keyboardpartner/HX3/HX_source/Reverb/readme.md

HX3 Reverb Sources
==================

HX3 Reverb DSP sources and project to be assembled with free SPIN IDE from Spin Semiconductor:

http://www.spinsemi.com/products.html

You might try your own reverb algorithm or one of the many examples found on the Spin Semi web page. Please note the controller pot usage in xxx_remap.spn assembler sources. HOAX3.spj is a complete project for the HX3 Reverb DSP, consisting of several reverb programs. Use tool hex2bin.exe to create a uploadable .BIN file. May be uploaded to HX3 with HX3 Remote software.

(c) by Carsten Meyer, cm@ct.de and KeyboardPartner UG, 1/2012.
