keyboardpartner/HX3/PLATINEN/MenuPanel/README.md

HX3 MenuPanel
=============

Schematics (schem), board placement (silk) and mechanical drawings (dim) for HX3 MenuPanel board as PDF (click on "view raw" to download), both for DAUB (daub) and GIE-TEC/Schaeffer (42mm) aluminum boxes.

".FPD" files are front bezel and back panel suggestions for Schaeffer AG Frontplattendesigner software (http://www.schaeffer-ag.de/de/download/frontplatten-designer.html) where you may order custom made front panels.
