keyboardpartner/HX3/PLATINEN/Preamp/PreAmp-Schematic.pdf

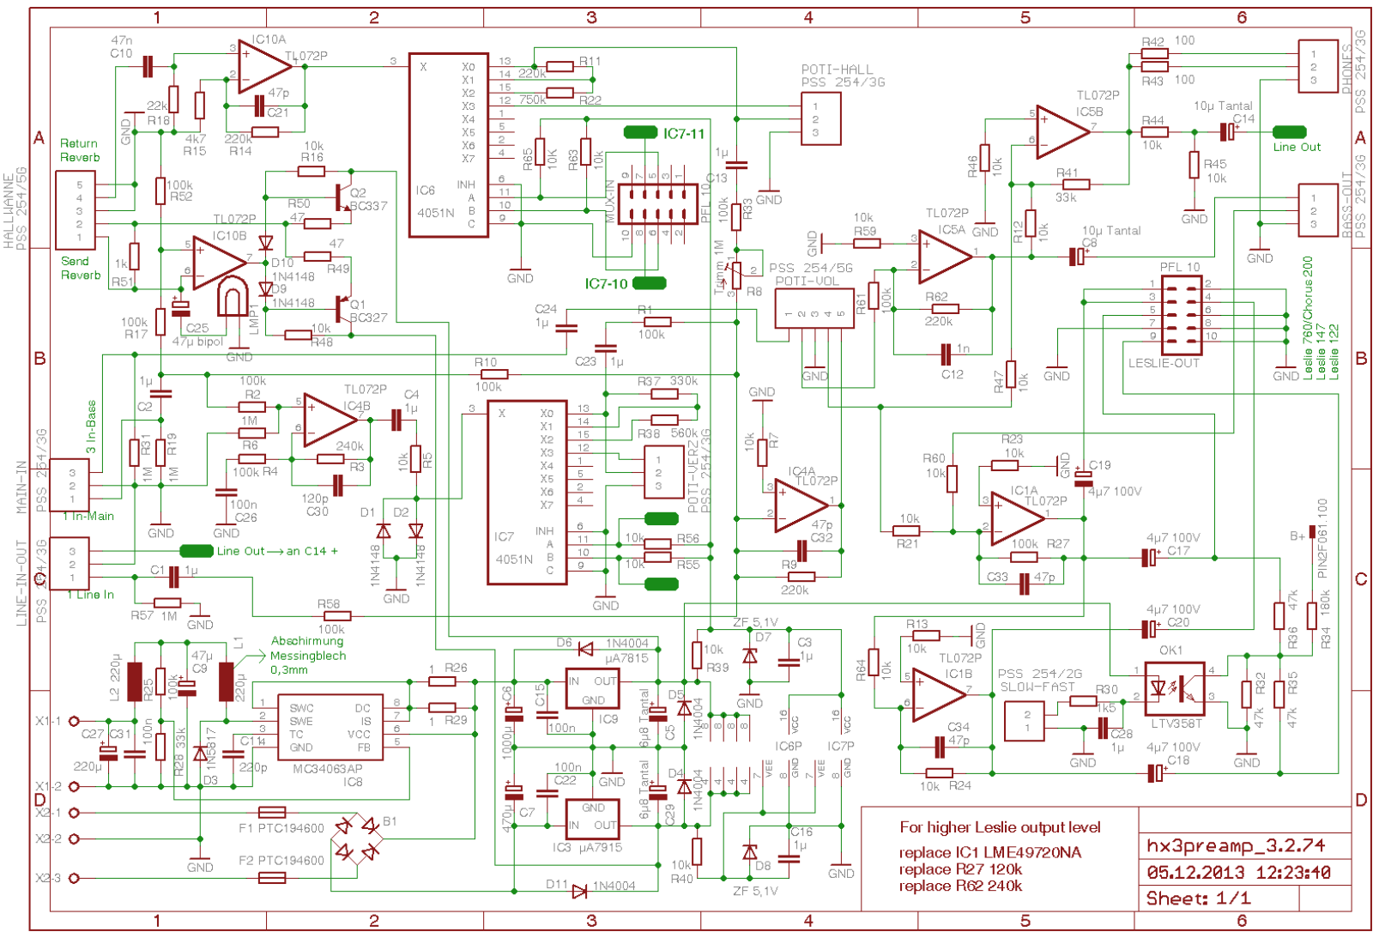
[picture p1: page 1]
