keyboardpartner/HX3/ARCHIVED_FIRMW/readme.md

HX3 Archived Firmware
=====================

<b>Archived older firmware</b>

Please note: These files are intended for reference use only and may contain known bugs.
Current firmwares may be found on **[LATEST] (https://github.com/keyboardpartner/HX3/tree/master/LATEST)** page.
