keyboardpartner/HX3/FOR_OEM/hoax_fuses.png

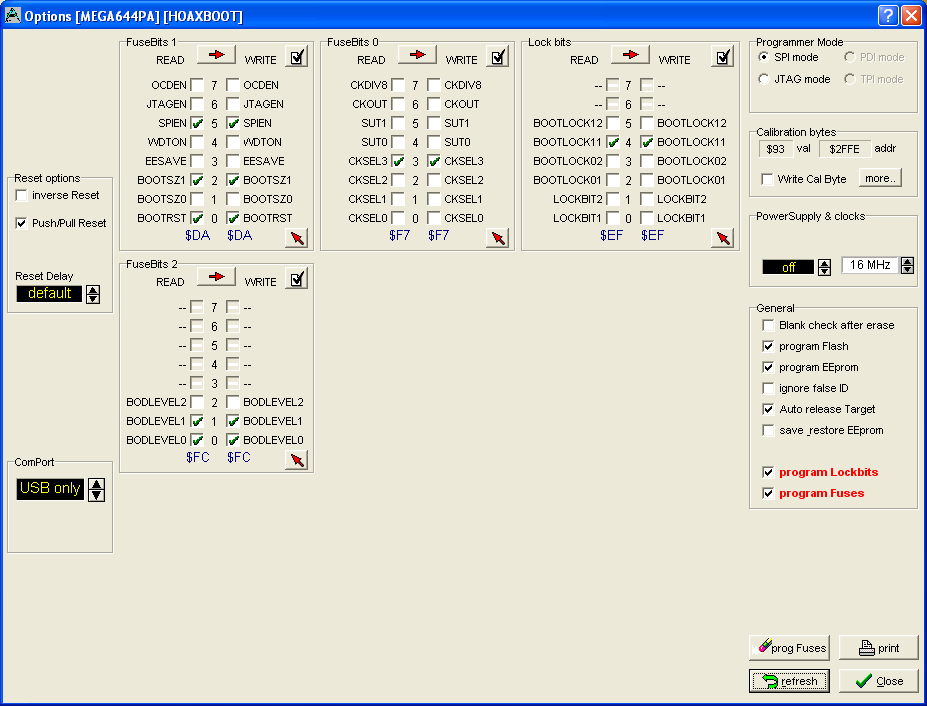
FOR_OEM/hoax_fuses.png
