keyboardpartner/HX3/(list of files, cad)

Other CAD files:
HX_source/Scan/HX_fatar.psm
HX_source/Scan/HX_fatar_33.psm
HX_source/Scan/HX_midi.psm
HX_source/Scan/HX_midi_33.psm
