keyboardpartner/HX3/(threads)

Thread 1 (2016-11-03):

Rotary not working with v4.20 BETA

BobMander, 2016-11-03:
I have a Plexi HX3. I downloaded the v4.20 BETA to test the new "TG Gears Tune" which does absolutely exactly what I was hoping it would do. I like to tune myself down to 432Hz rather than be at the ISO 440Hz. THANK YOU, THANK YOU, THANK YOU!!!

I did notice that the Rotary does not work with this BETA. The Rotary License does show as 'OK' but nothing I did in AudioJack settings [with the v4.11 HX3 Remote] allowed me to hear audio through the L/R Rotary. ORGAN and AMP both produce audio sound in the AudioJack settings.

I reverted back to v4.11 and all is well for now. Will wait for the final v4.20.
