keyboardpartner/HX3/PLATINEN/Bass25/schem_MIDIbass25_scan.pdf

PL9

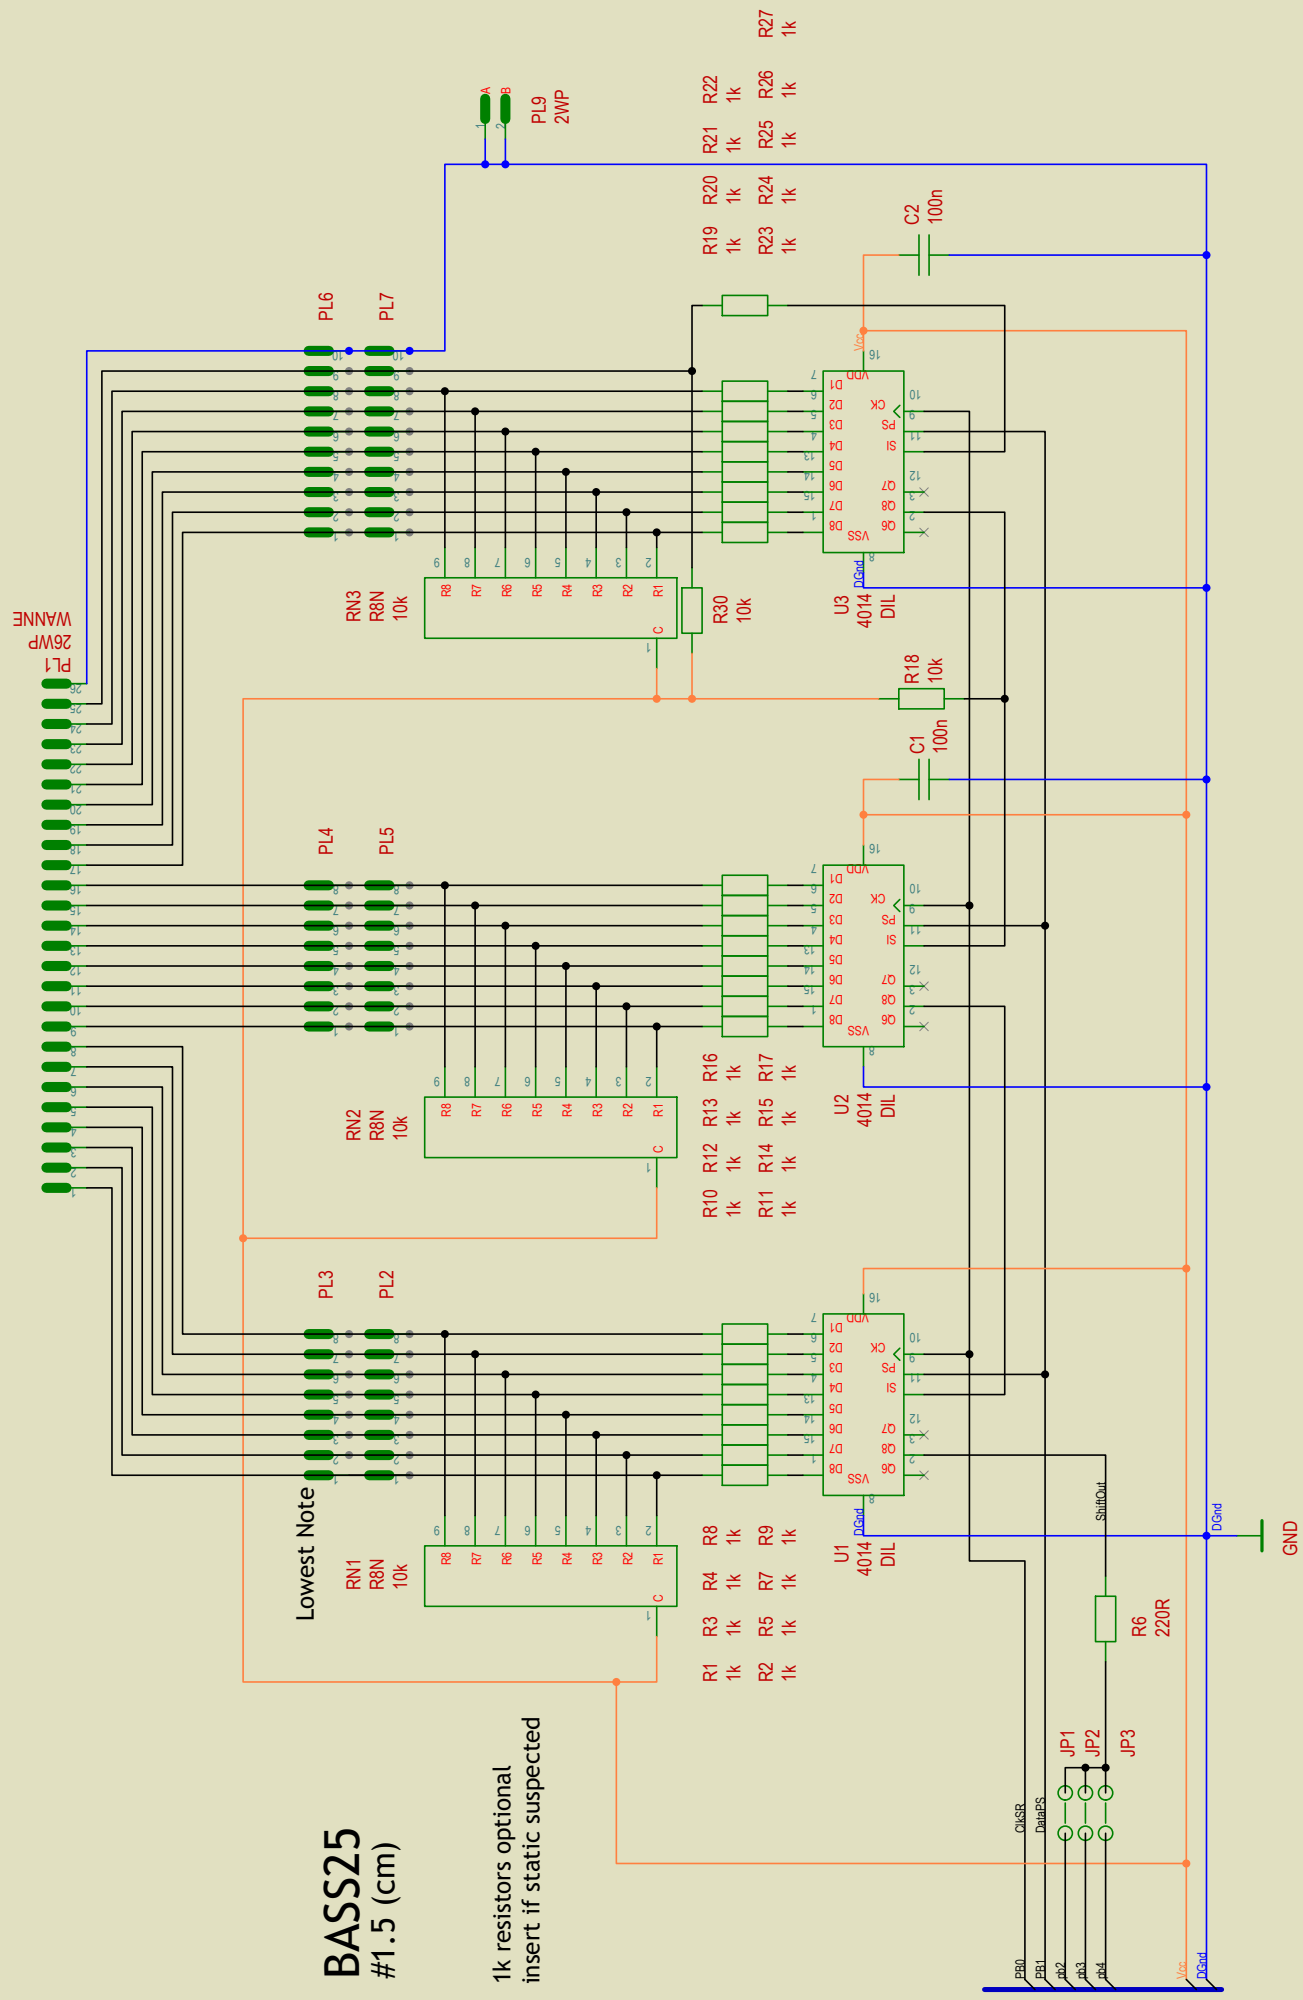
[picture p28: page 1]

insert if static suspected
