keyboardpartner/HX3/PLATINEN/XB2_mk3/best_10k_XB2_IF_30.pdf

# XB2 Output Board 3.0b

# Bestückung mit 10k-Potis

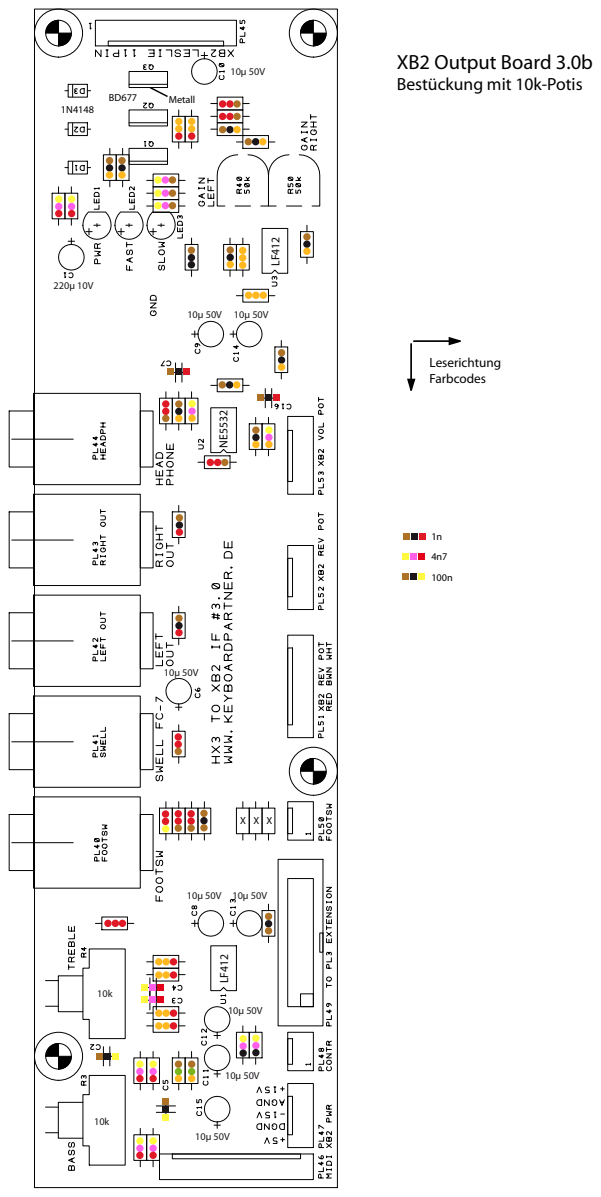
[picture p29: page 1]
Metall; Leserichtung Farbcodes
