keyboardpartner/HX3/PLATINEN/XB2_mk3/best_50k_XB2_IF_30.pdf

# XB2 Output Board 3.0b

# Bestückung mit 50k-Potis

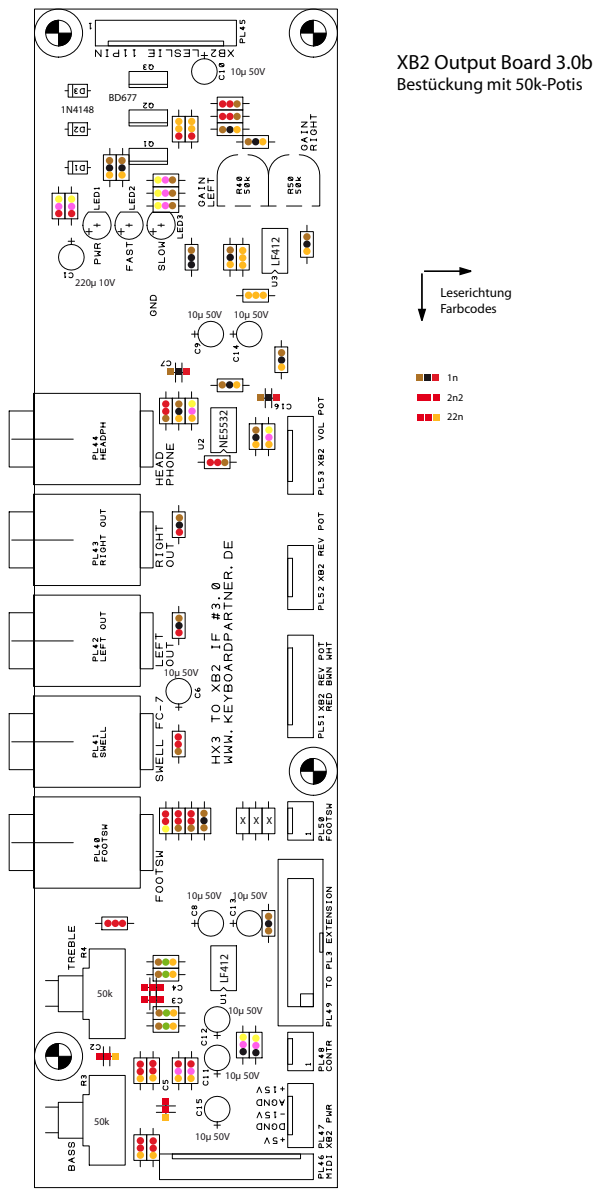
[picture p30: page 1]
Leserichtung Farbcodes
