keyboardpartner/HX3/PLATINEN/Extension_mk3/HX3_extension_best.pdf

# HX3 mk3/4 Extension Board Part Values

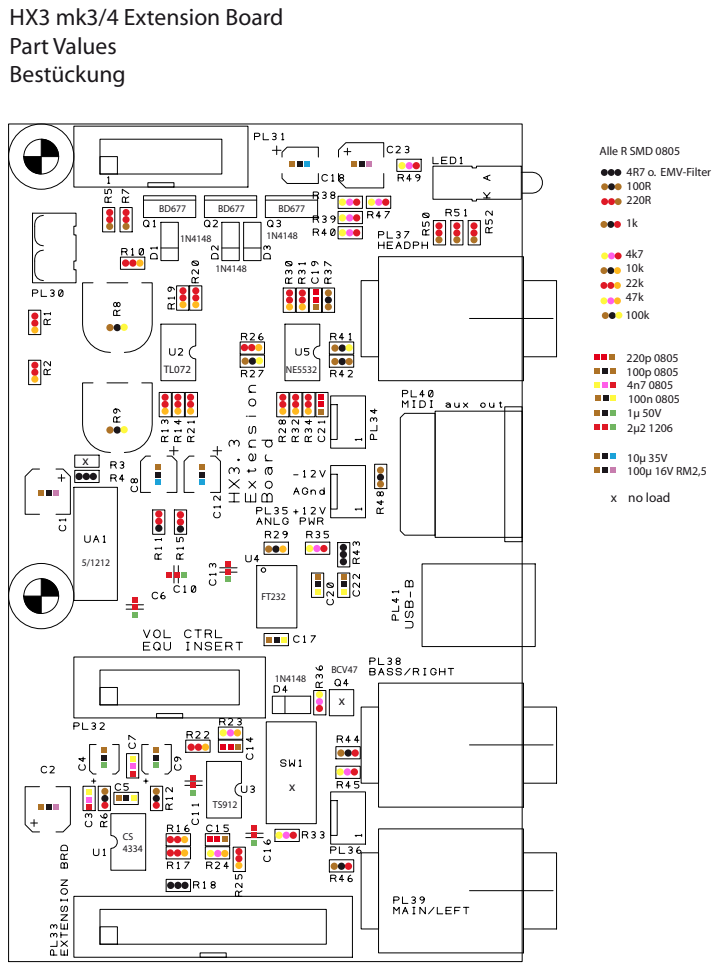
[picture p31: page 1]
BCV47; Alle R SMD 0805; 4R7 o. EMV-Filter 100R 220R; x no load; Bestückung
