keyboardpartner/HX3/PLATINEN/Adapter/schem_LDR_Leslie_IF.pdf

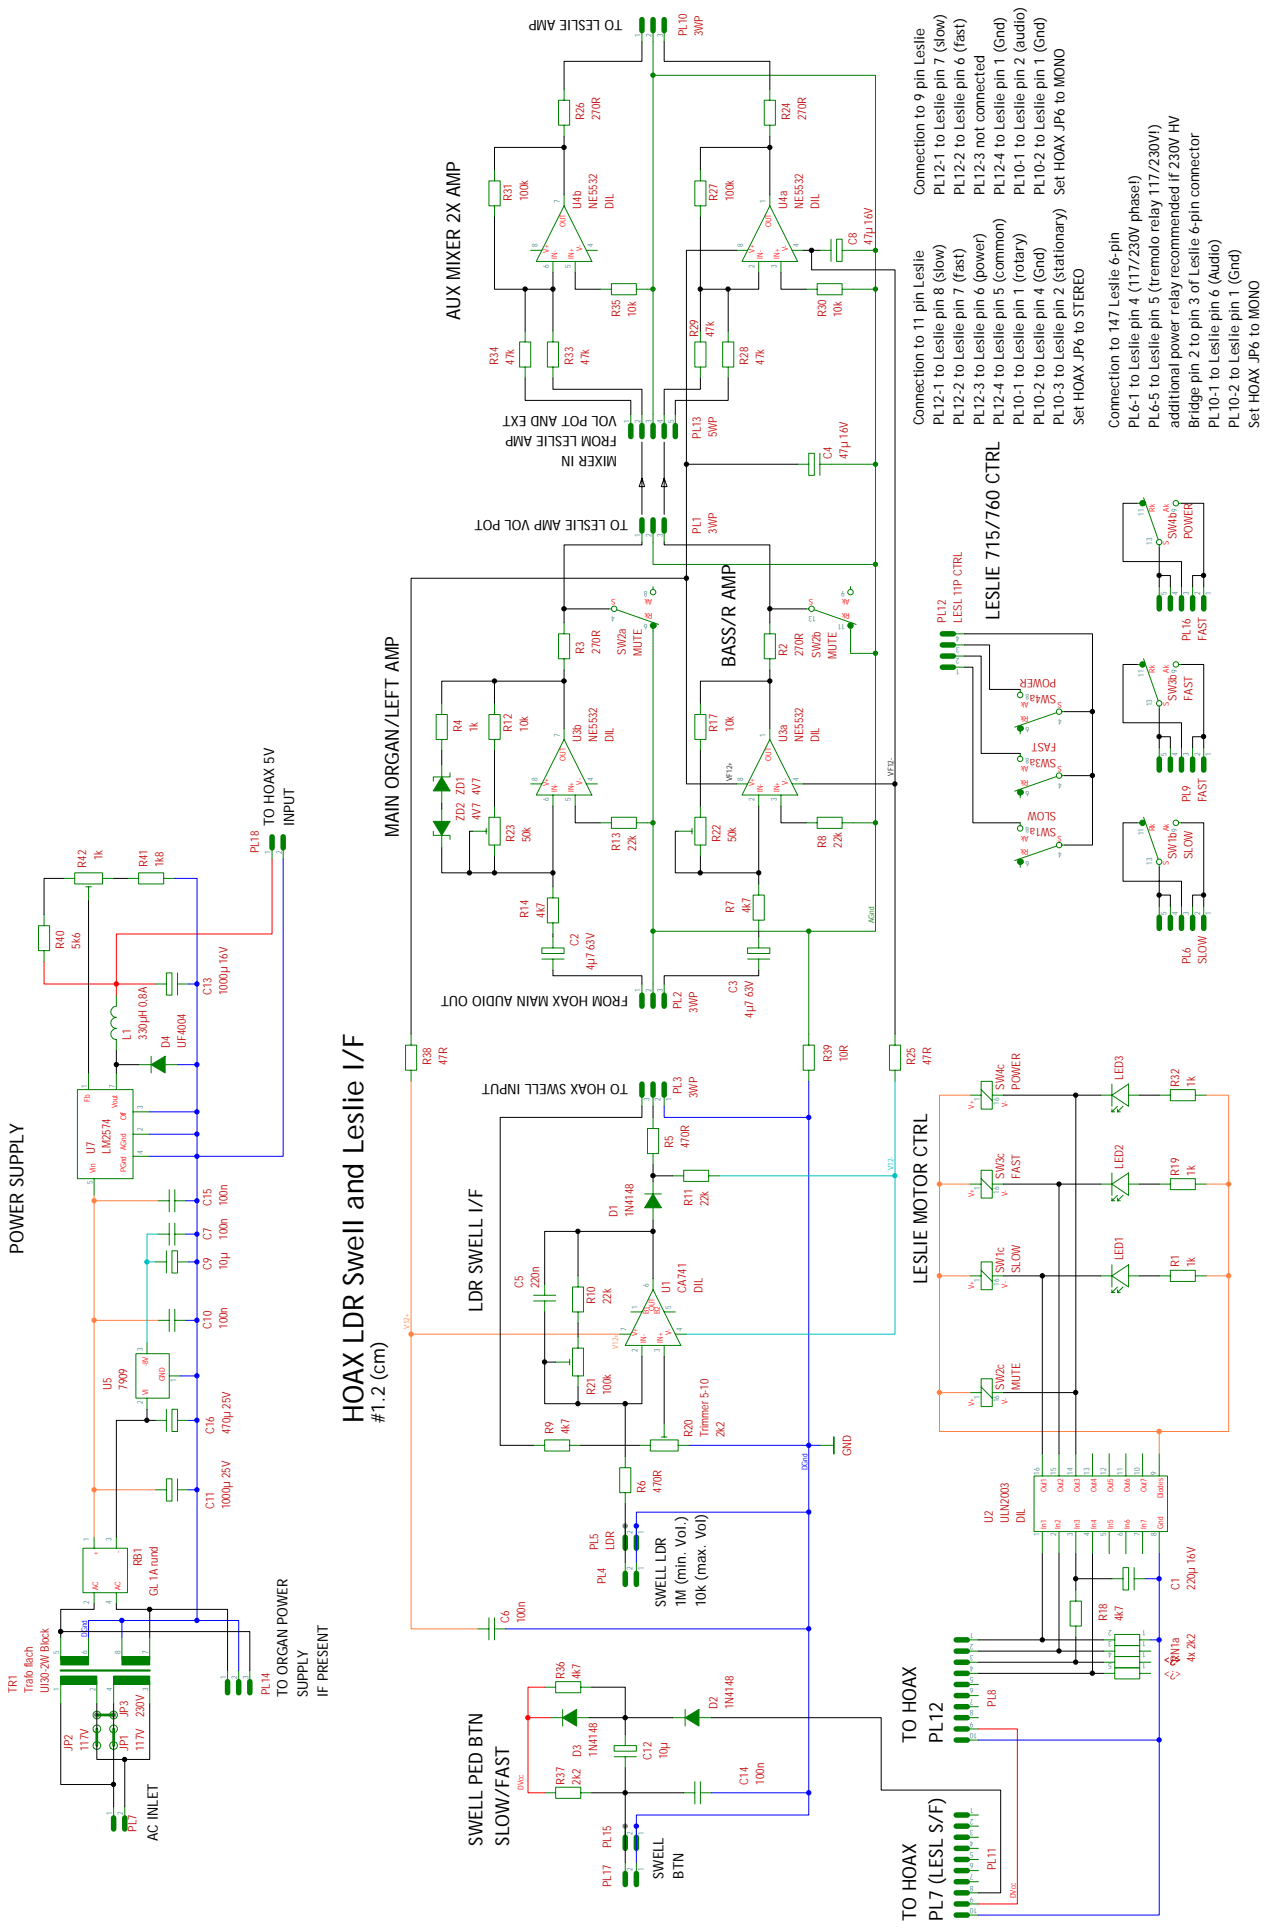
[picture p32: page 1]

PL10-1 to Leslie pin 2 (audio)

Connection to 9 pin Leslie

PL12-1 to Leslie pin 7 (slow)

PL12-2 to Leslie pin 6 (fast)

PL12-4 to Leslie pin 1 (Gnd)

PL10-2 to Leslie pin 1 (Gnd)

Set HOAX JP6 to MONO

PL6-5 to Leslie pin 5 (tremolo relay 117/230V!)

additional power relay recommended if 230V HV

Bridge pin 2 to pin 3 of Leslie 6-pin connector

PL6-1 to Leslie pin 4 (117/230V phase!)

PL12-4 to Leslie pin 5 (common)

PL10-3 to Leslie pin 2 (stationary)

PL12-3 to Leslie pin 6 (power)

PL10-1 to Leslie pin 1 (rotary)

Connection to 147 Leslie 6-pin

PL10-1 to Leslie pin 6 (Audio)

Connection to 11 pin Leslie

PL12-1 to Leslie pin 8 (slow)

PL12-2 to Leslie pin 7 (fast)

PL10-2 to Leslie pin 4 (Gnd)

Set HOAX JP6 to STEREO

MAIN ORGAN/LEFT AMP

HOAX LDR Swell and Leslie I/F
