keyboardpartner/HX3/PLATINEN/Adapter/schem_XB2_IF_AMP.pdf

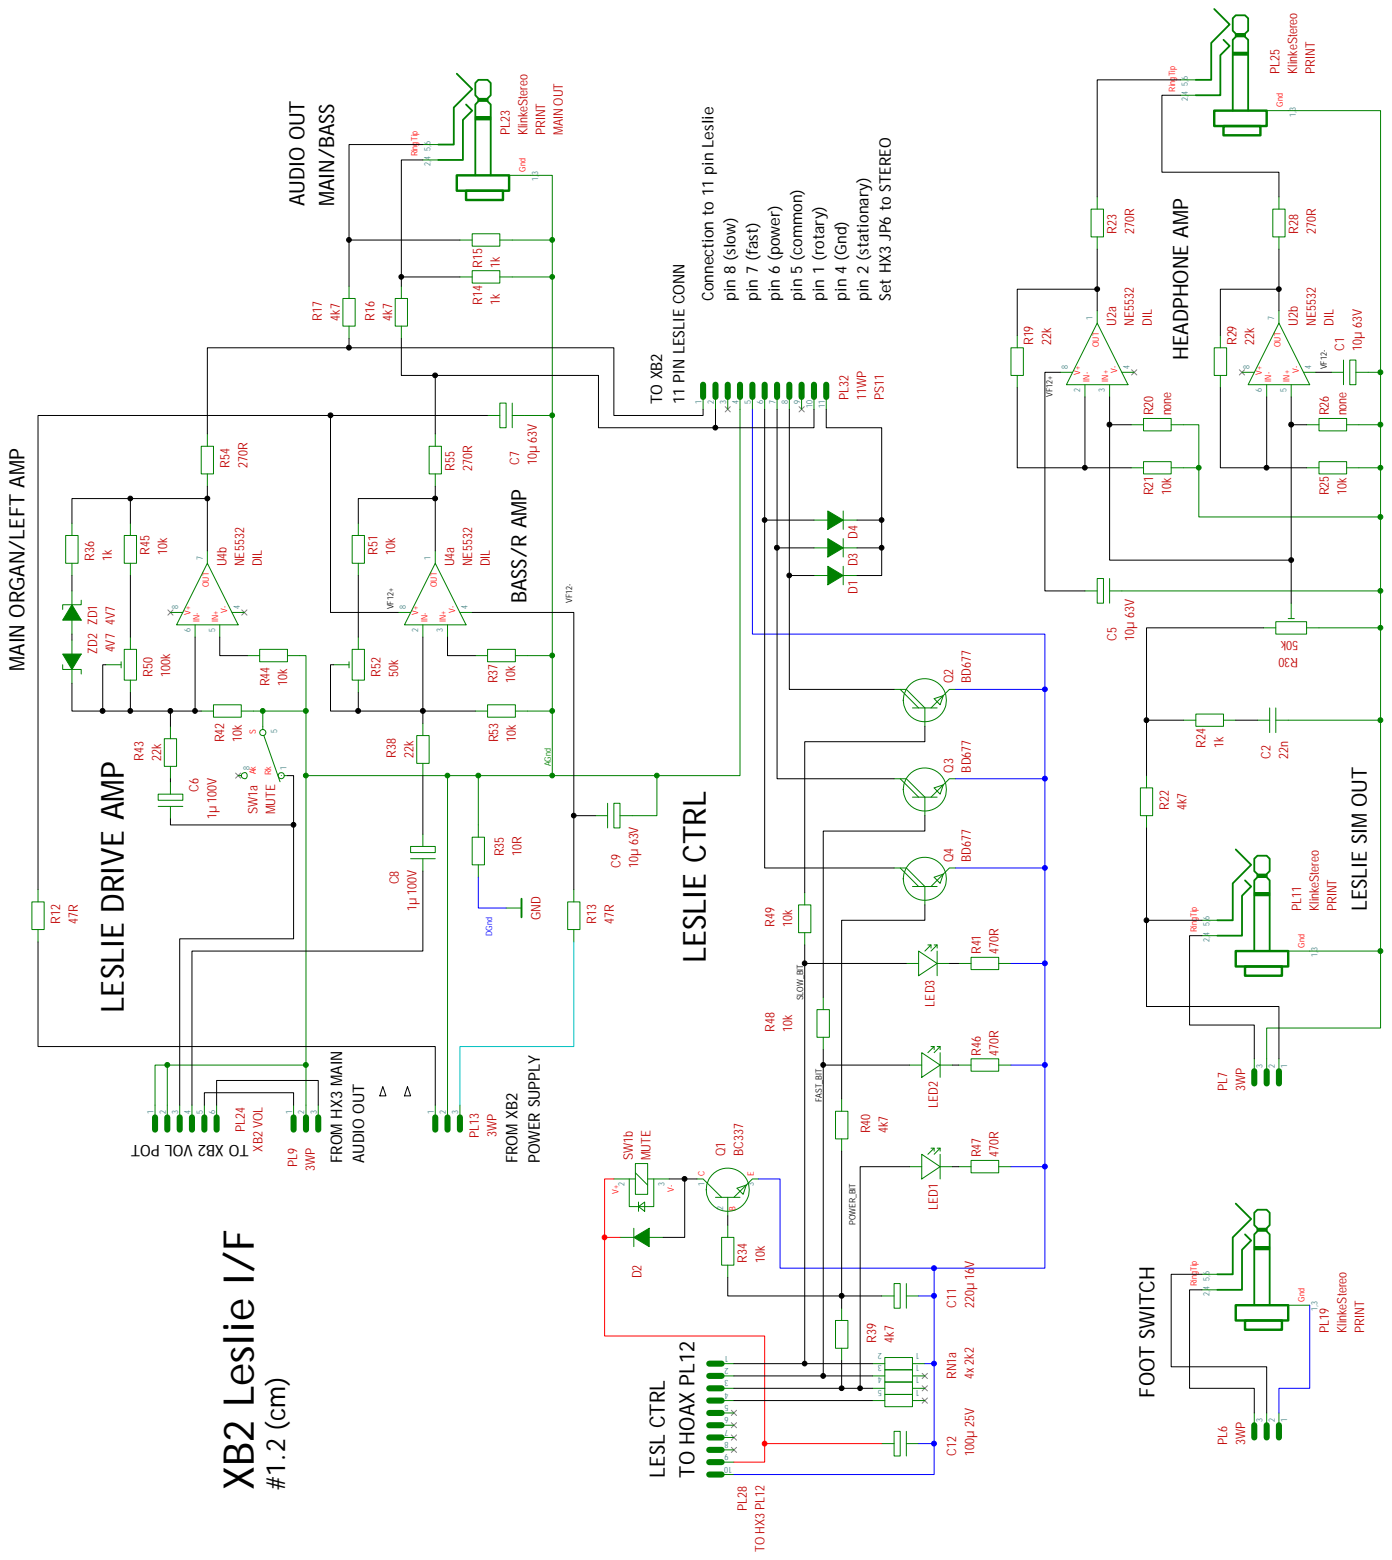
[picture p33: page 1]

Connection to 11 pin Leslie

11 PIN LESLIE CONN LESLIE CTRL

MAIN ORGAN/LEFT AMP
