keyboardpartner/HX3/PLATINEN/Leslie_IF/best_LDR_Leslie_IF.pdf

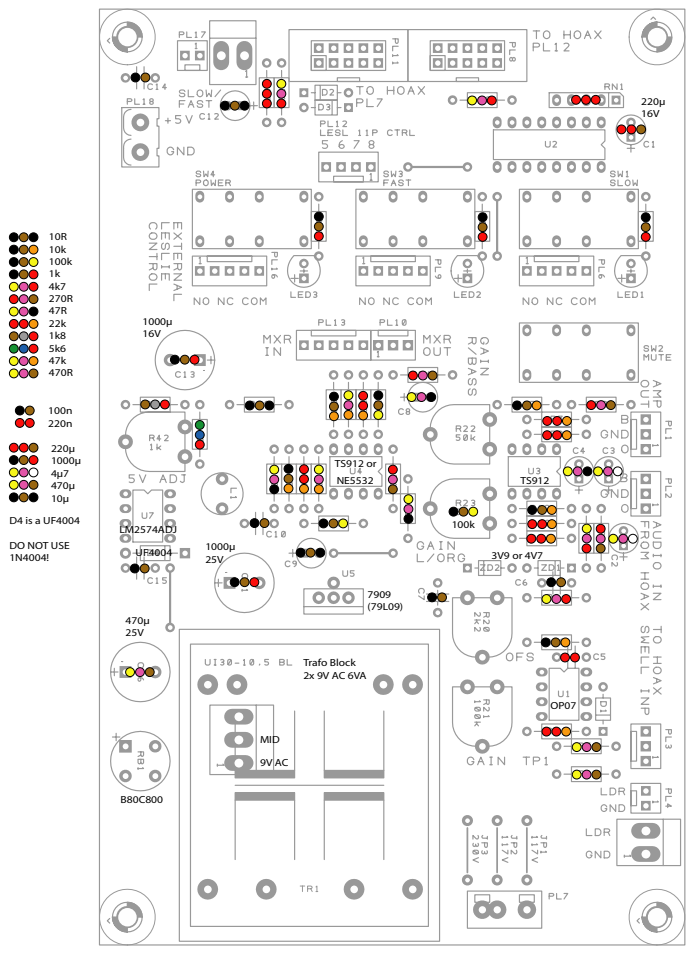
[picture p34: page 1]
LM2574ADJ; Trafo Block 2x 9V AC 6VA; MID

DO NOT USE
