keyboardpartner/HX3/PLATINEN/Leslie_IF/schem_LDR_Leslie_IF_new.pdf

# HOAX LDR Swell and Leslie I/F Board

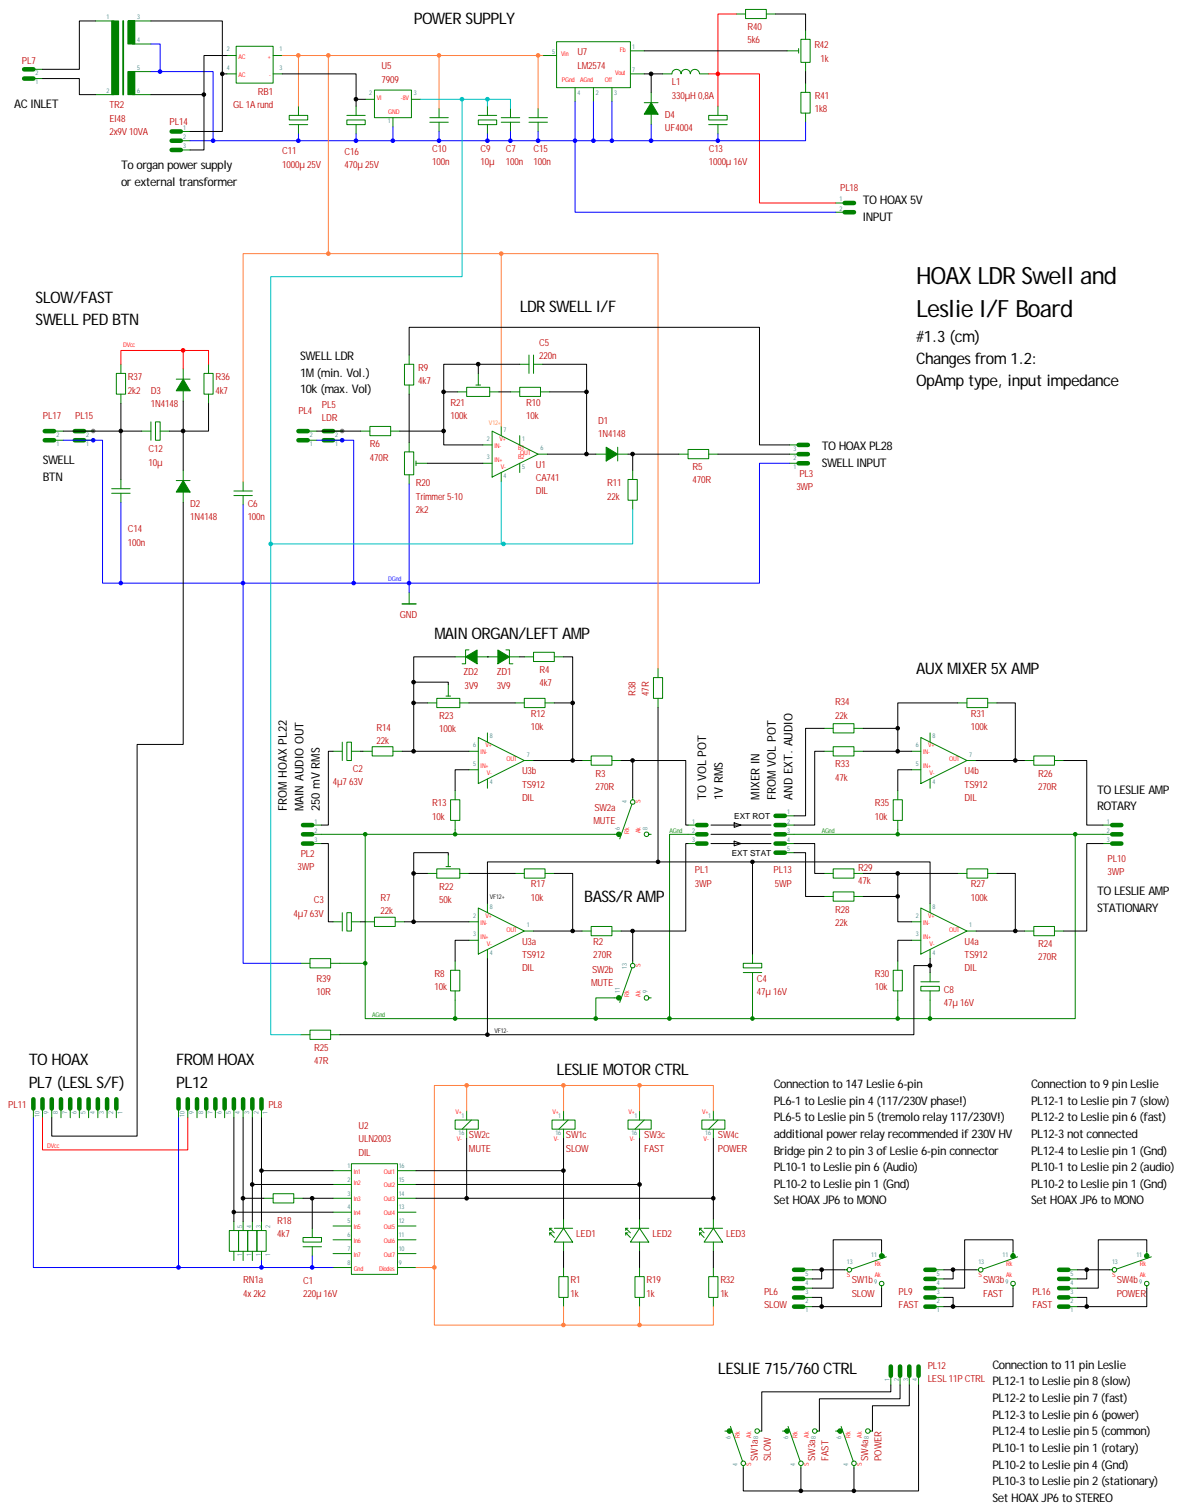
[picture p35: page 1]

To organ power supply
or external transformer

Changes from 1.2:
OpAmp type, input impedance

GND
MAIN ORGAN/LEFT AMP

Connection to 147 Leslie 6-pin
PL6-1 to Leslie pin 4 (117/230V phase!)
PL6-5 to Leslie pin 5 (tremolo relay 117/230V!)
additional power relay recommended if 230V HV
Bridge pin 2 to pin 3 of Leslie 6-pin connector
PL10-1 to Leslie pin 6 (Audio)

Connection to 9 pin Leslie
PL12-1 to Leslie pin 7 (slow)
PL12-2 to Leslie pin 6 (fast)
PL12-3 not connected
PL12-4 to Leslie pin 1 (Gnd)
PL10-1 to Leslie pin 2 (audio)

PL10-2 to Leslie pin 1 (Gnd)
Set HOAX JP6 to MONO

Connection to 11 pin Leslie
PL12-1 to Leslie pin 8 (slow)
PL12-2 to Leslie pin 7 (fast)
PL12-3 to Leslie pin 6 (power)
PL12-4 to Leslie pin 5 (common)
PL10-1 to Leslie pin 1 (rotary)
PL10-2 to Leslie pin 4 (Gnd)
PL10-3 to Leslie pin 2 (stationary)
Set HOAX JP6 to STEREO
