keyboardpartner/HX3/PLATINEN/MenuPanel/DisplayPanel bestueckung.pdf

# MenuPanel 1.2 Bestückung

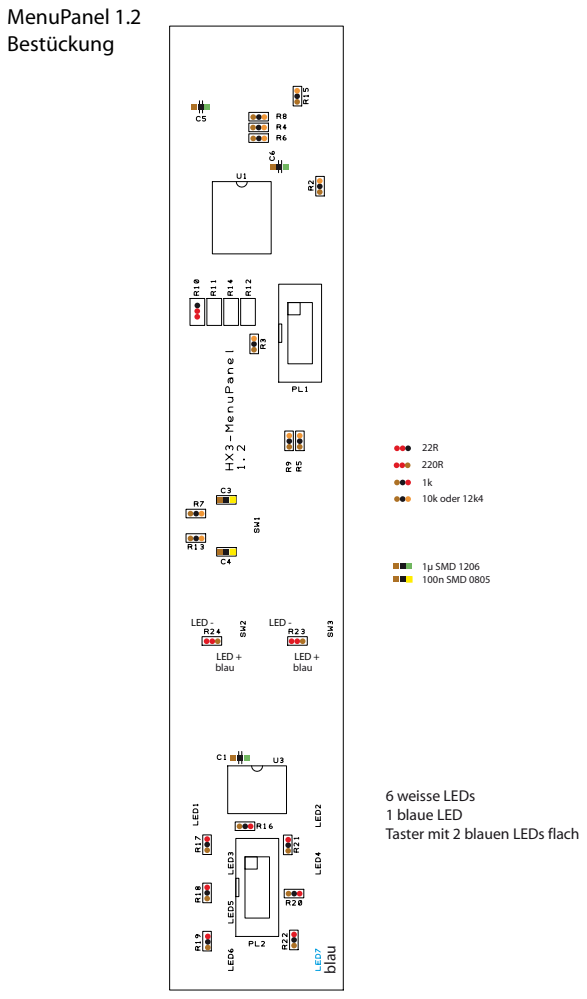
[picture p36: page 1]
1k 10k oder 12k4; 1µ SMD 1206 100n SMD 0805; blau; LED +; LED -

6 weisse LEDs
1 blaue LED
Taster mit 2 blauen LEDs flach
