keyboardpartner/HX3/PLATINEN/MenuPanel/DisplayPanel_std - PCB_bottom.pdf

# LED3

# LED4

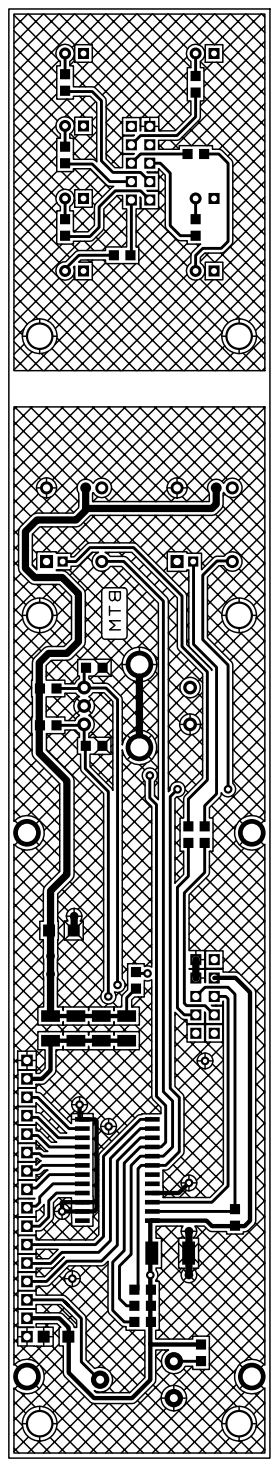
[picture p37: page 1]
