keyboardpartner/HX3/PLATINEN/MenuPanel/DisplayPanel_std - PCB_top.pdf

# LED3

# LED4

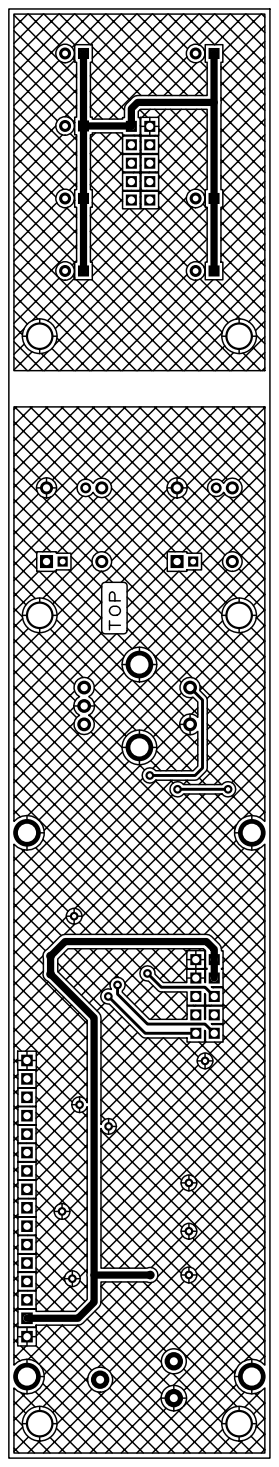
[picture p38: page 1]
