keyboardpartner/HX3/PLATINEN/MenuPanel/DisplayPanel_std_schem.pdf

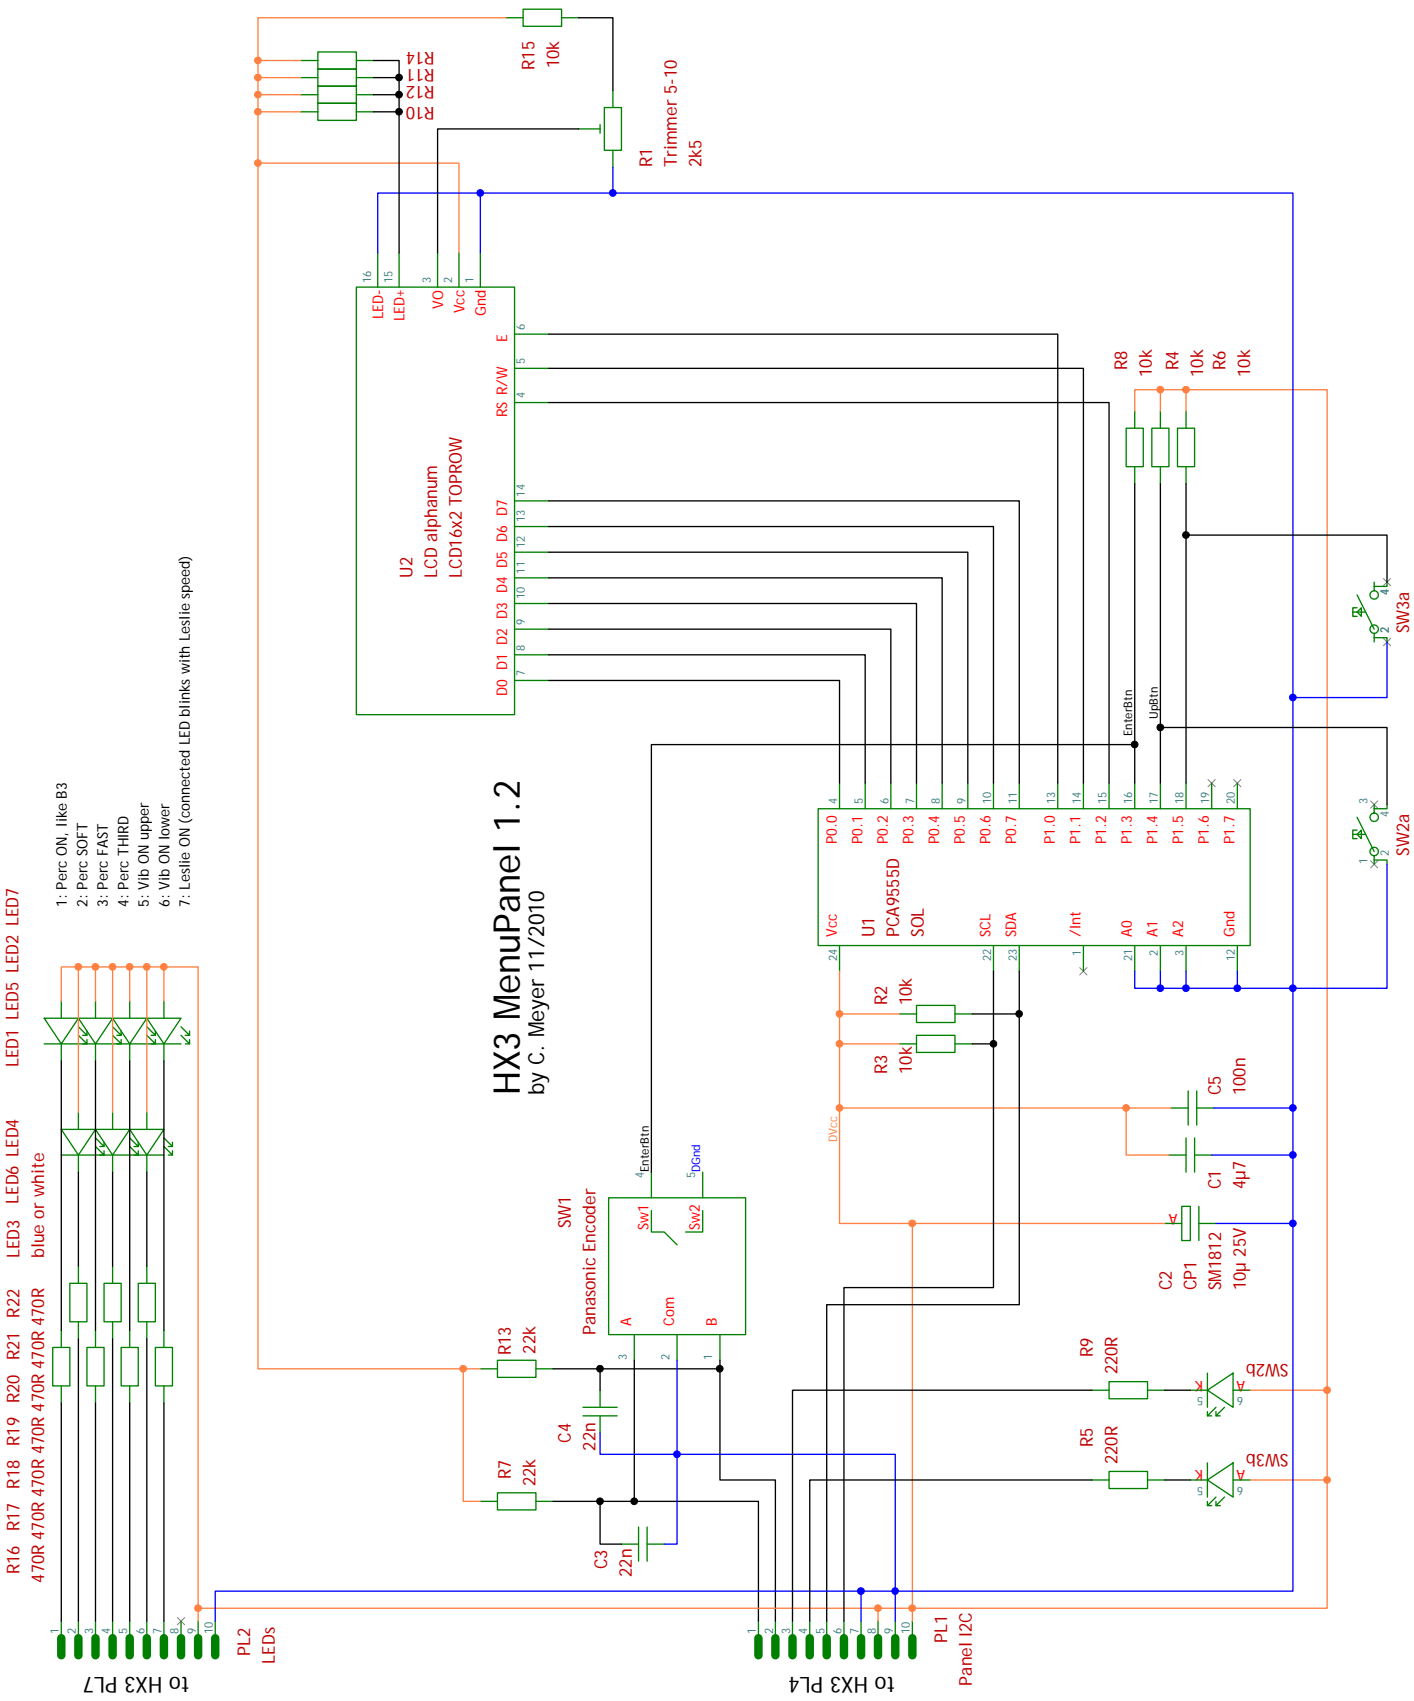
[picture p39: page 1]

7: Leslie ON (connected LED blinks with Leslie speed)
