keyboardpartner/HX3/PLATINEN/OrganScan61/schem_OrganScan61.pdf

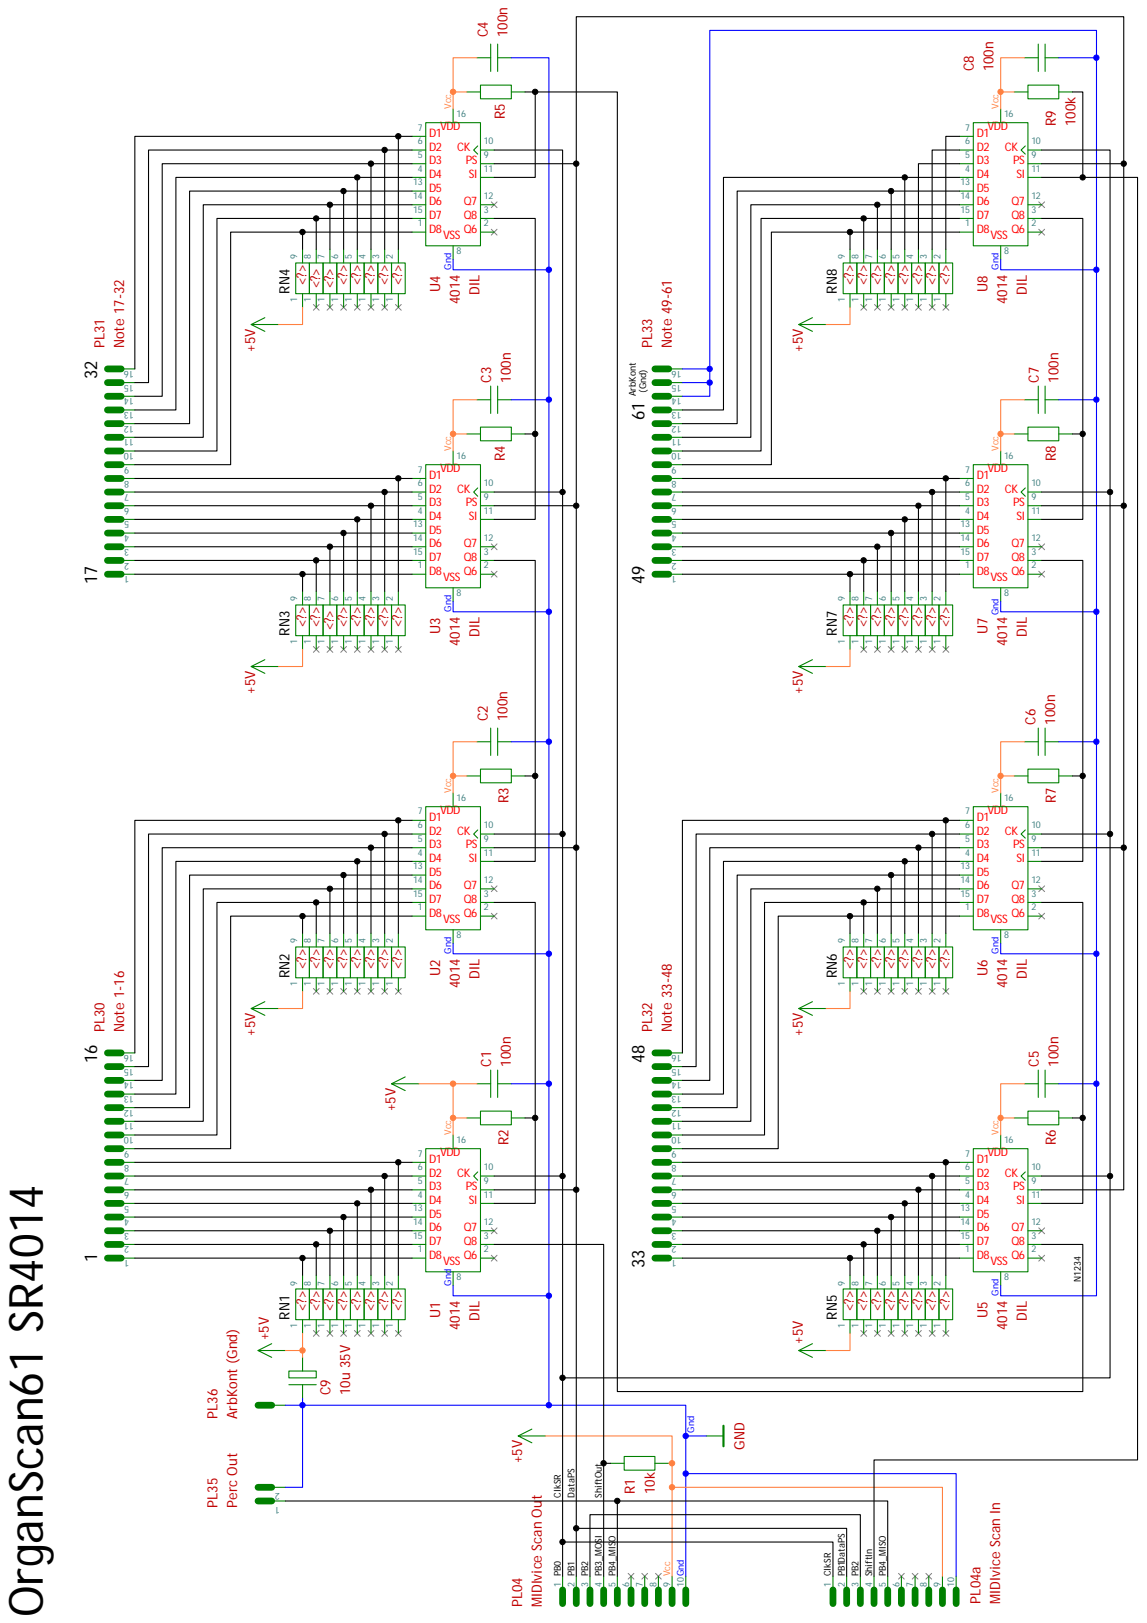
[picture p40: page 1]

Gnd Gnd
