keyboardpartner/HX3/PLATINEN/Panel16/schem_PANEL16.pdf

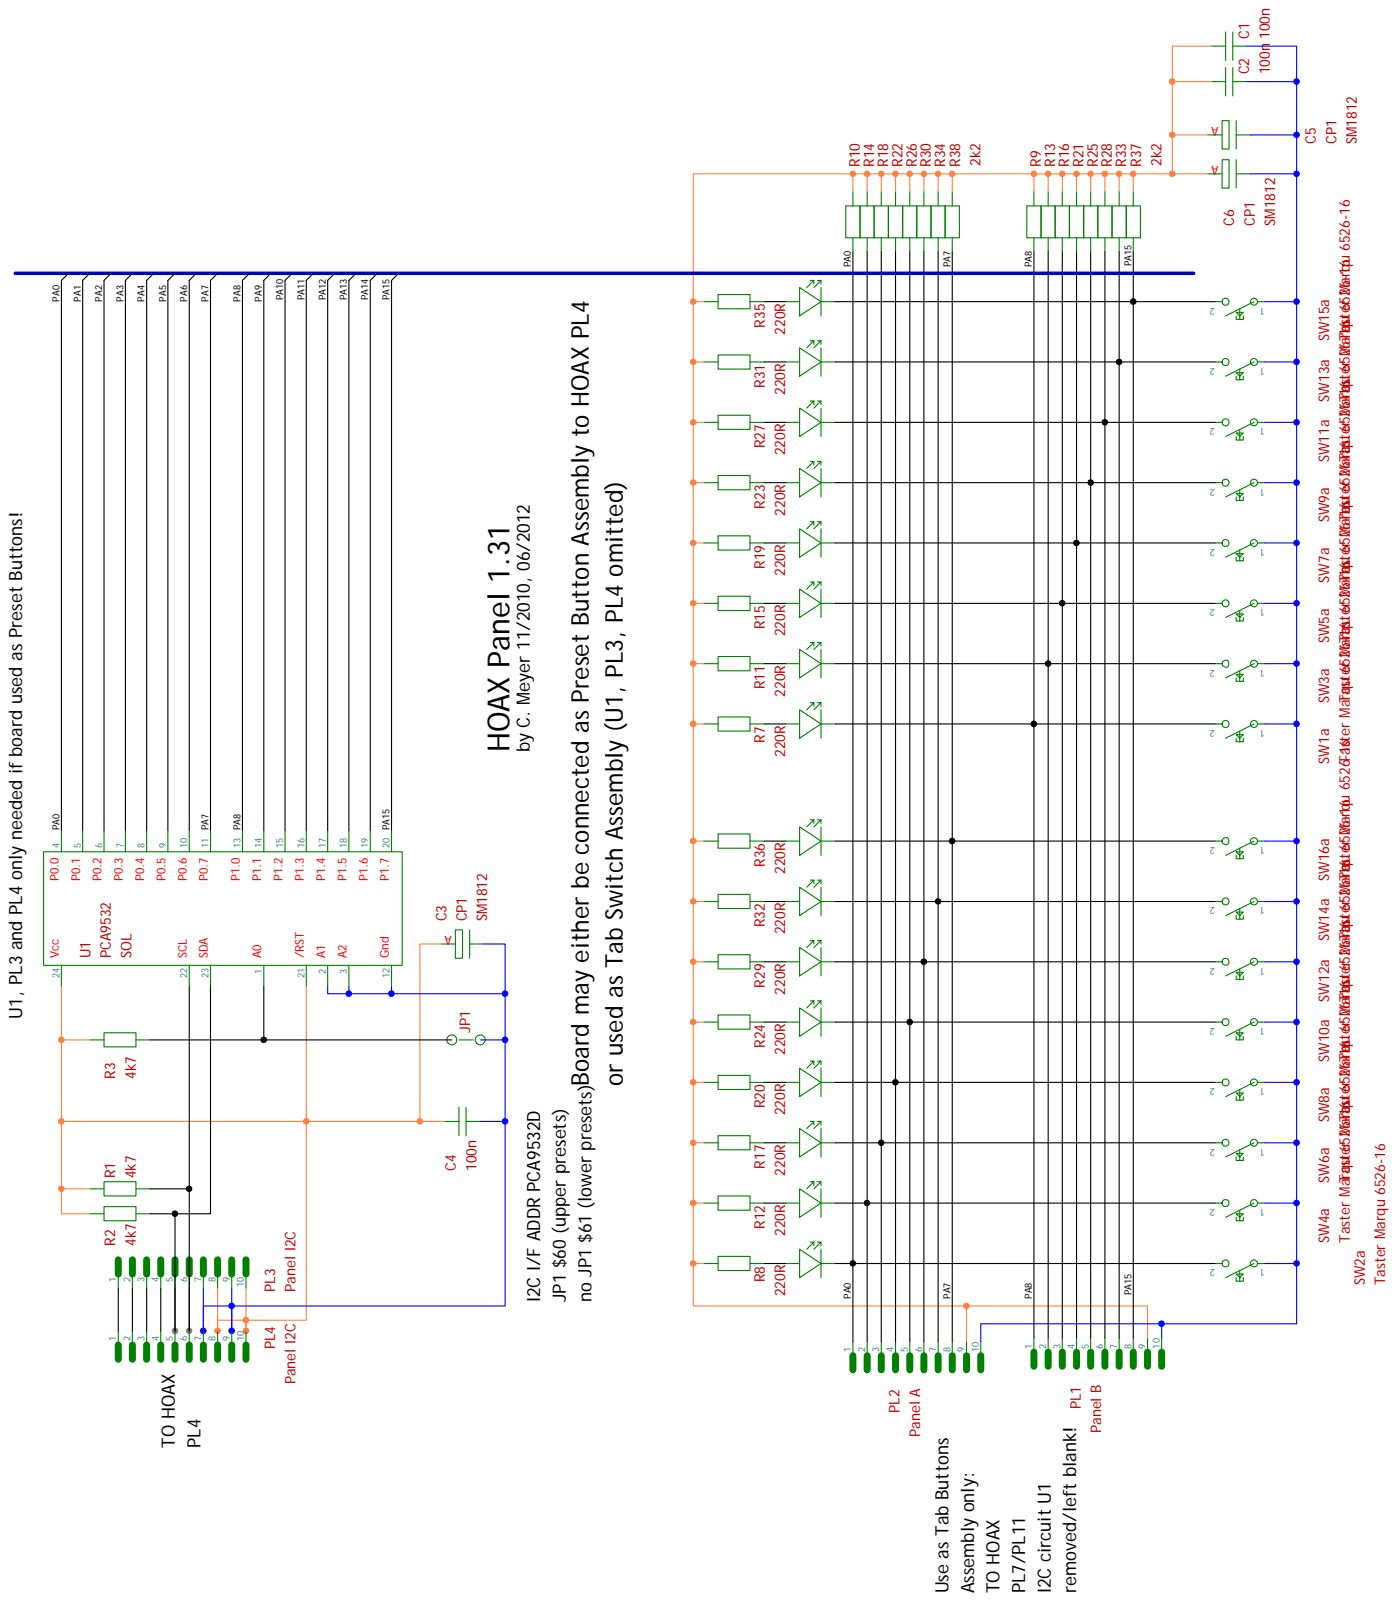
[picture p41: page 1]

Board may either be connected as Preset Button Assembly to HOAX PL4

or used as Tab Switch Assembly (U1, PL3, PL4 omitted)

U1, PL3 and PL4 only needed if board used as Preset Buttons!

Use as Tab Buttons
