keyboardpartner/HX3/PLATINEN/Preset12/schem_PRESET12_MPX.pdf

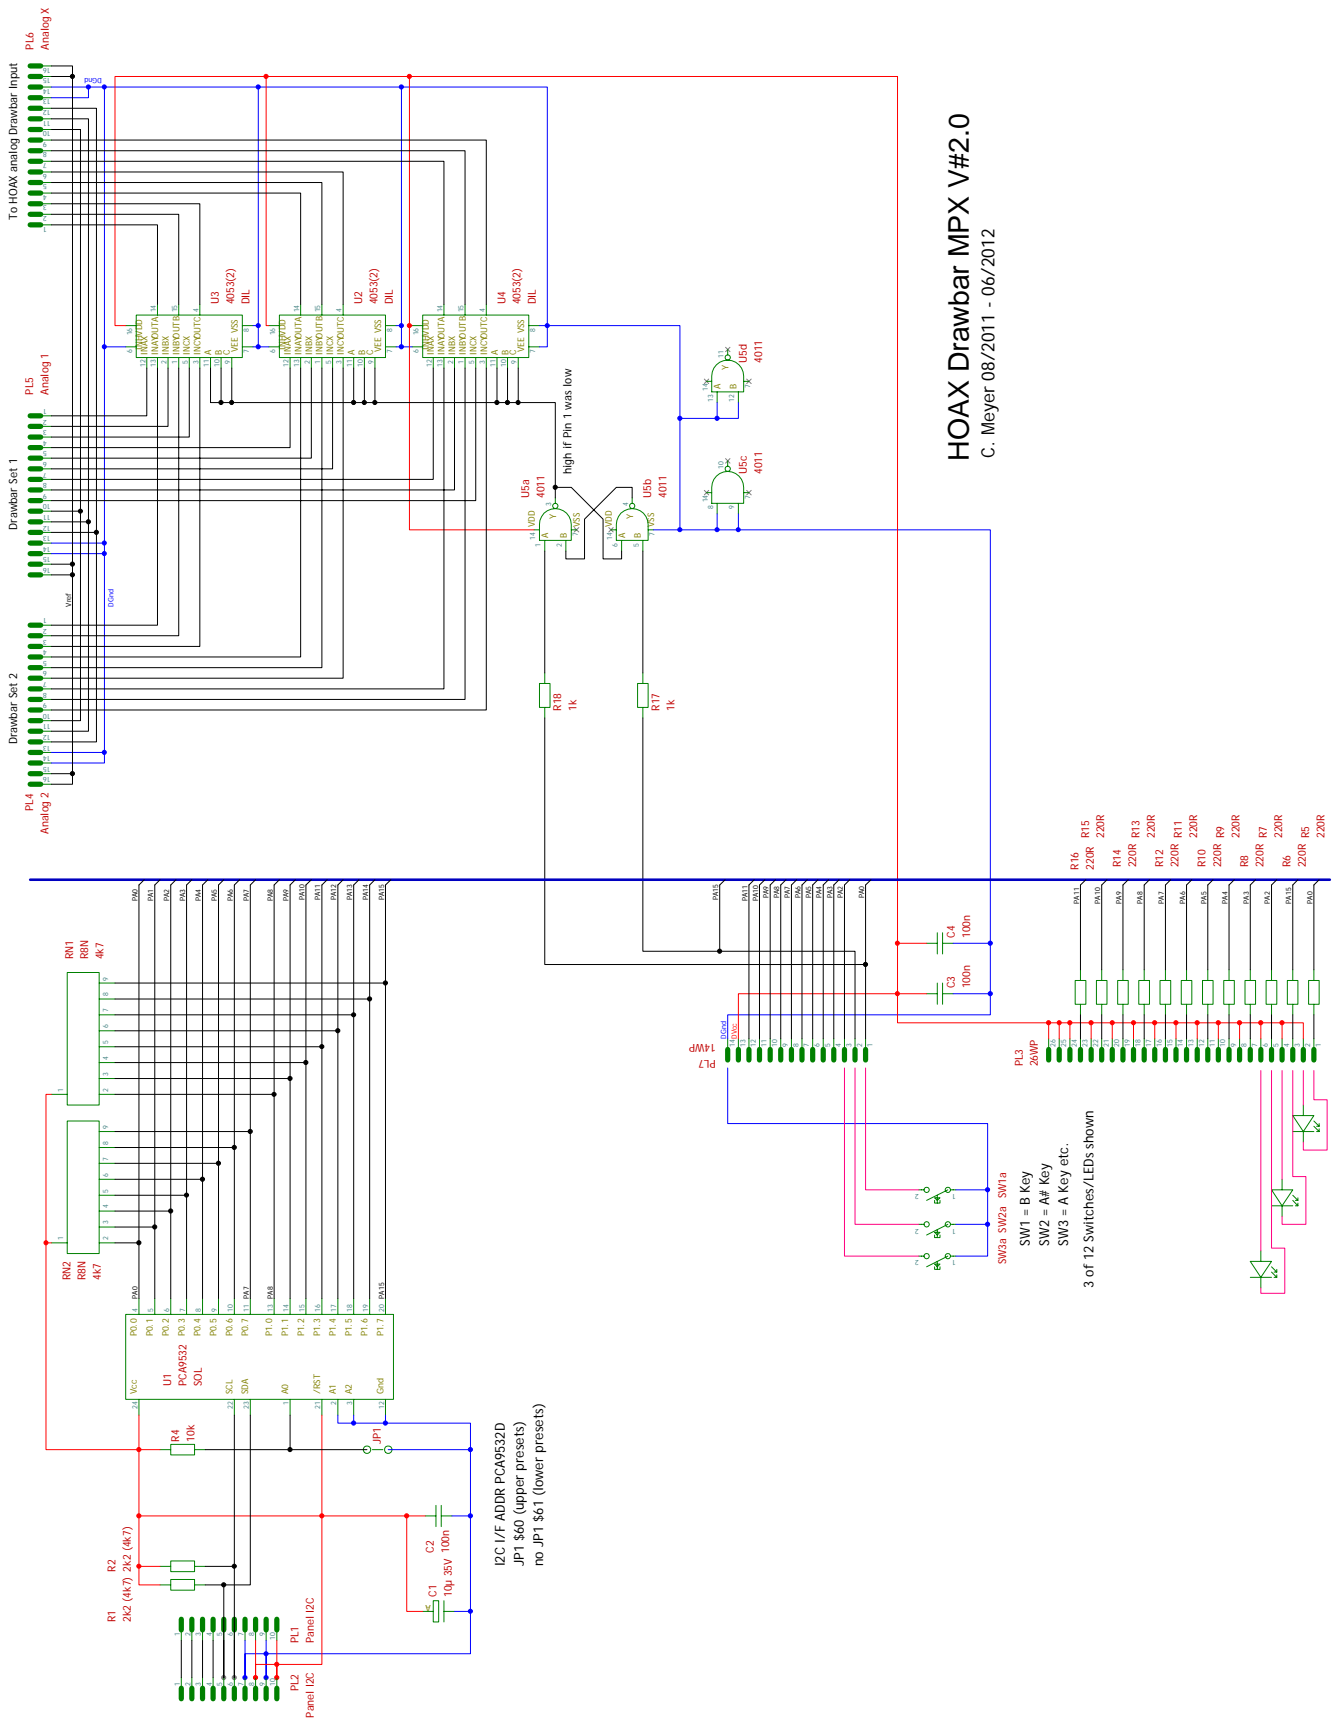
[picture p42: page 1]

Drawbar Set 2 Drawbar Set 1 To HOAX analog Drawbar Input

high if Pin 1 was low

3 of 12 Switches/LEDs shown
