keyboardpartner/HX3/PLATINEN/Preset24/schem_PRESET24_LED.pdf

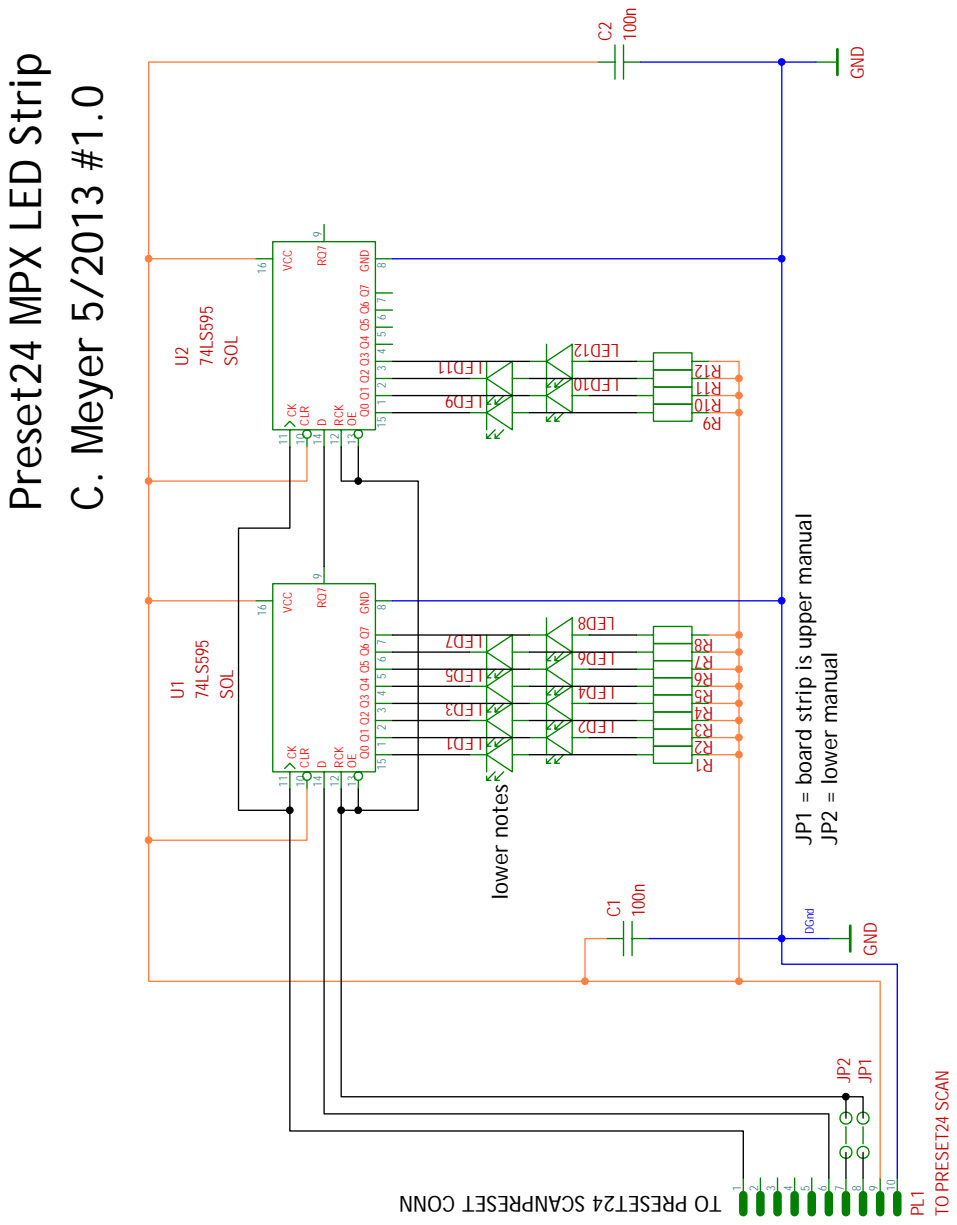
[picture p43: page 1]

JP1 = board strip is upper manual
