keyboardpartner/HX3/PLATINEN/Preset24/schem_PRESET24_MPX.pdf

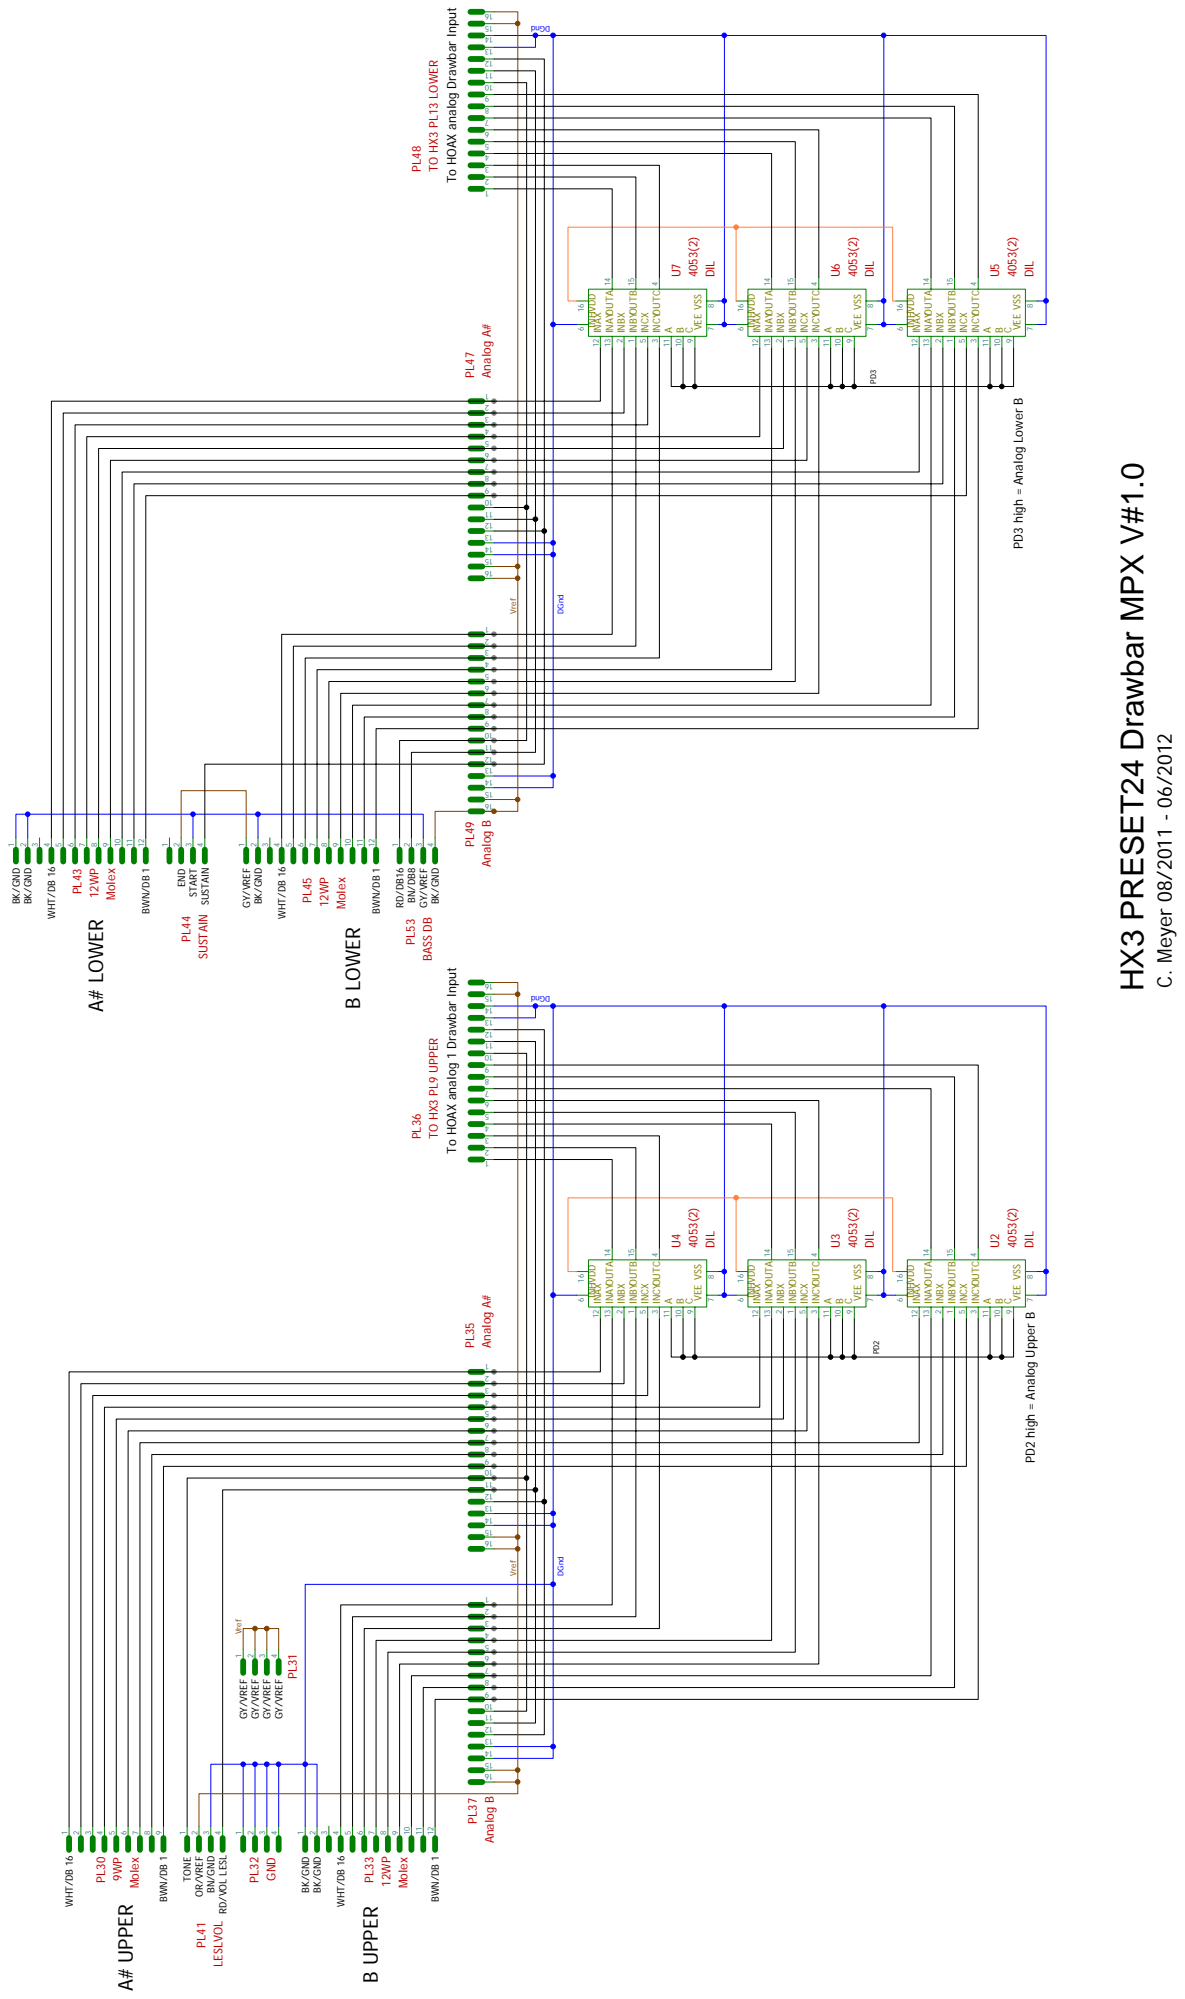
[picture p44: page 1]
HX3 PRESET24 Drawbar MPX V#1.0; C. Meyer 08/2011 - 06/2012; A# UPPER; A# LOWER; B LOWER; B UPPER; TONE; OR/VREF; BN/GND; WHT/DB 16; BWN/DB 1; END; START; BK/GND; SUSTAIN; GY/VREF; TO HX3 PL9 UPPER; INAX 12 INAY 13 INBX 2 INBY 1; INCX 5 INCY 3; VEE; VSS; INH; OUTC 4; OUTB 15; OUTA 14; VDD; DIL; Analog A# 123456789; Analog B; GND; Molex; LESLVOL; BASS DB; Analog B 123456789; TO HX3 PL13 LOWER; DGnd; Vref Vref; Vref

To HOAX analog Drawbar Input

PD3 high = Analog Lower B

To HOAX analog 1 Drawbar Input

PD2 high = Analog Upper B

RD/VOL LESL
