keyboardpartner/HX3/PLATINEN/Scan4014-16/schem_Scan4014-16.pdf

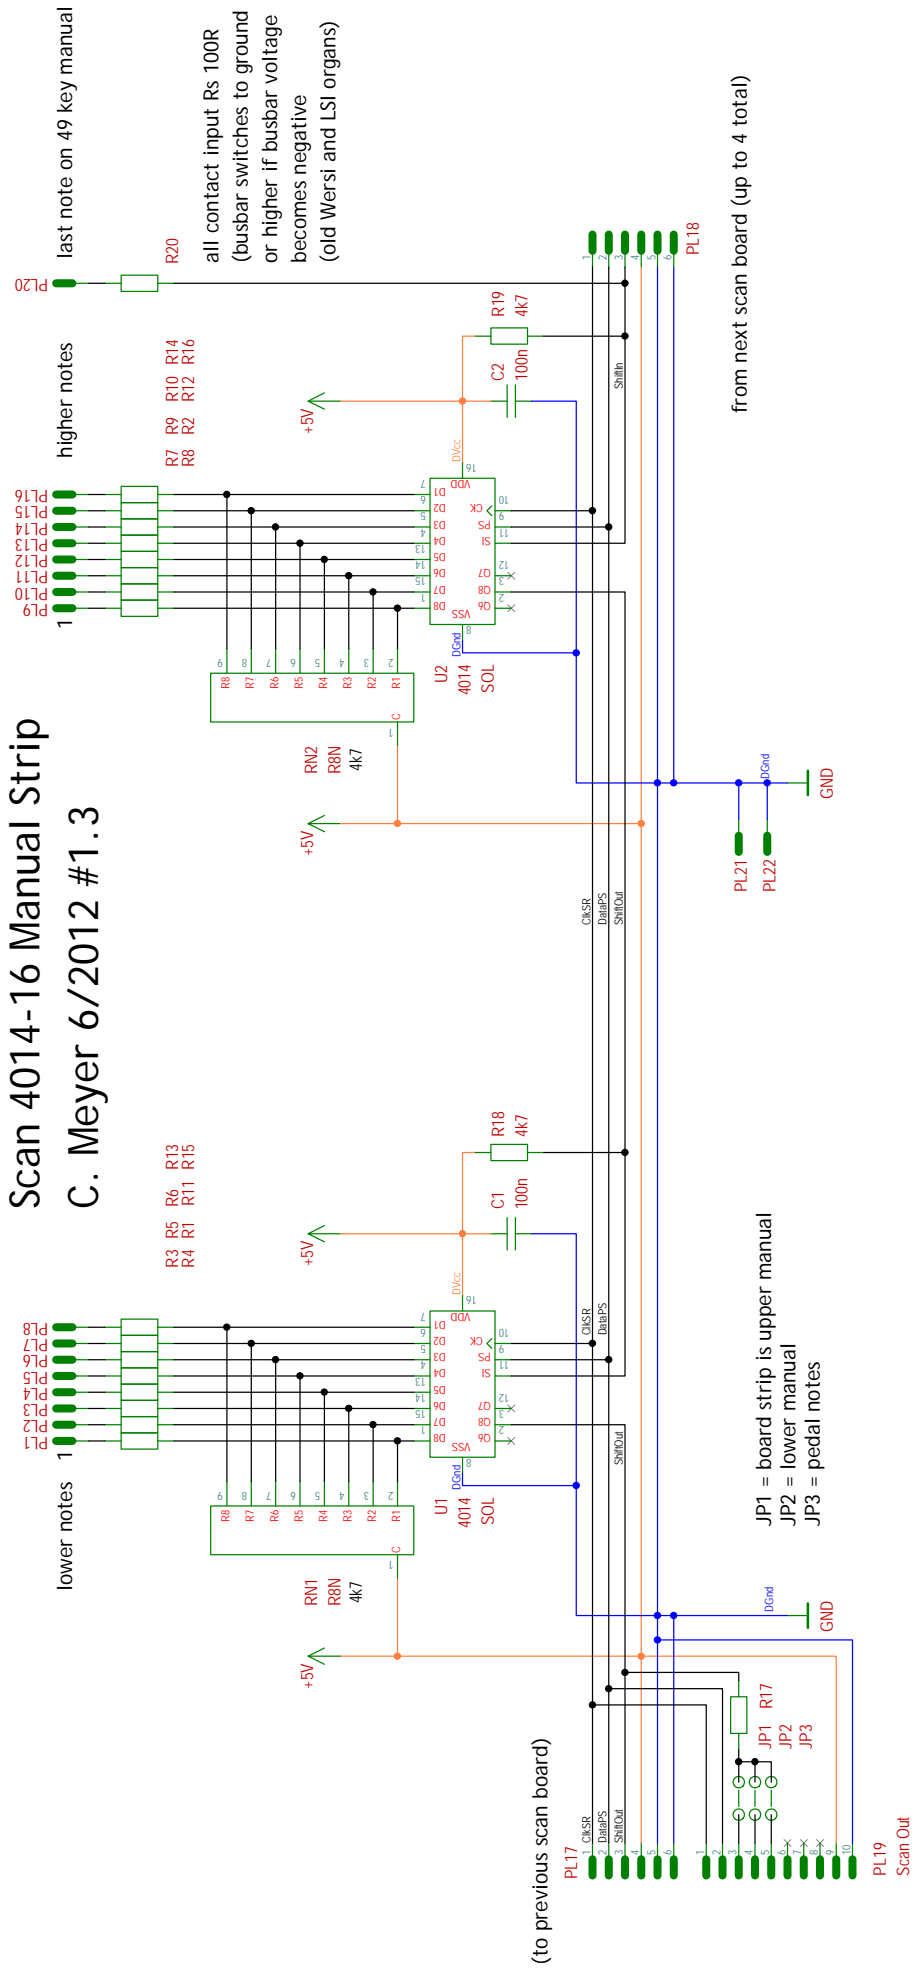
[picture p45: page 1]

last note on 49 key manual

(busbar switches to ground

or higher if busbar voltage

all contact input Rs 100R

(old Wersi and LSI organs)

from next scan board (up to 4 total)

lower notes higher notes

JP1 = board strip is upper manual

(to previous scan board)
