keyboardpartner/HX3/PLATINEN/Scan4014-61_Inline/schem_Scan4014_inline.pdf

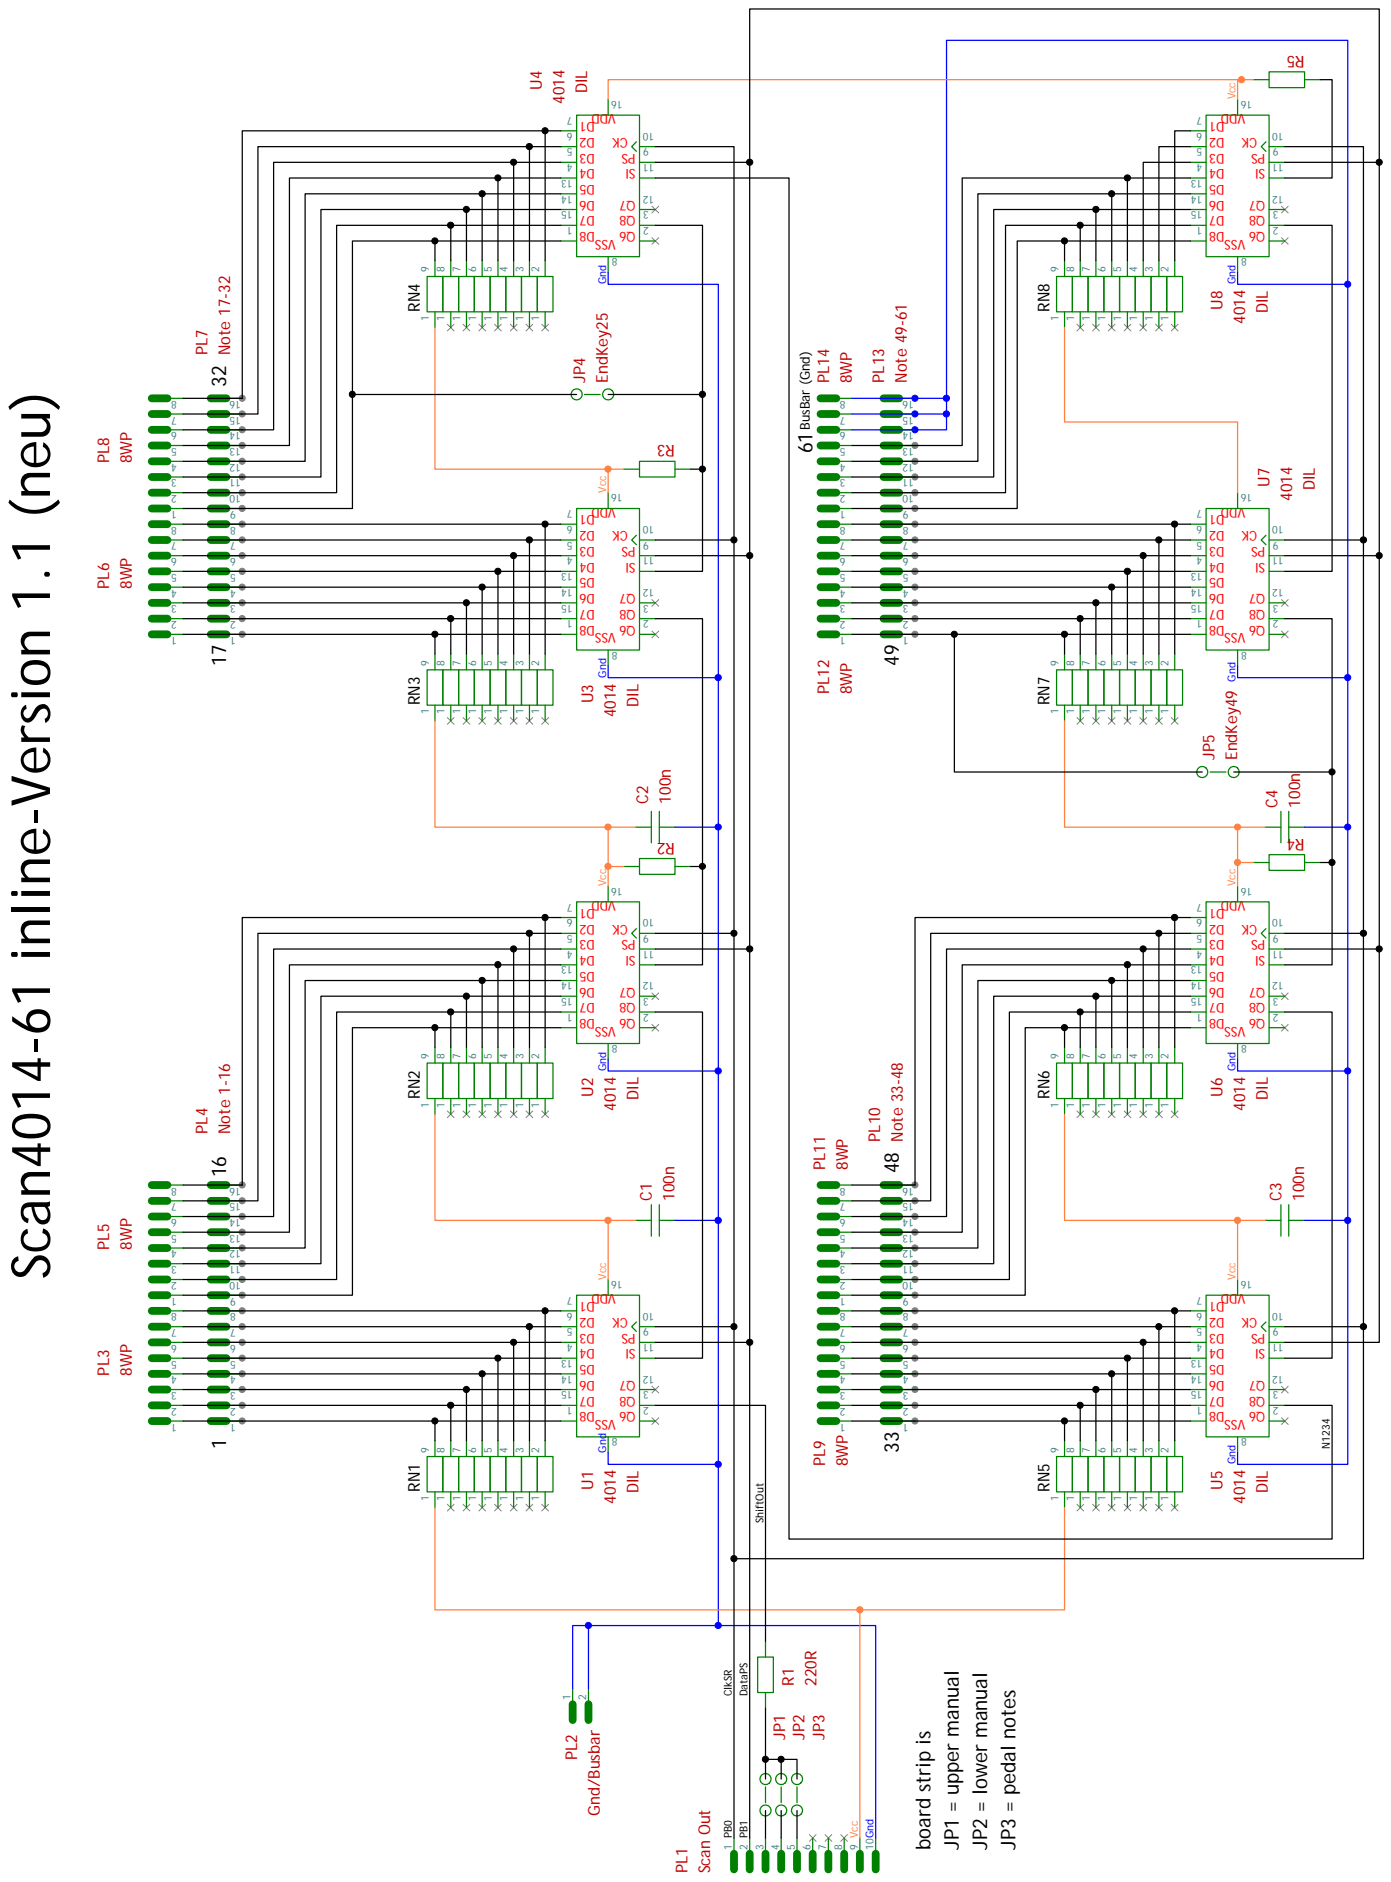
[picture p46: page 1]

Gnd Gnd
