keyboardpartner/HX3/PLATINEN/Drawbars/Drawbars_mk3_simple_schematic.pdf

# EXTERNAL POTS

# HX3 mk3 Drawbars

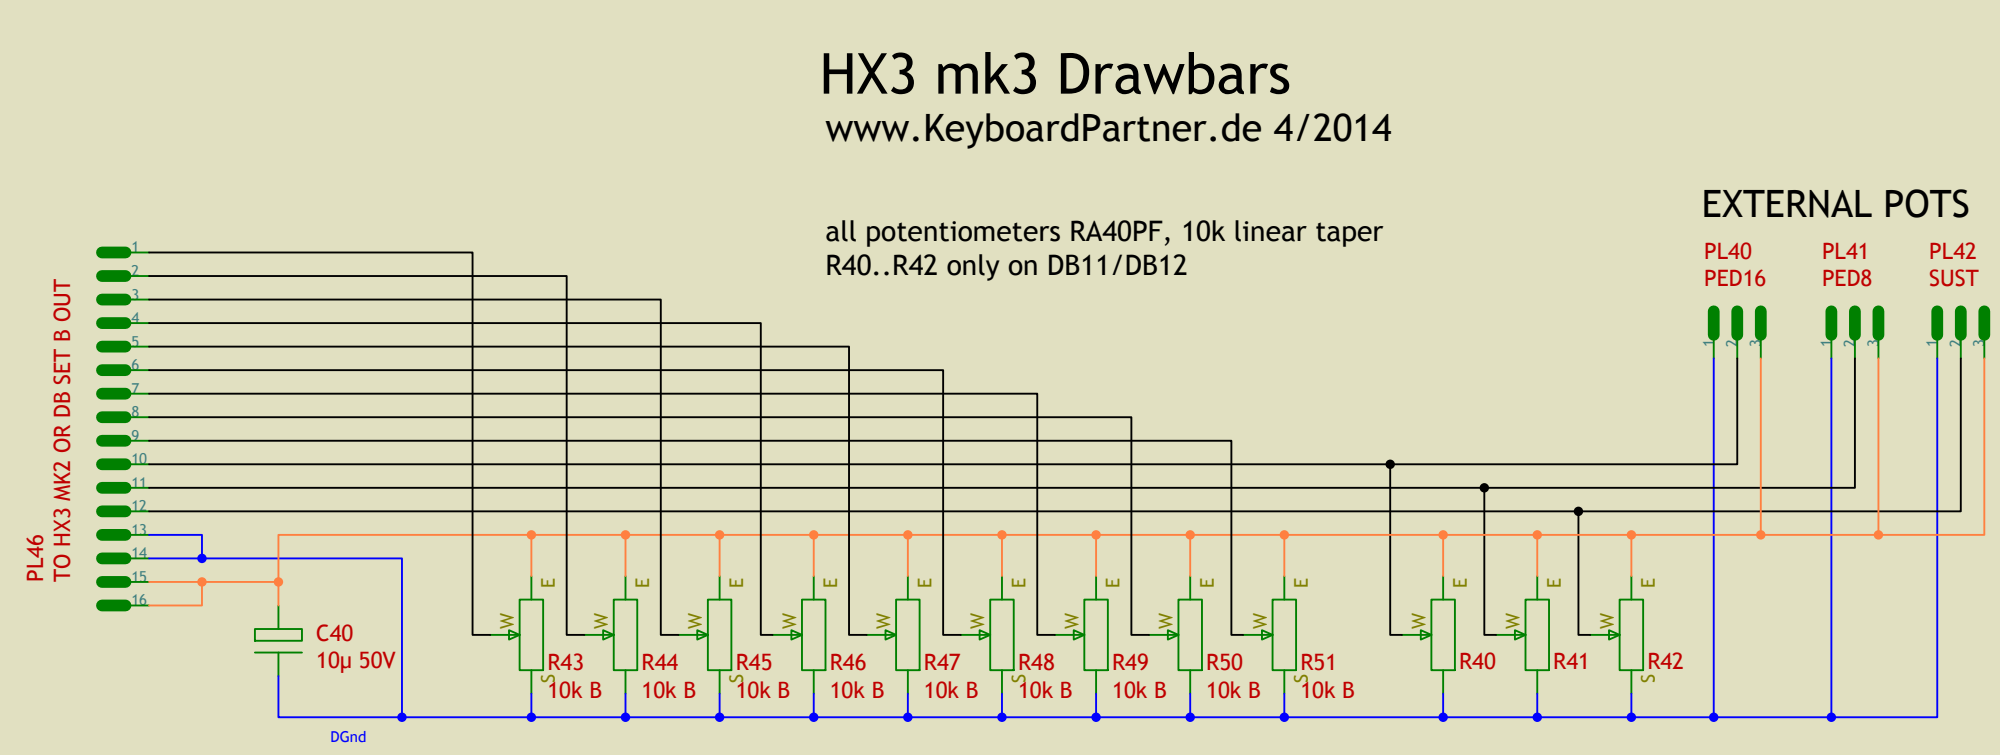
[picture p47: page 1]

all potentiometers RA40PF, 10k linear taper
R40..R42 only on DB11/DB12

TO HX3 MK2 OR DB SET B OUT
