keyboardpartner/HX3/PLATINEN/Drawbars/Drawbars_mk3_mpx_schematic.pdf

PL40

PL41

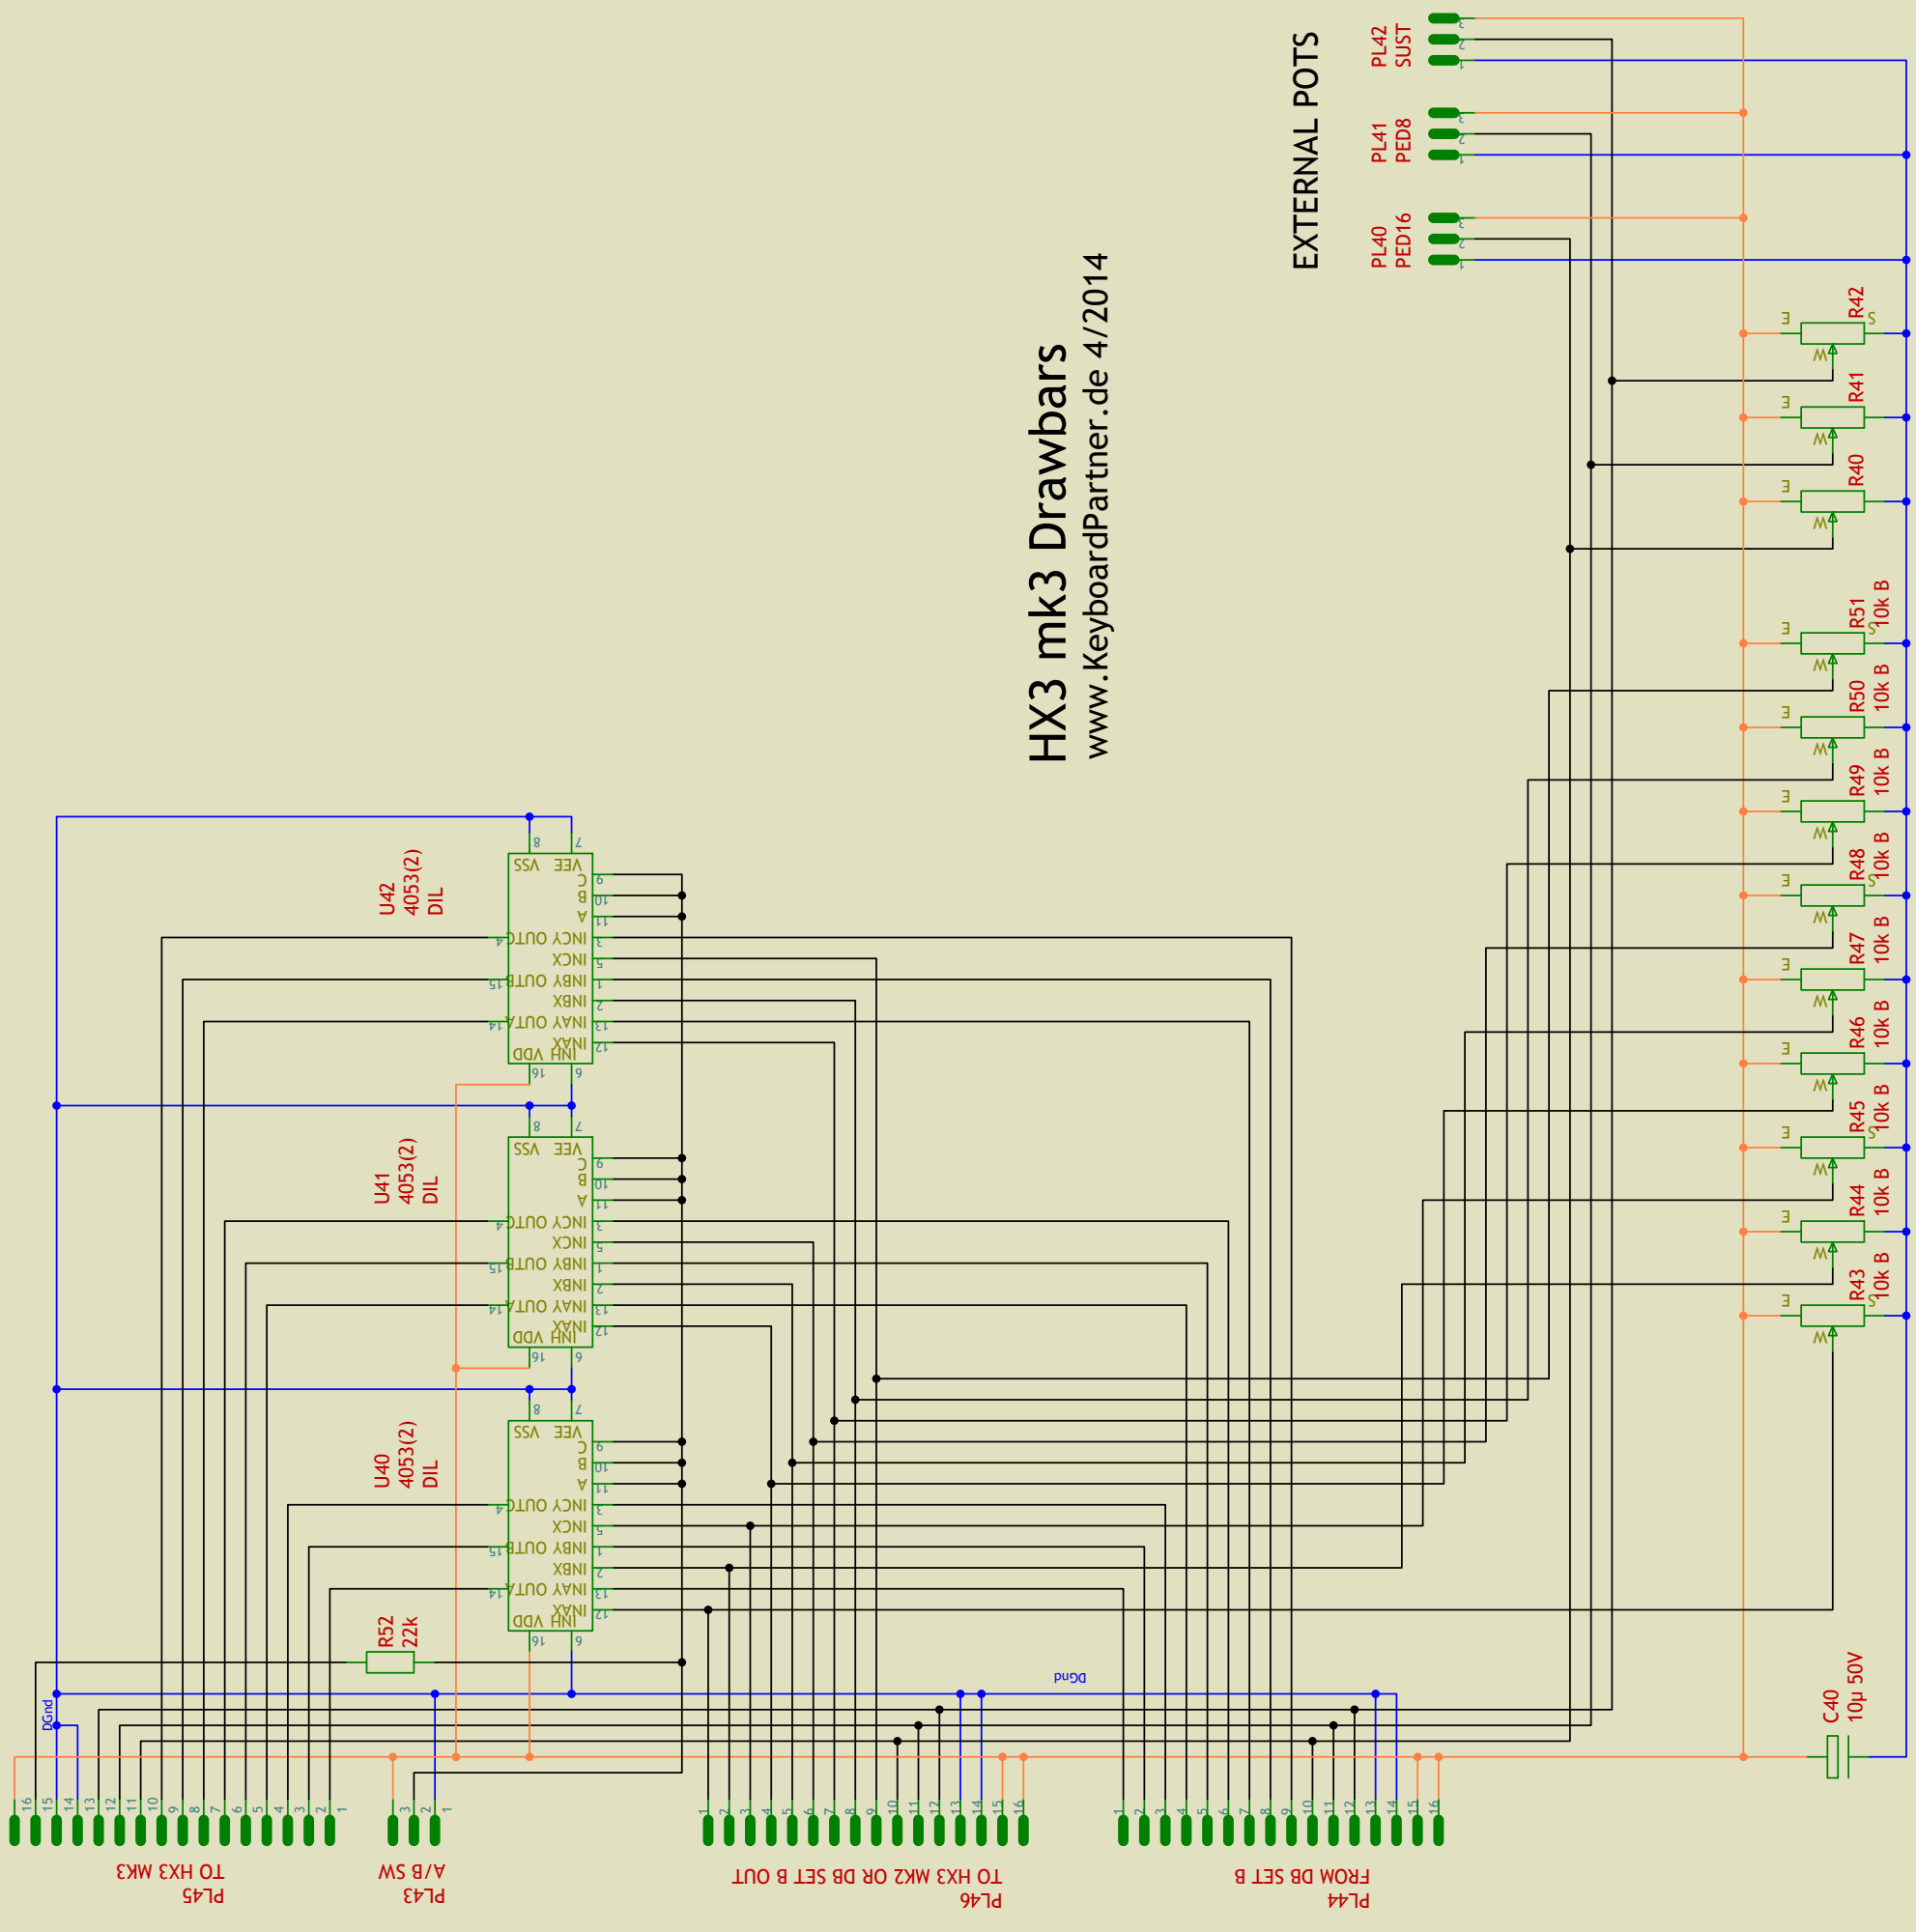
[picture p48: page 1]
