keyboardpartner/HX3/PLATINEN/Drawbars/Drawbars_schematic.pdf

## EXTERNAL POTS TO HX3 UPPER/LOWER

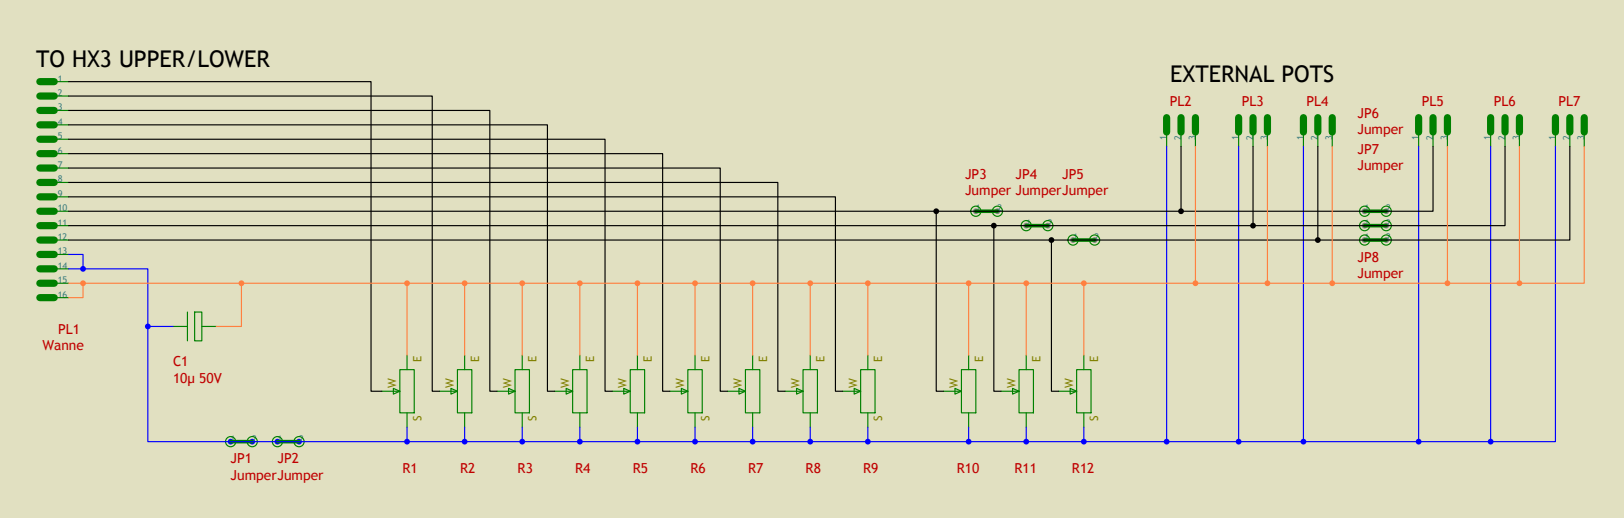
[picture p54: page 1]
