keyboardpartner/HX3/FOR_OEM/hx3_hammond_logos.pdf

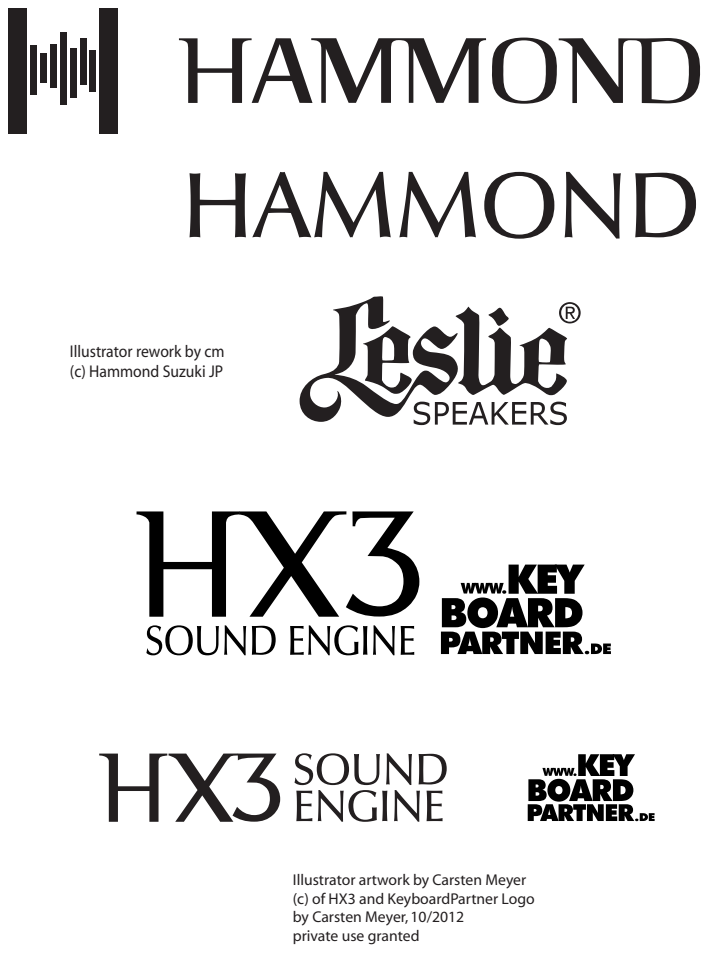
[picture p55: page 1]

Illustrator rework by cm
(c) Hammond Suzuki JP

Illustrator artwork by Carsten Meyer
(c) of HX3 and KeyboardPartner Logo
by Carsten Meyer, 10/2012
private use granted
