keyboardpartner/HX3/PLATINEN/Bass25/silk_MIDIbass25.pdf

C5

C7

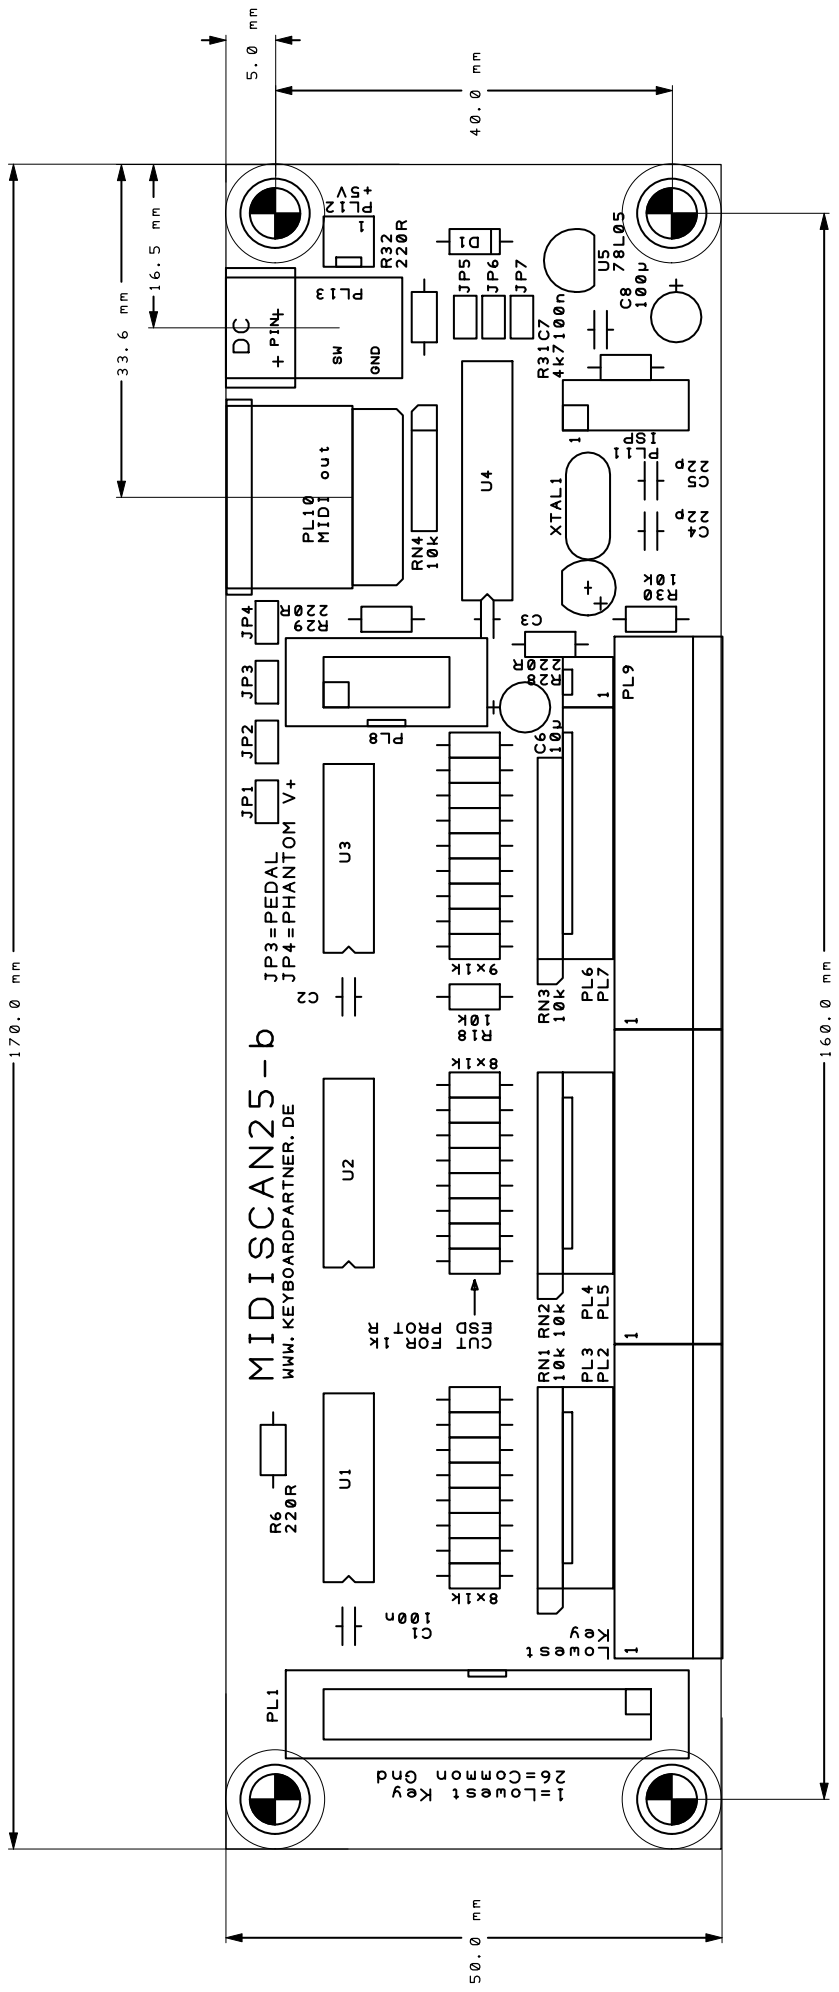
[picture p57: page 1]
