keyboardpartner/HX3/PLATINEN/Preset12/board_Preset12_2_new.pdf

C2

Mt1

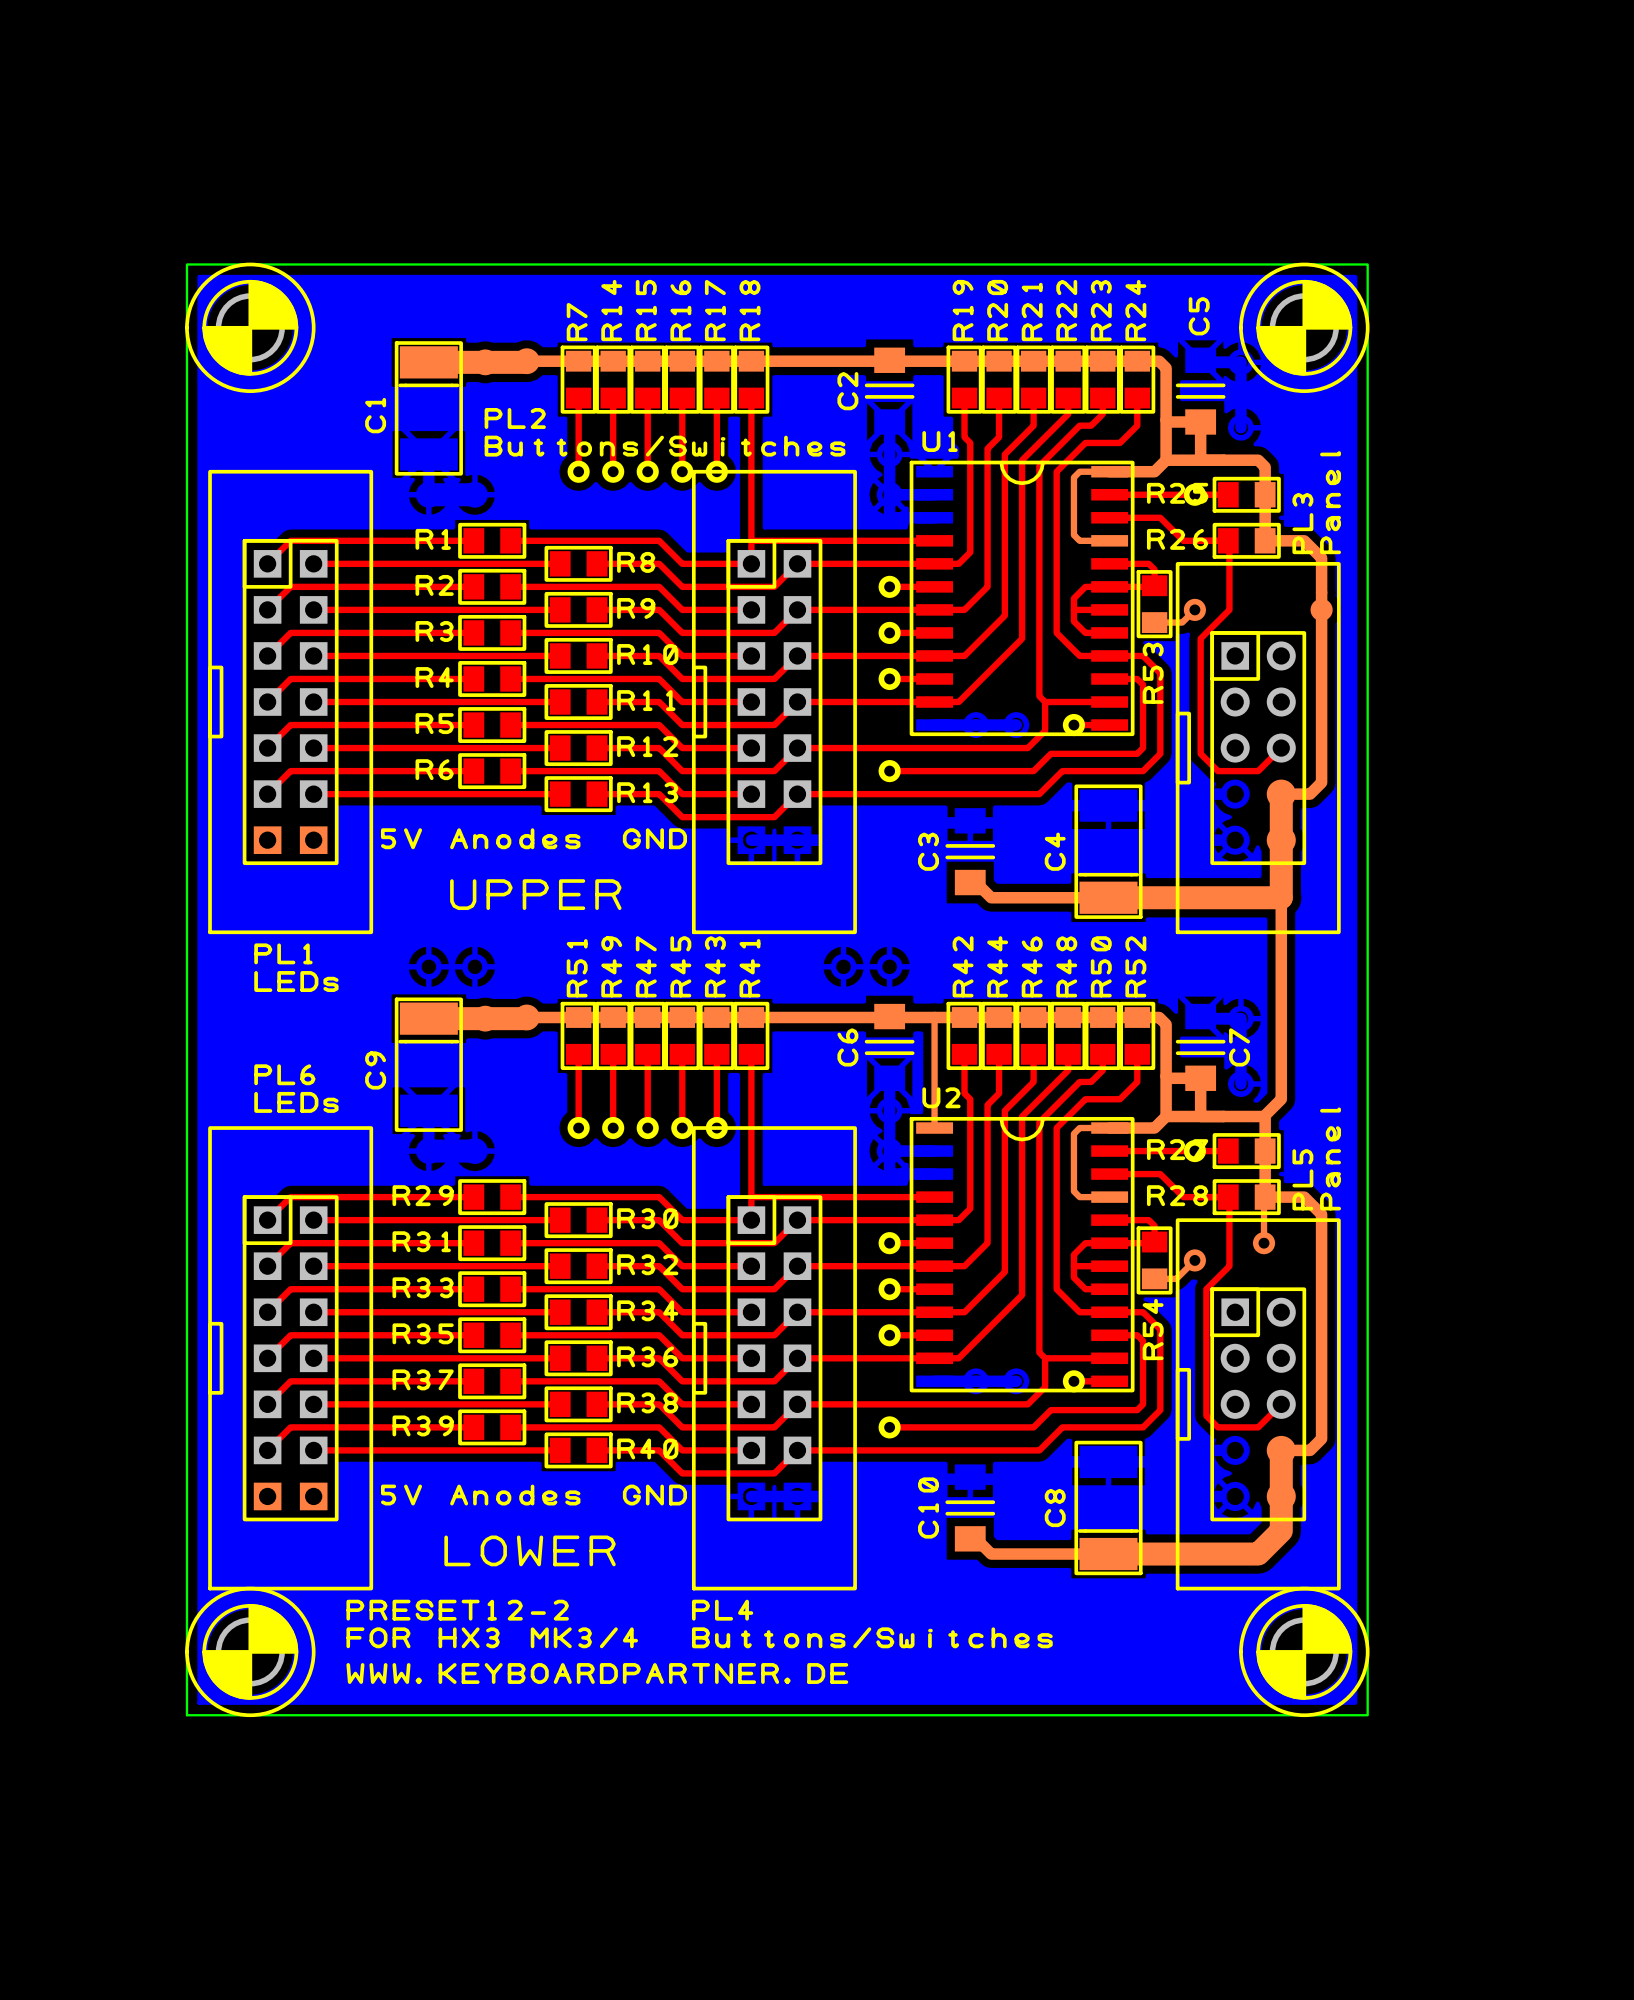
[picture p58: page 1]
