keyboardpartner/HX3/PLATINEN/Preset12/schem_Preset12_2_new.pdf

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

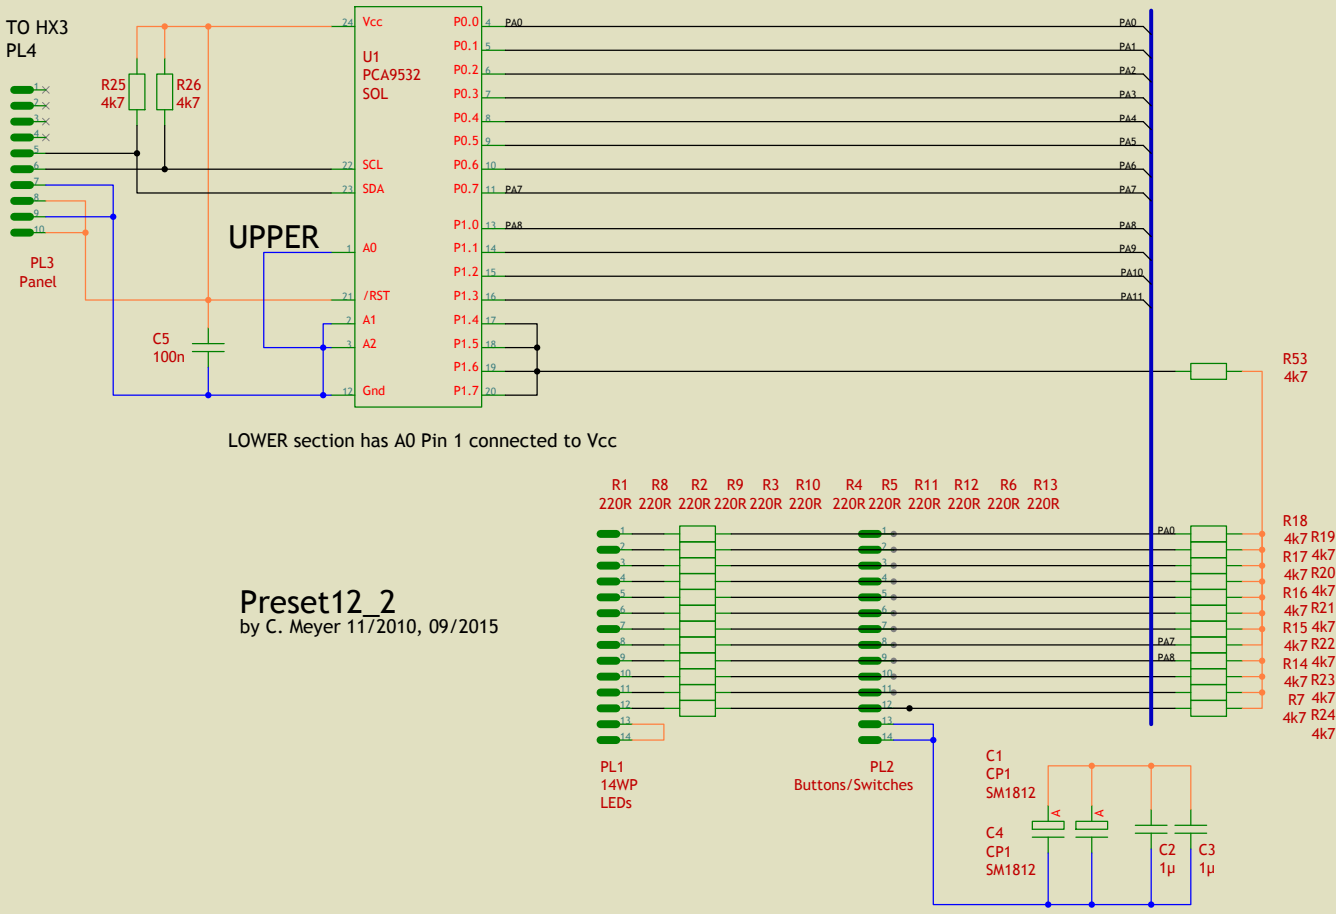
[picture p59: page 1]
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
