keyboardpartner/HX3/PLATINEN/Preset12/silk_Preset12_2_new.pdf

C5

Mt4

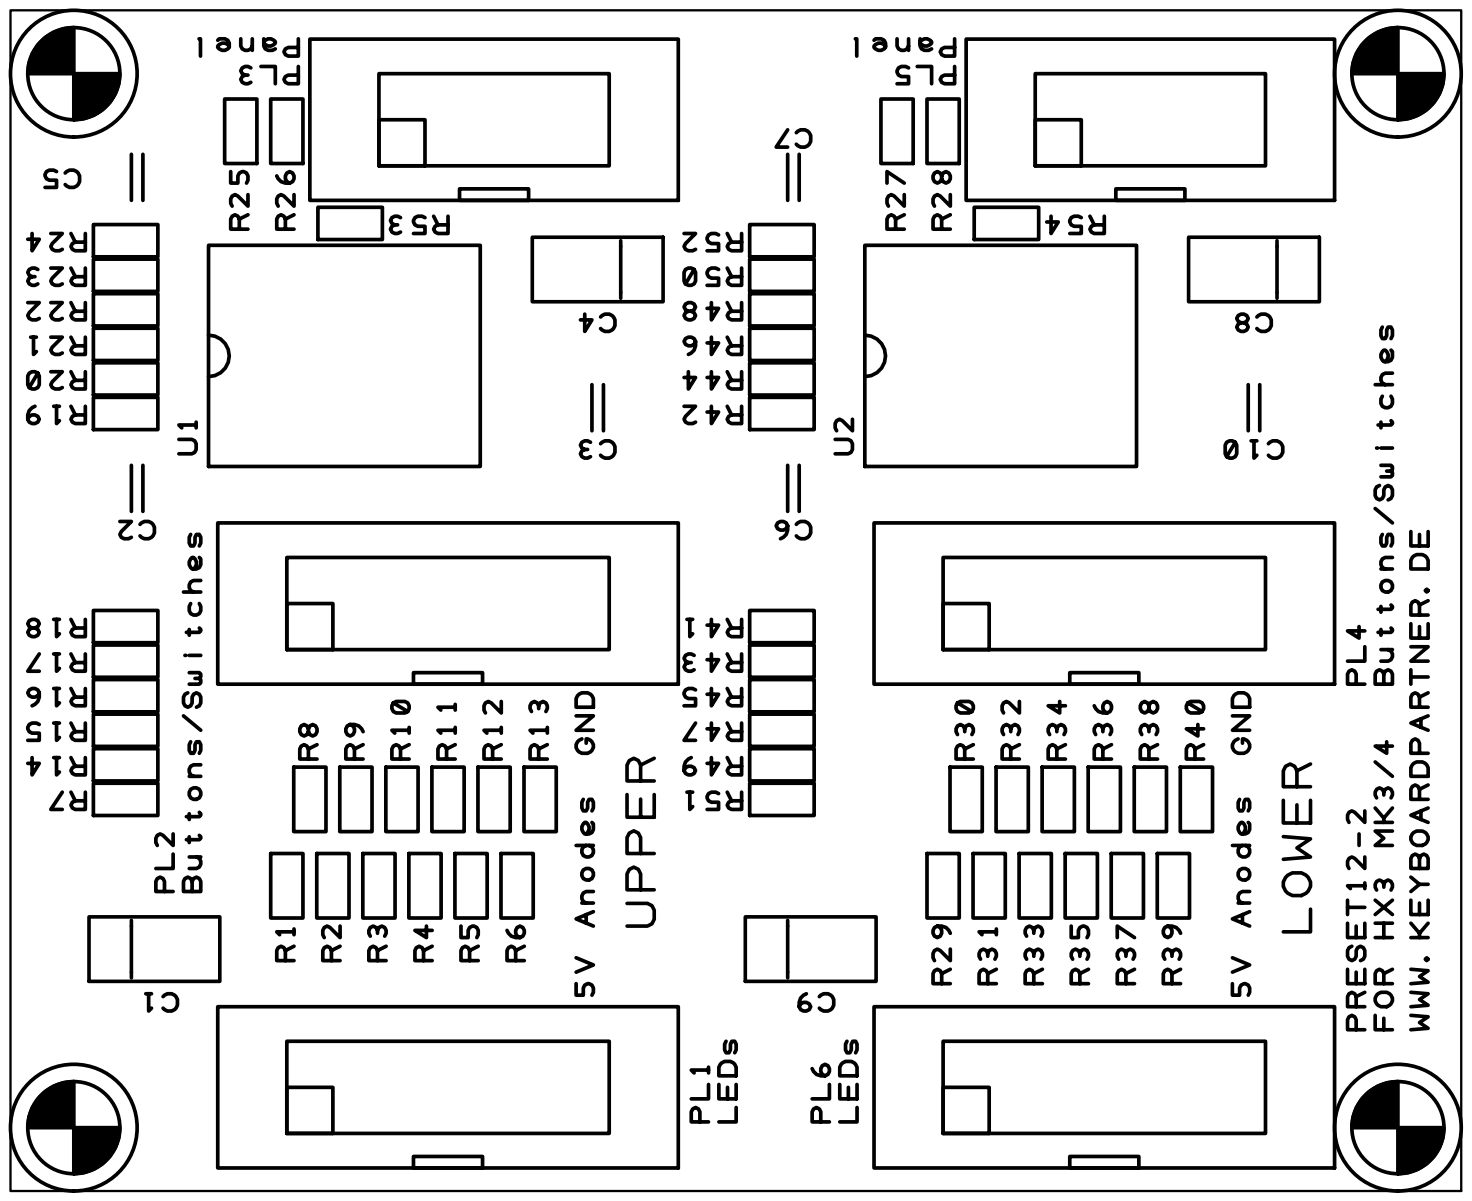
[picture p60: page 1]
