keyboardpartner/HX3/PLATINEN/Drawbars/Drawbars_mk3_mpx_dimensions.pdf

PL45
PL46

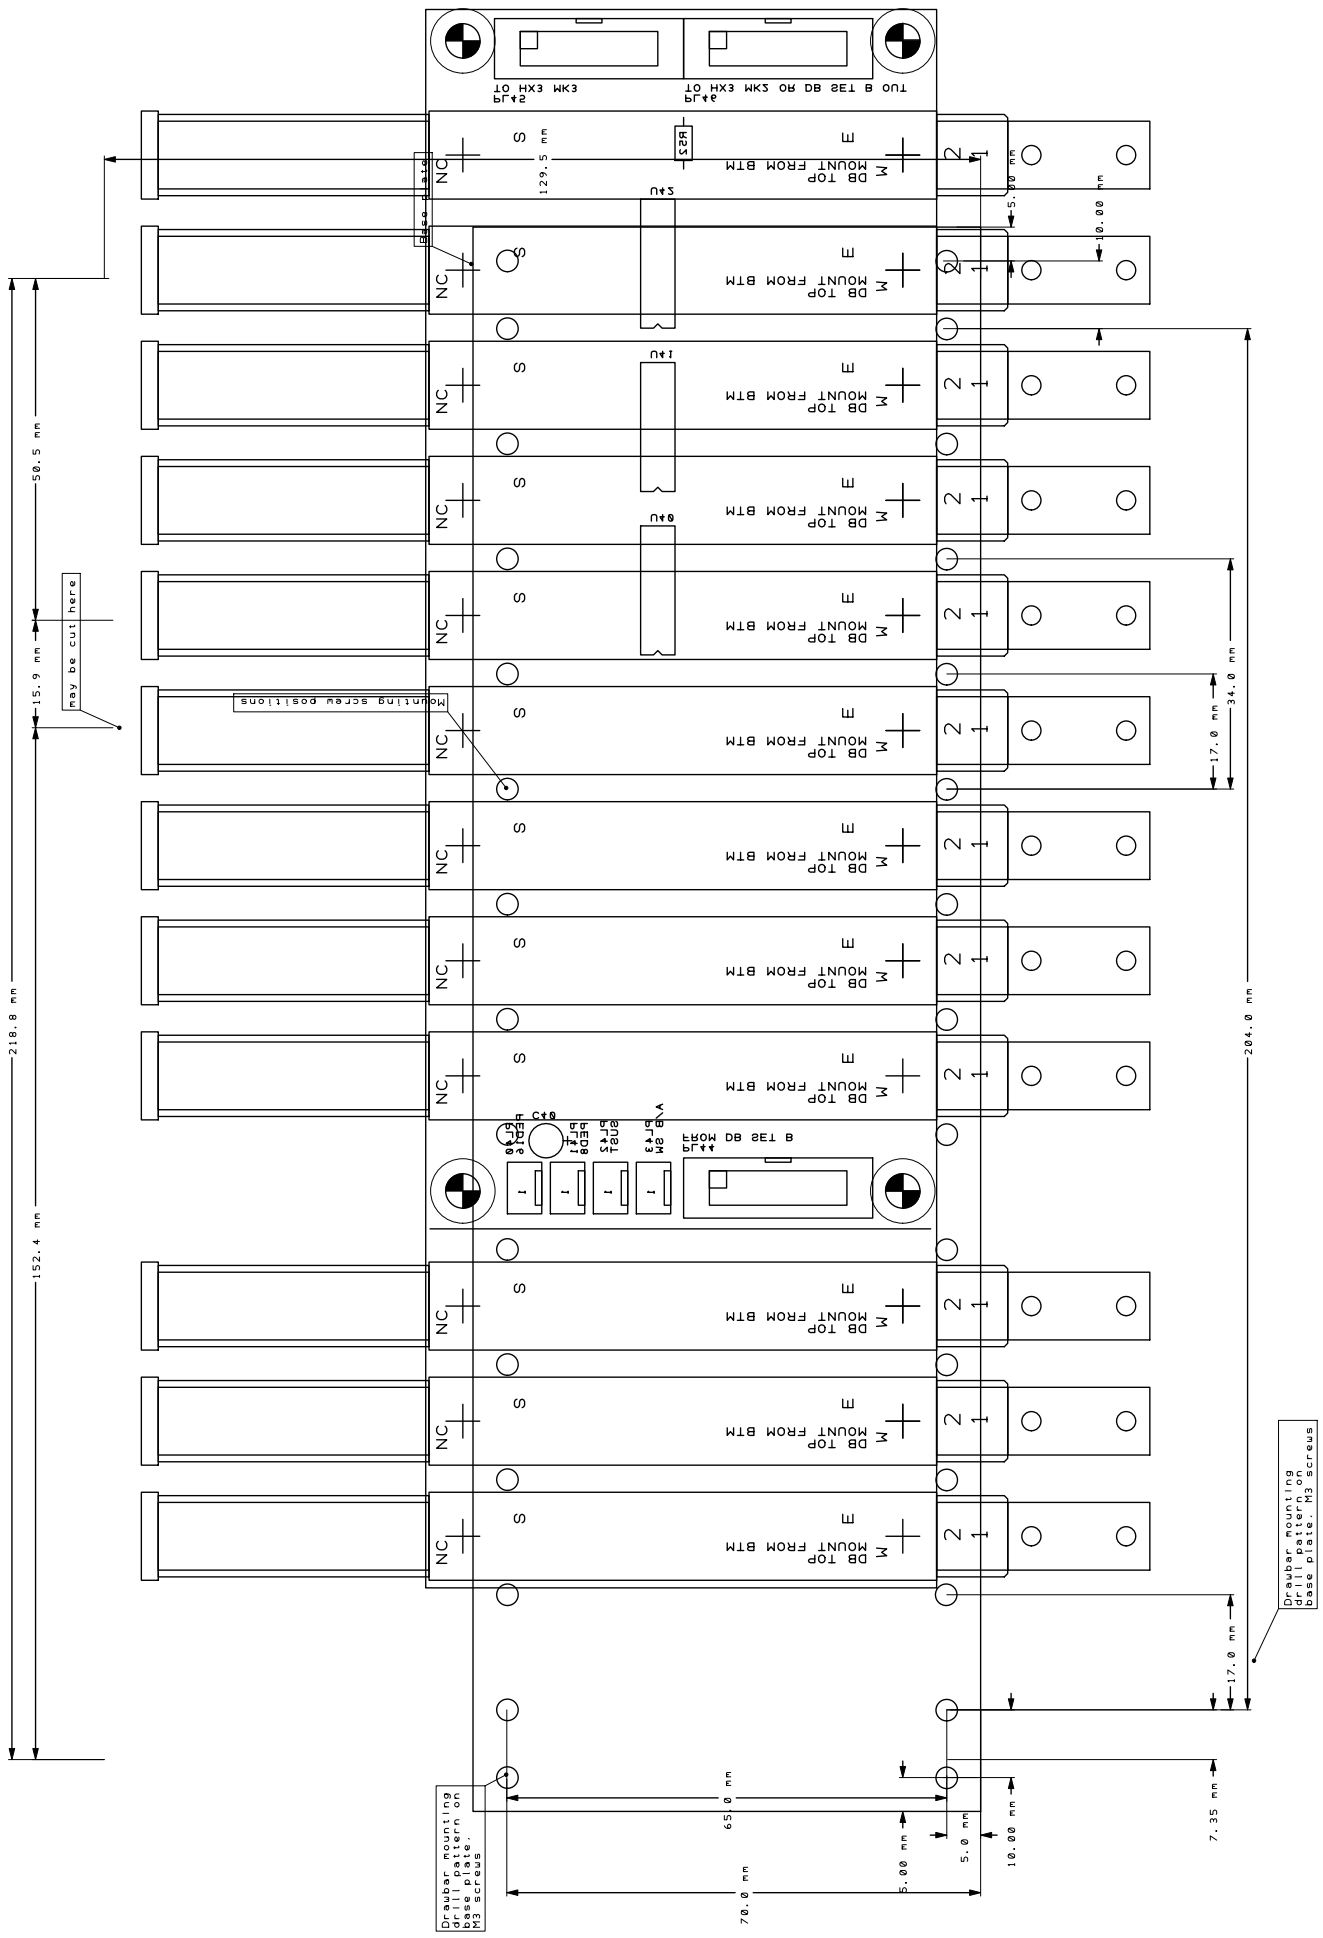
[picture p61: page 1]
