keyboardpartner/HX3/PLATINEN/HX3_mk4/HX3_4 _silk_dimensions.pdf

C5

C15

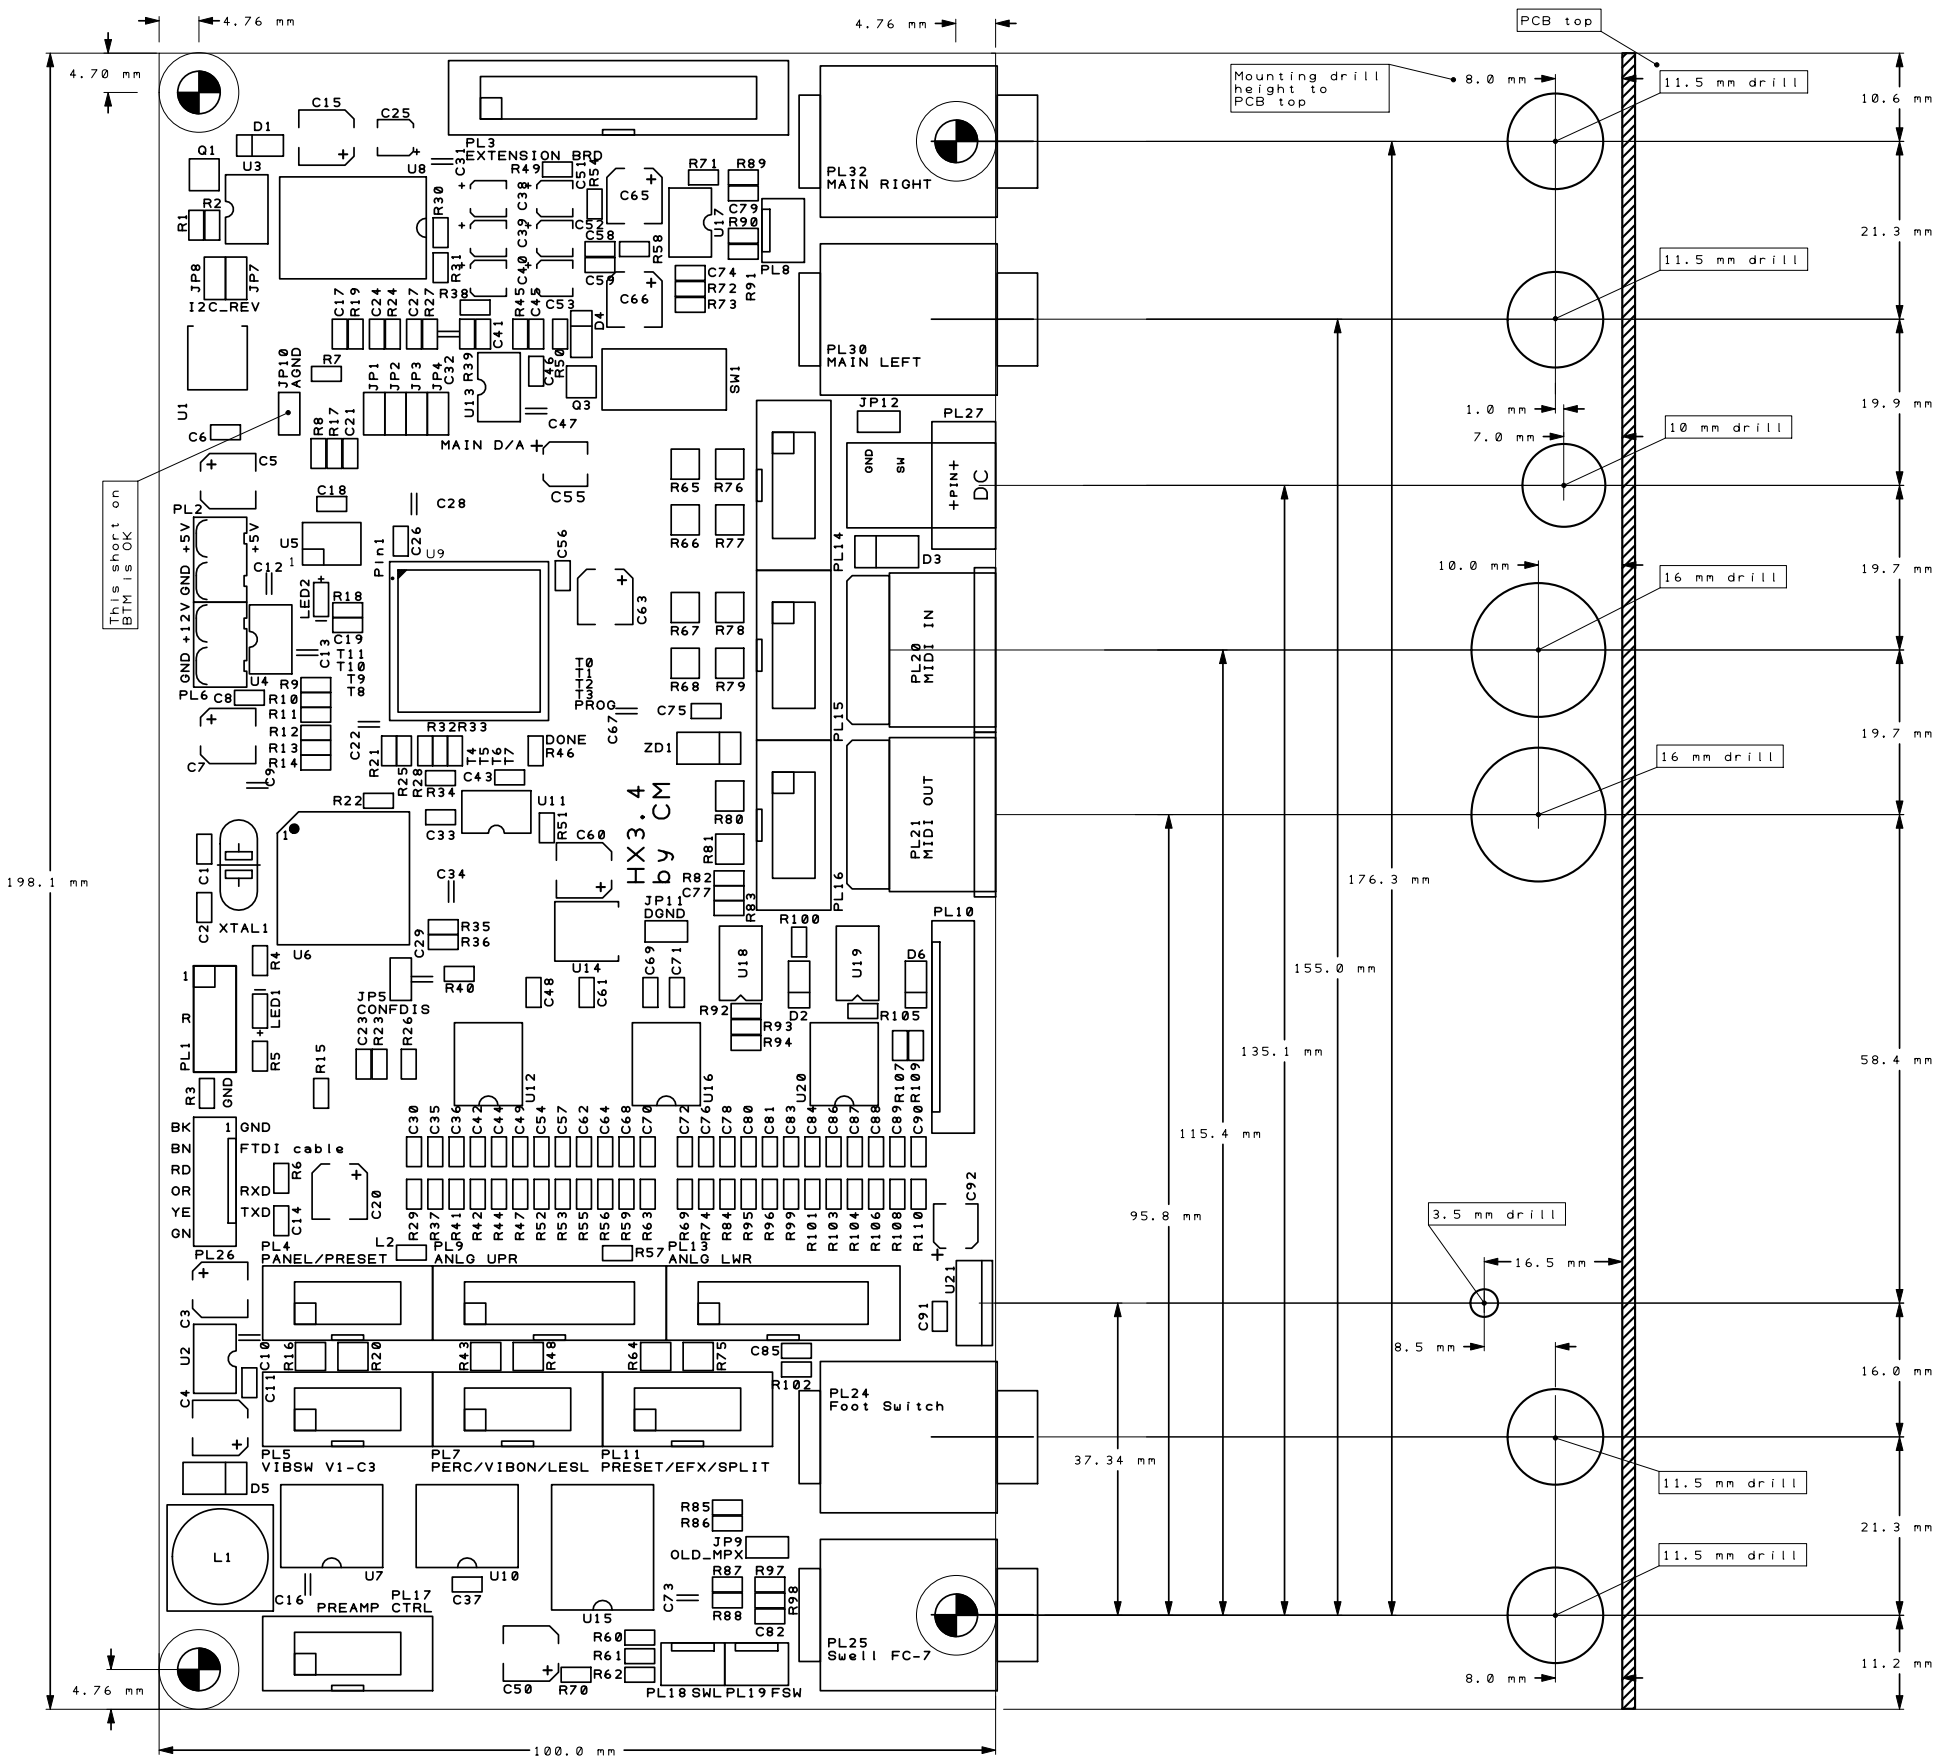
[picture p62: page 1]
