keyboardpartner/HX3/PLATINEN/XB2_mk3/best_XB2_LCD_30.pdf

X

X X

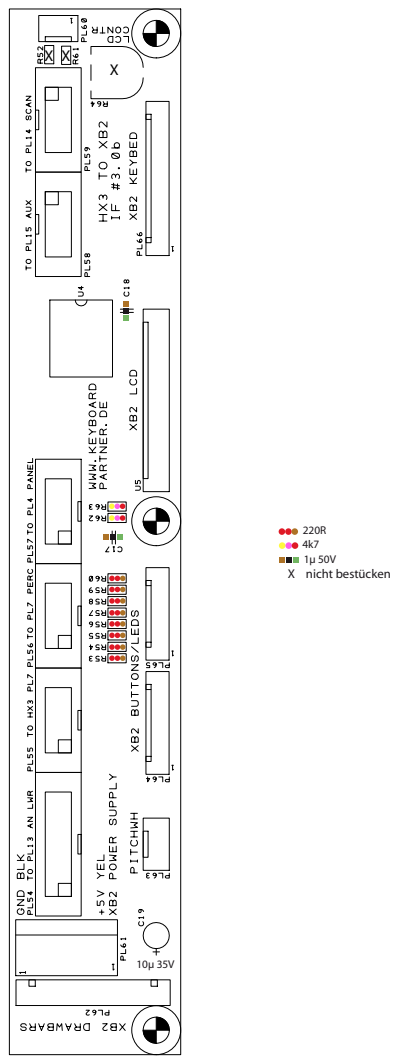
[picture p63: page 1]
X nicht bestücken
