keyboardpartner/HX3/PLATINEN/Extension_mk3/HX3_Extension_schem.pdf

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

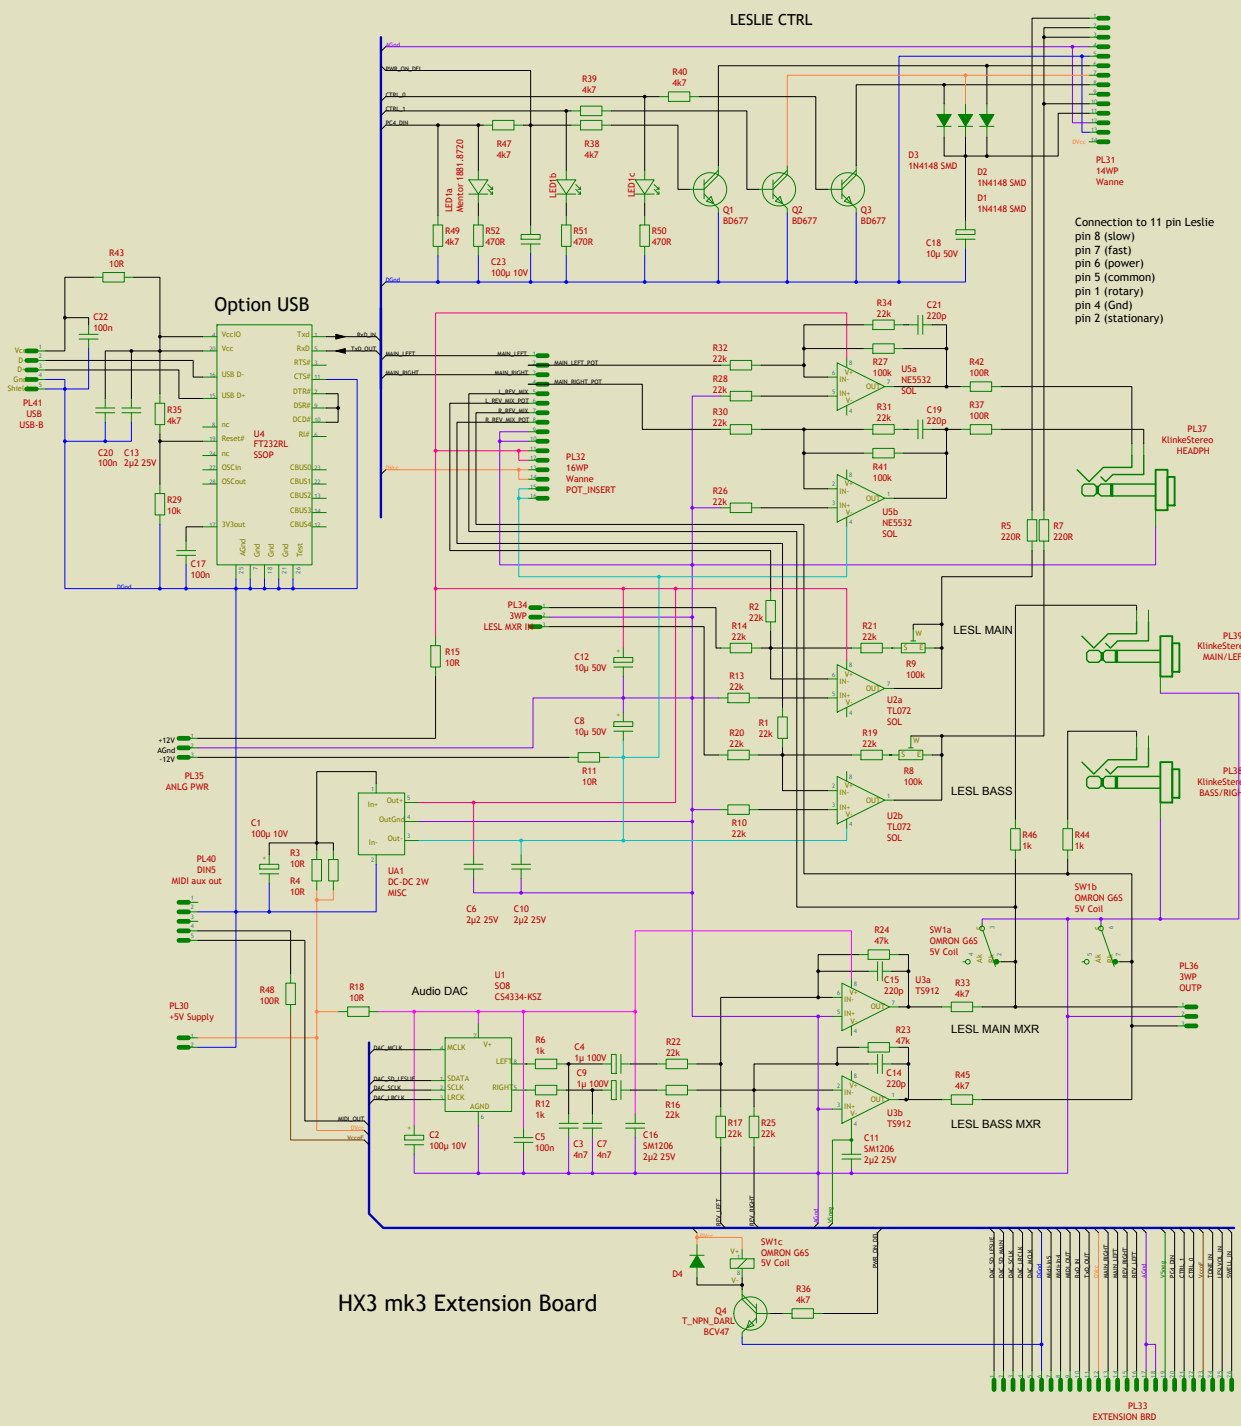
[picture p64: page 1]
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
