keyboardpartner/HX3/PLATINEN/Adapter/bottom_HOAX_adapter.pdf

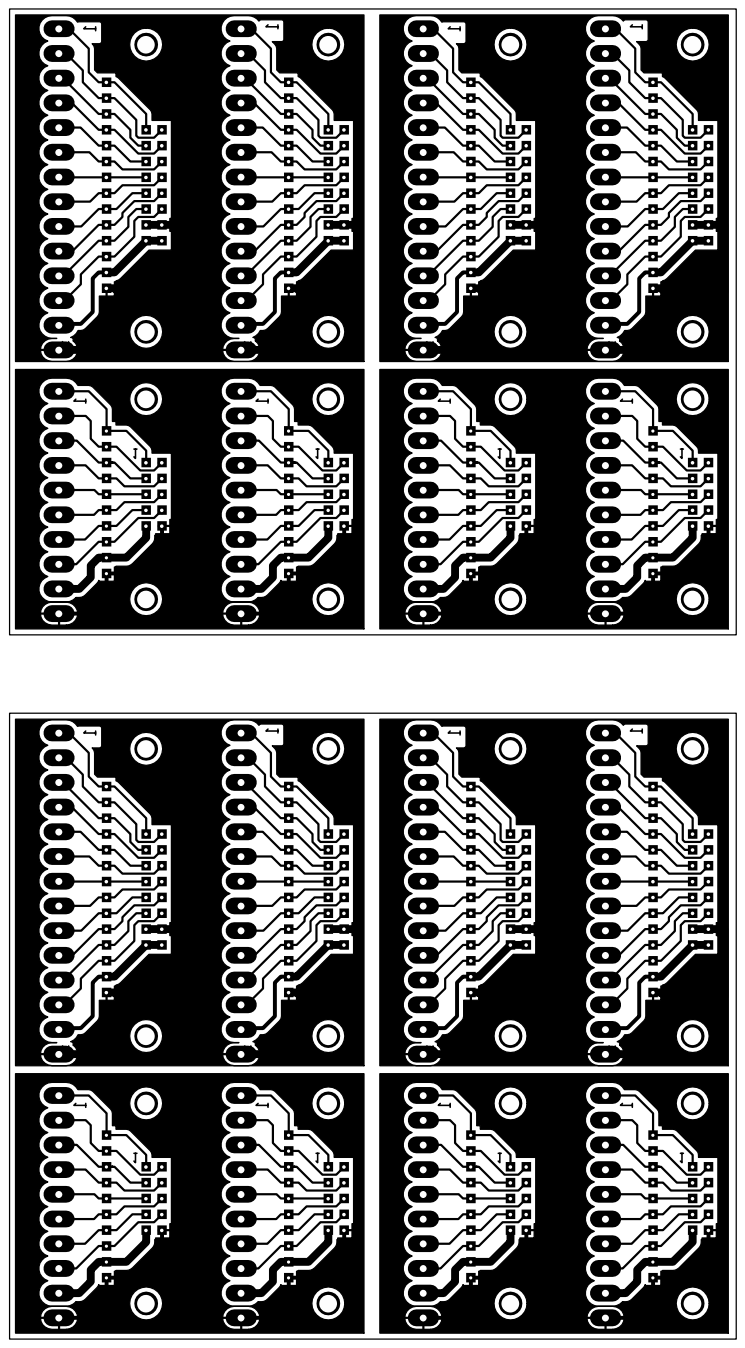
[picture p65: page 1]
