keyboardpartner/HX3/PLATINEN/Adapter/schem_XB2_IF_DIG.pdf

# LCD IF 2X16

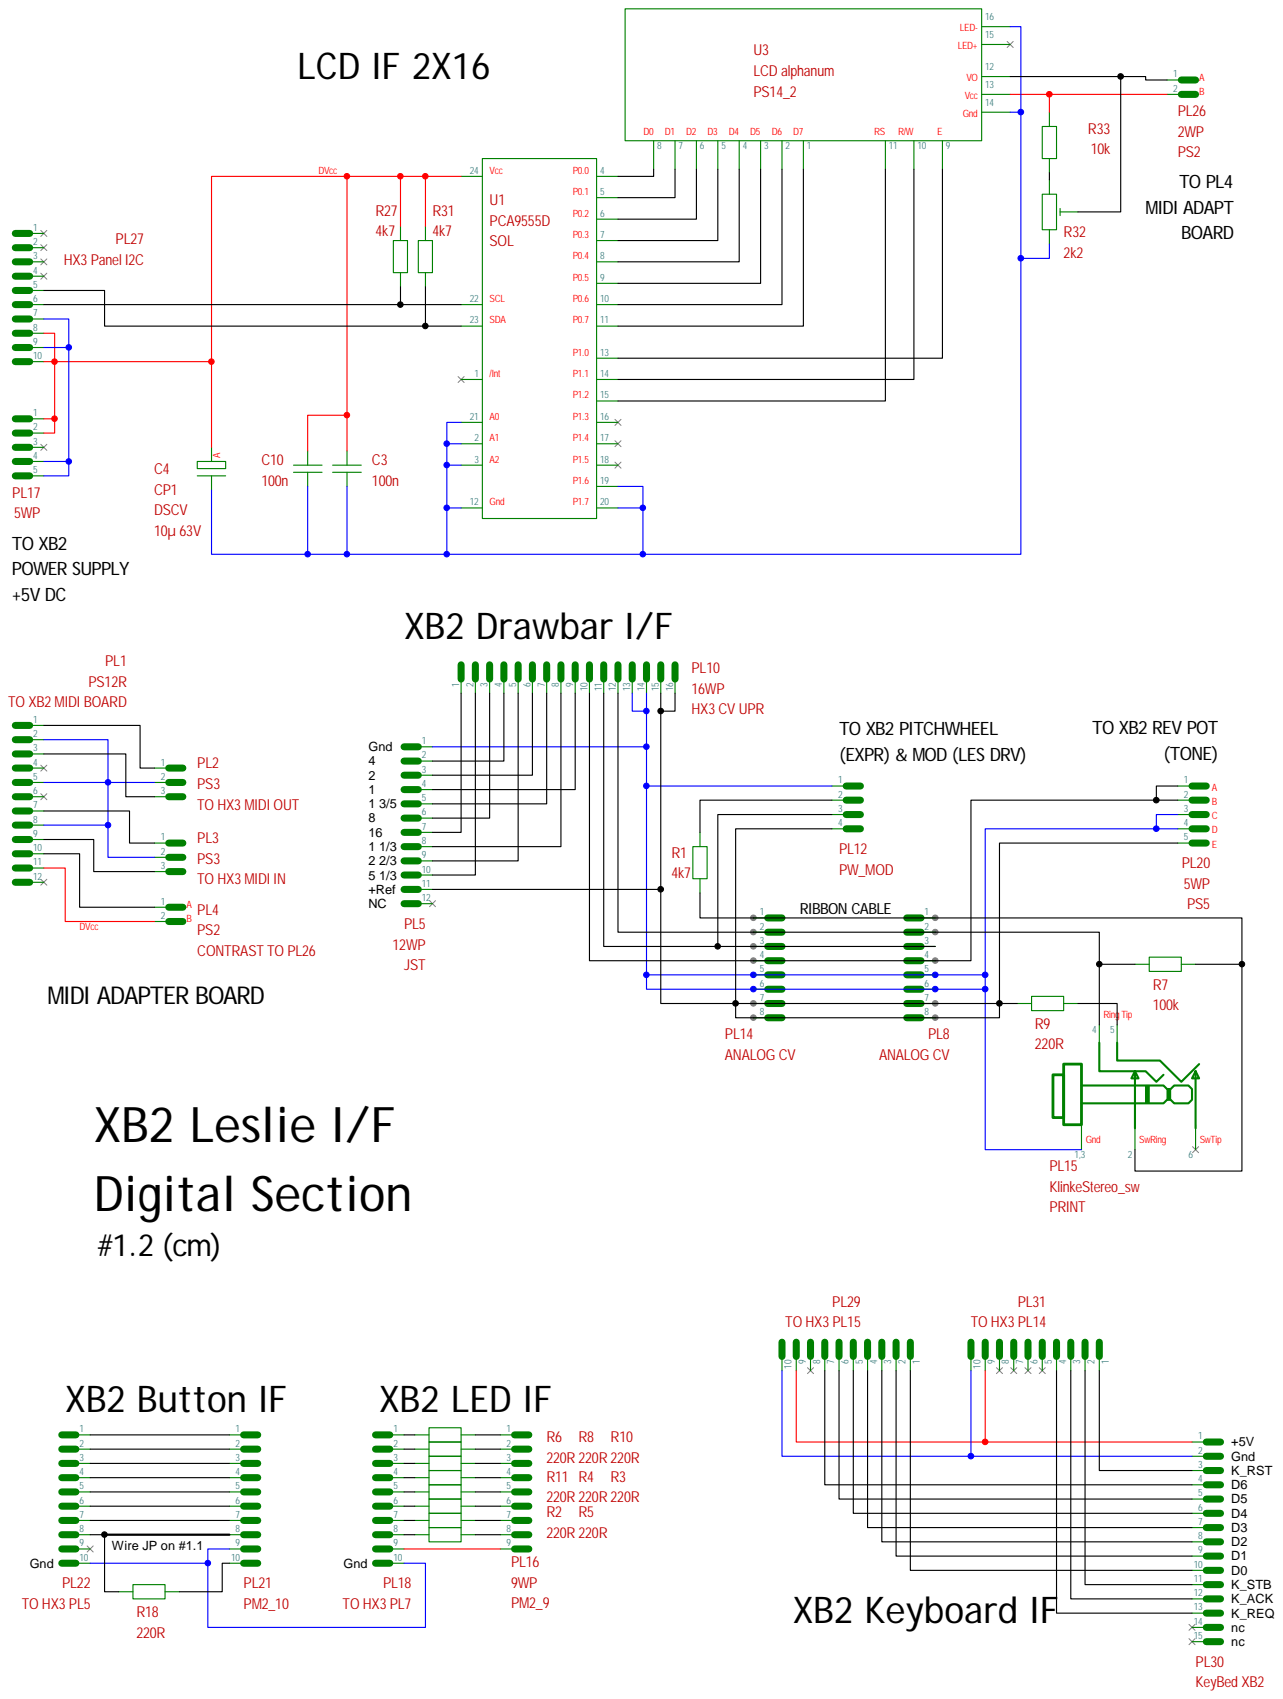
[picture p66: page 1]

TO XB2 PITCHWHEEL
(EXPR) & MOD (LES DRV)
