keyboardpartner/HX3/PLATINEN/Adapter/silk_XB2_IF.pdf

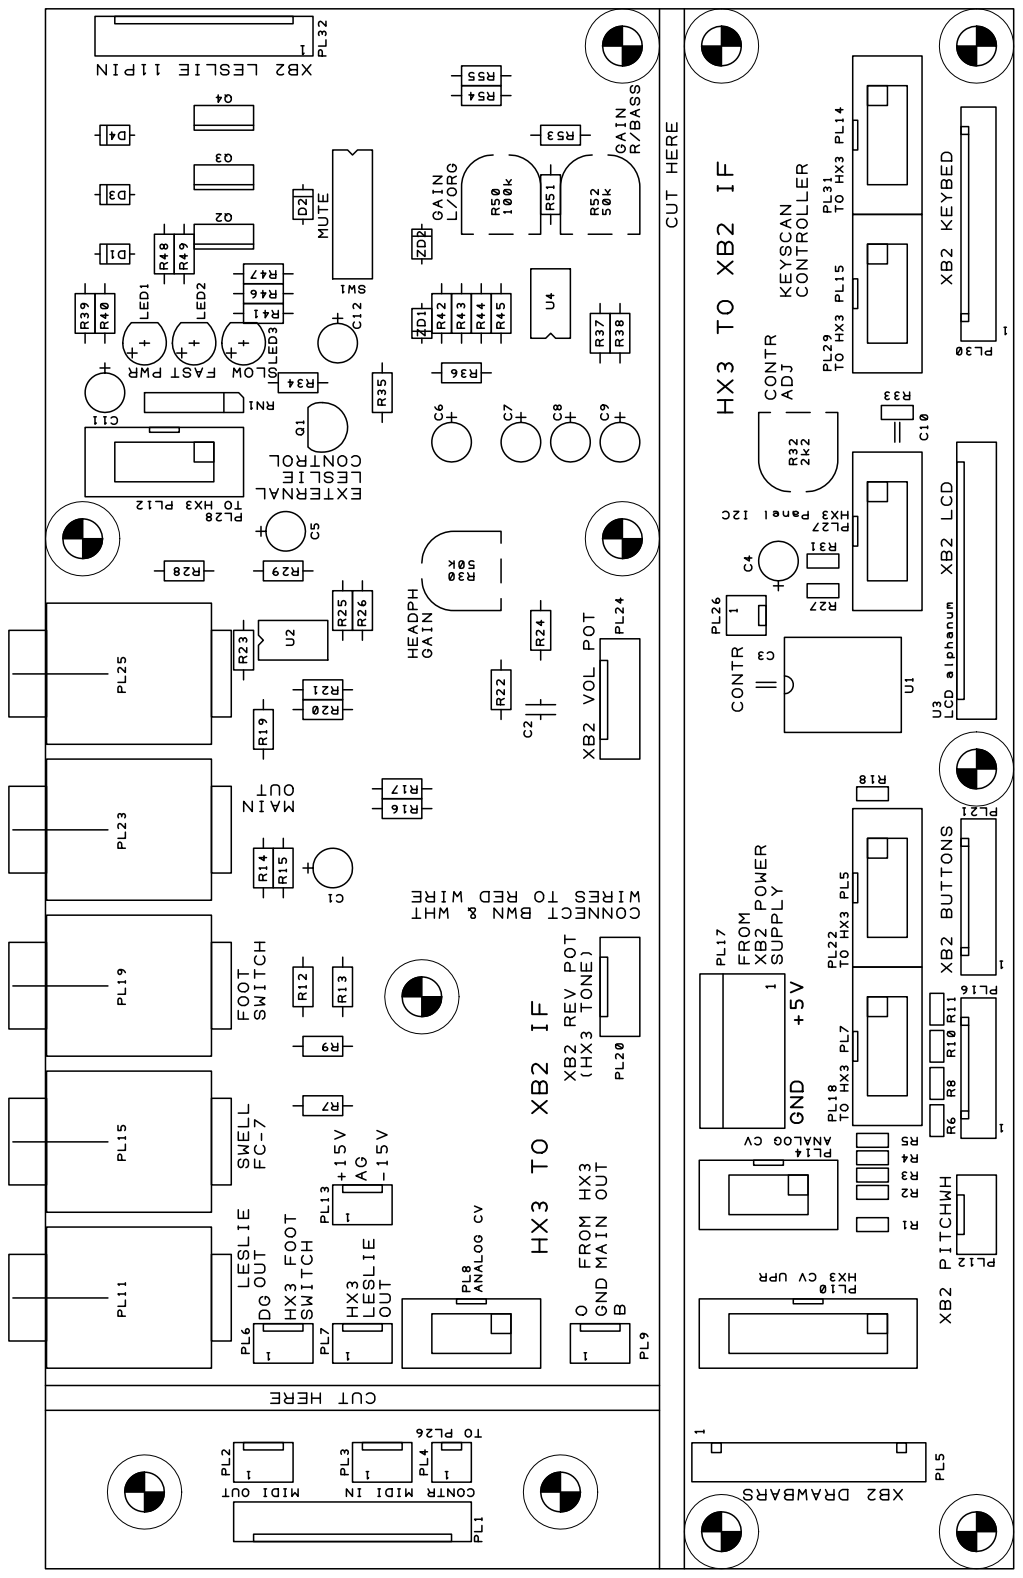
[picture p67: page 1]
