keyboardpartner/HX3/PLATINEN/Drawbars/Drawbars_dimensions.pdf

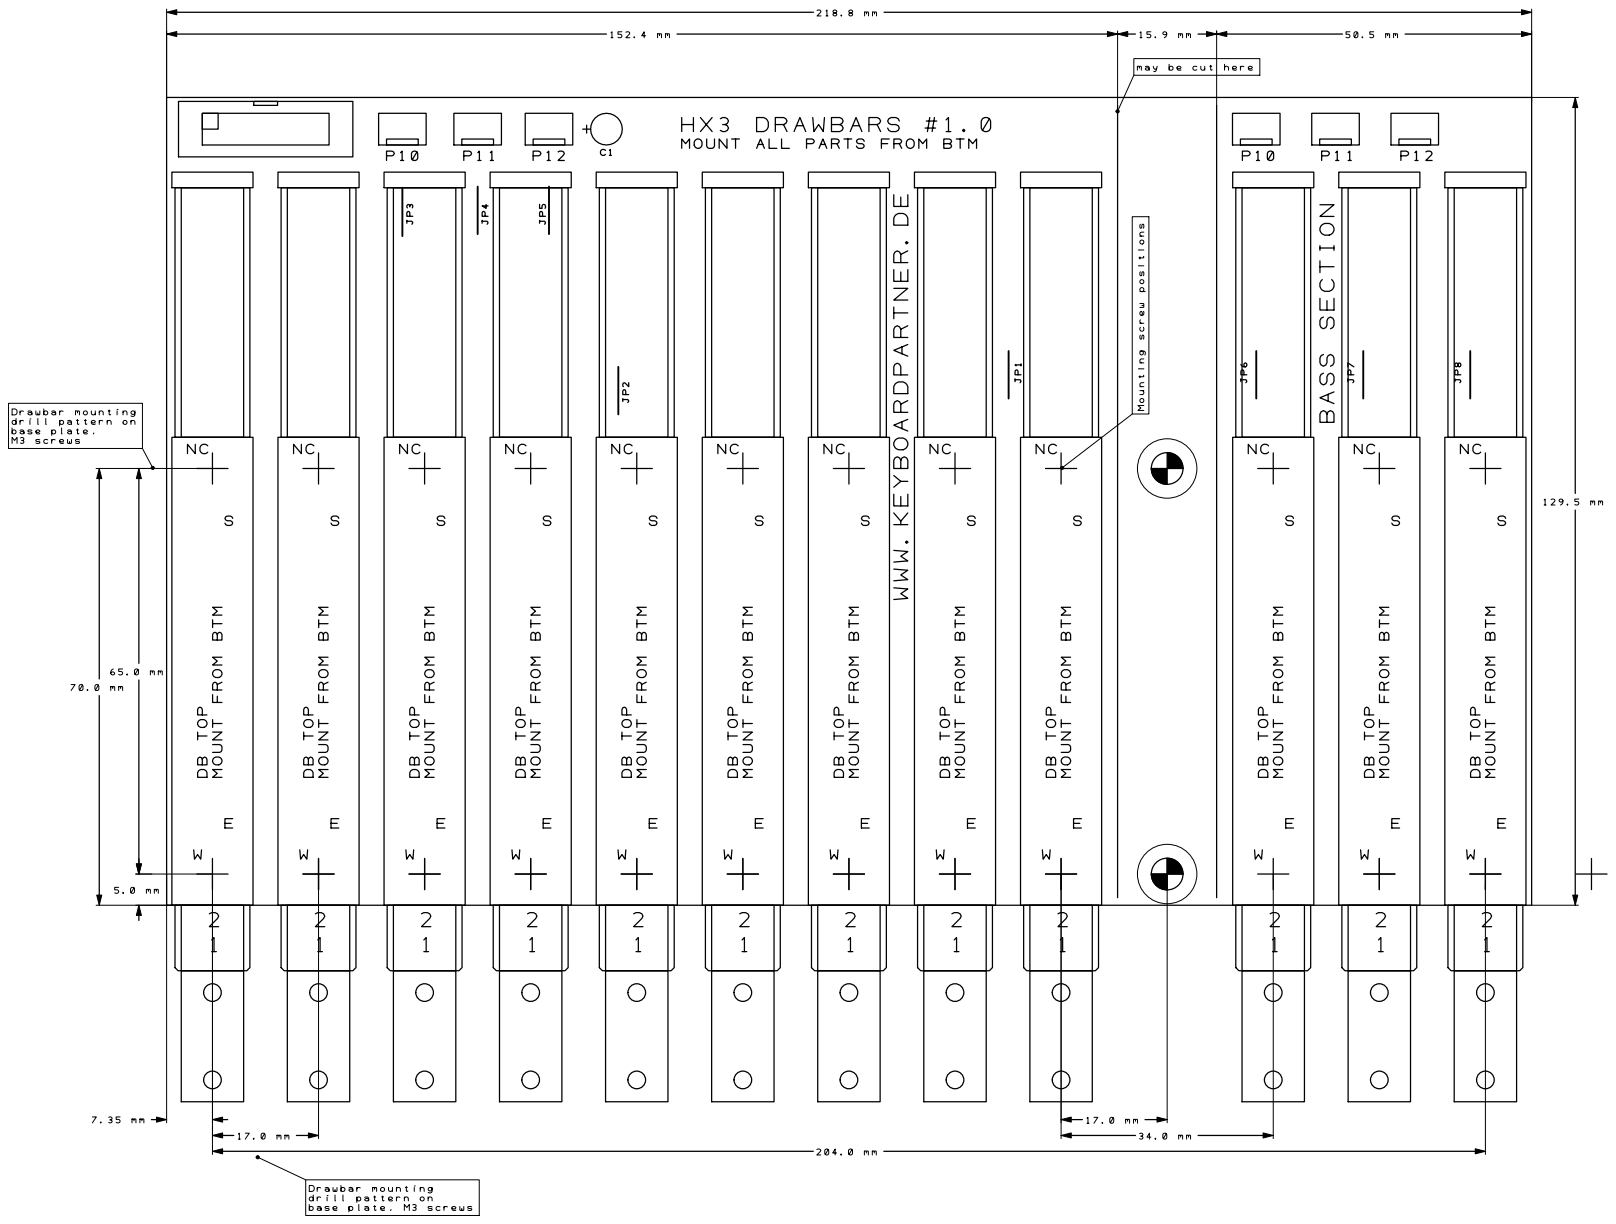
[picture p68: page 1]
