keyboardpartner/HX3/PLATINEN/Drawbars/Drawbars_mk3_simple_dimension.pdf

R40
R41

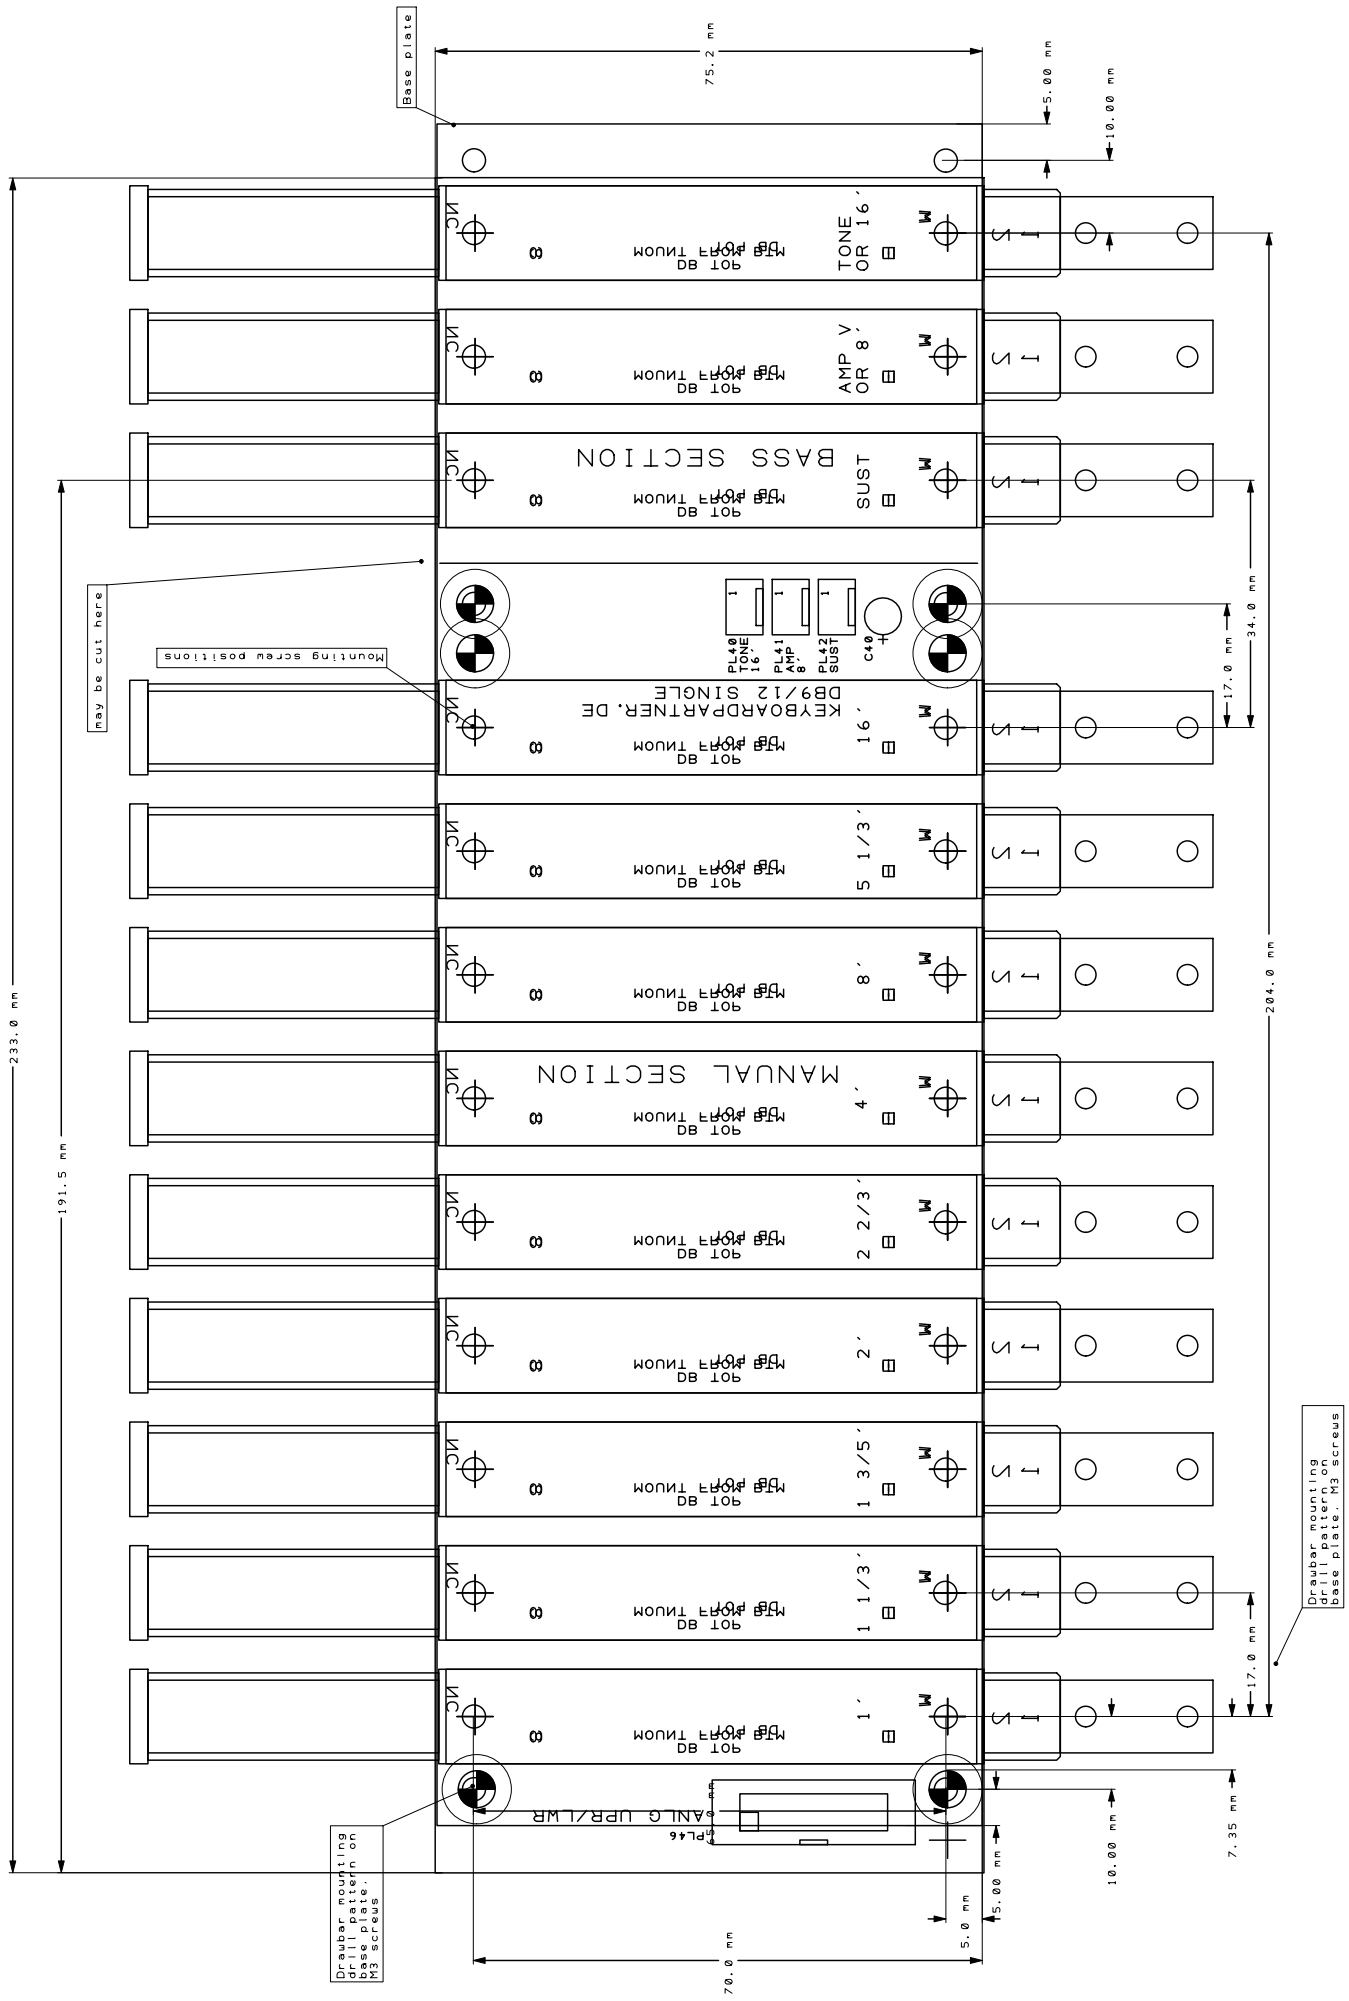
[picture p69: page 1]
