keyboardpartner/HX3/PLATINEN/Extension_mk3/HX3_extension_dimensions.pdf

C18

C23

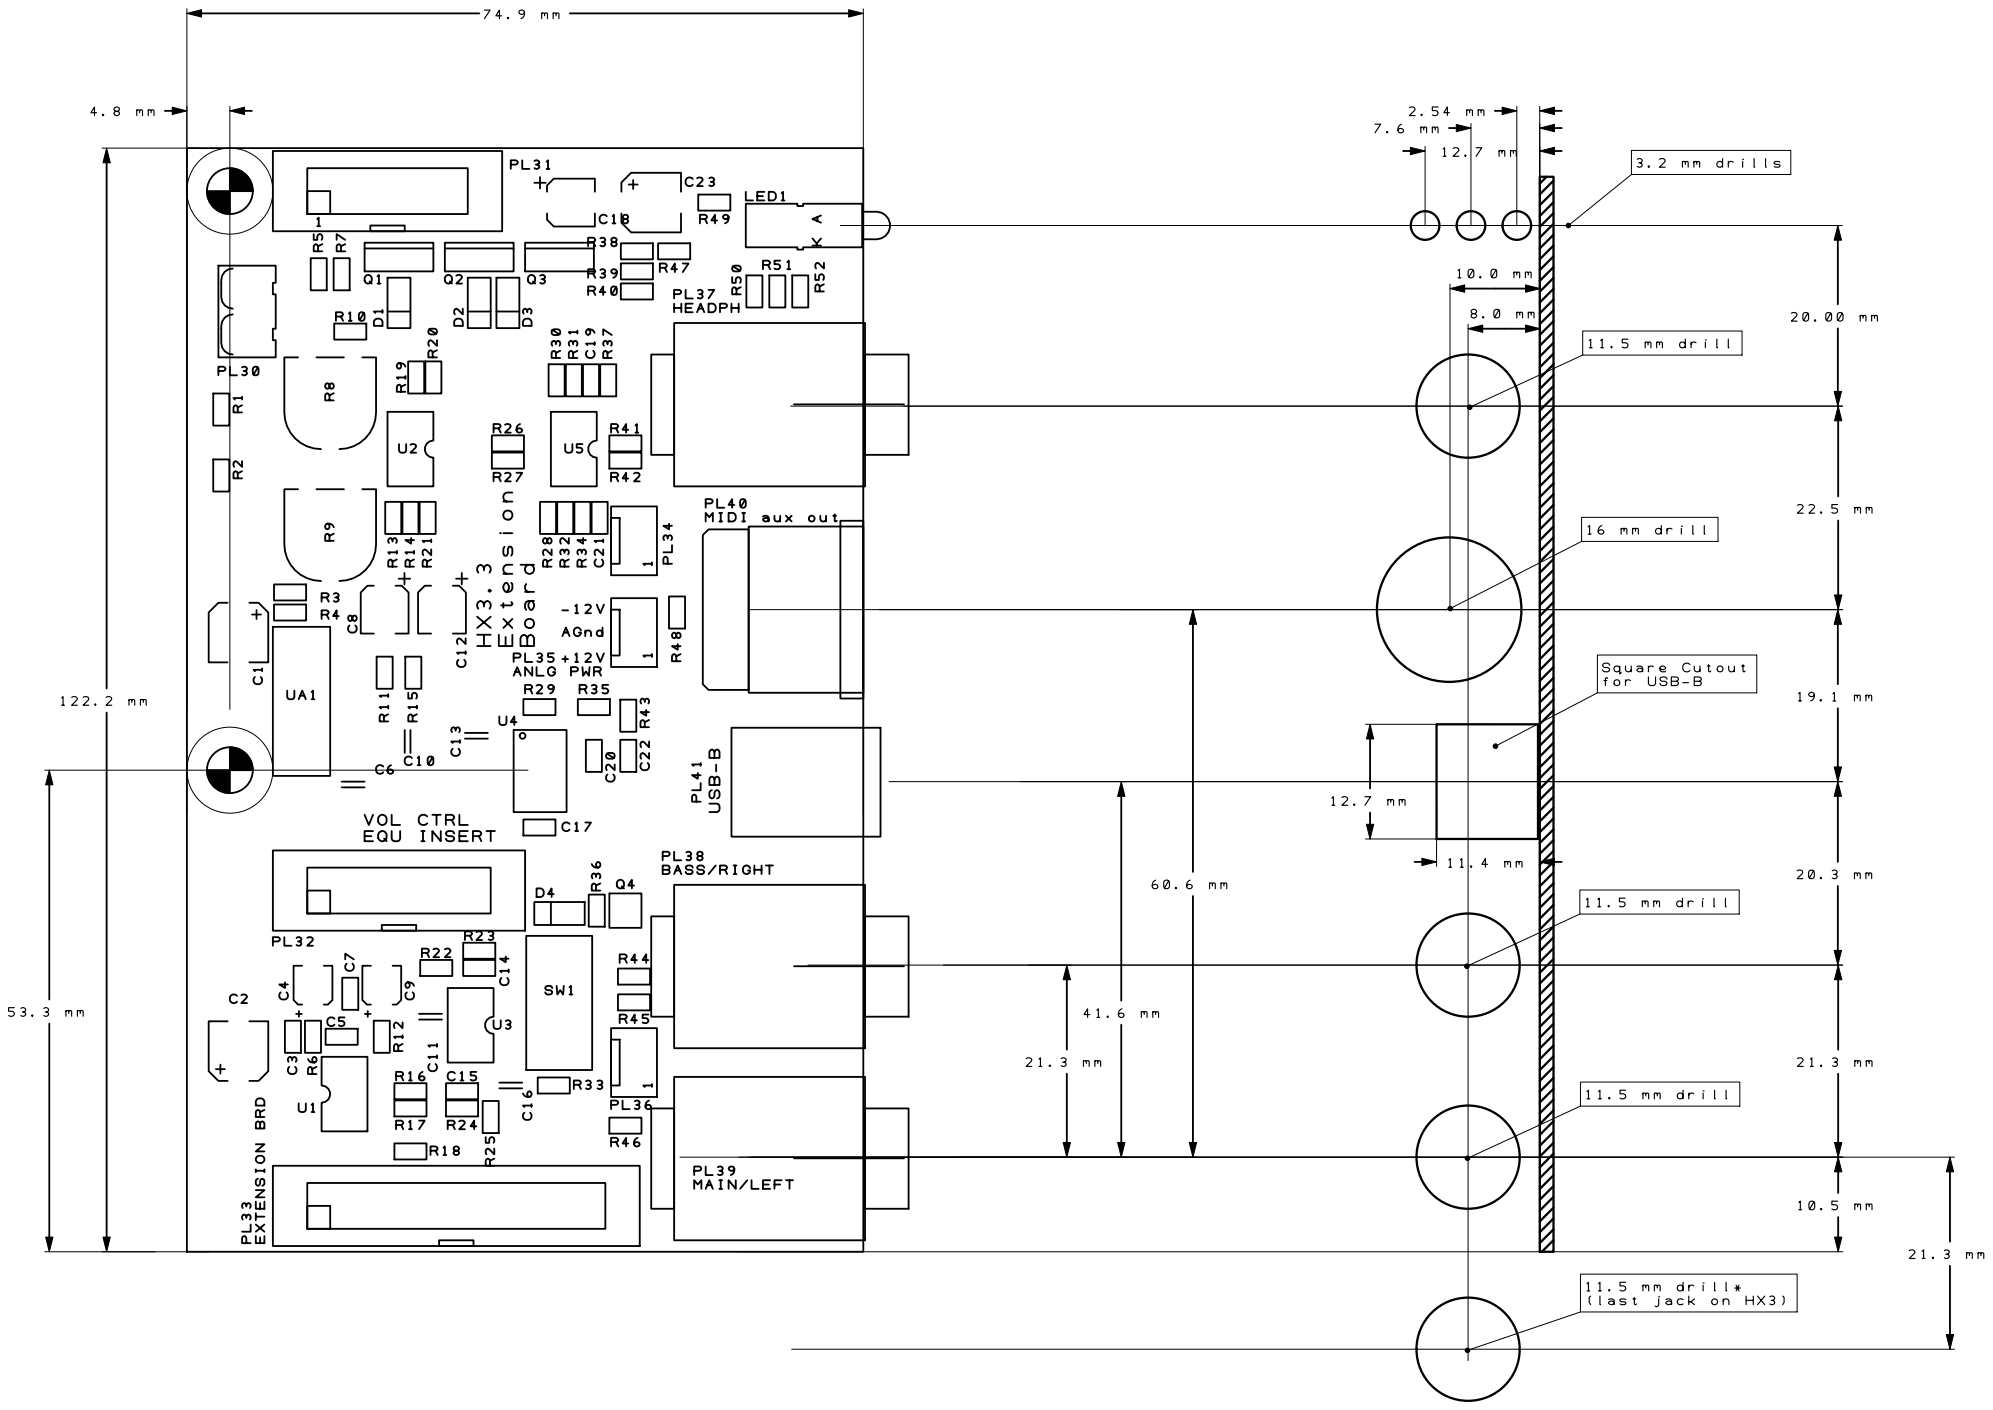
[picture p70: page 1]
