keyboardpartner/HX3/PLATINEN/FatarScan/FatarScan2 (PCB).pdf

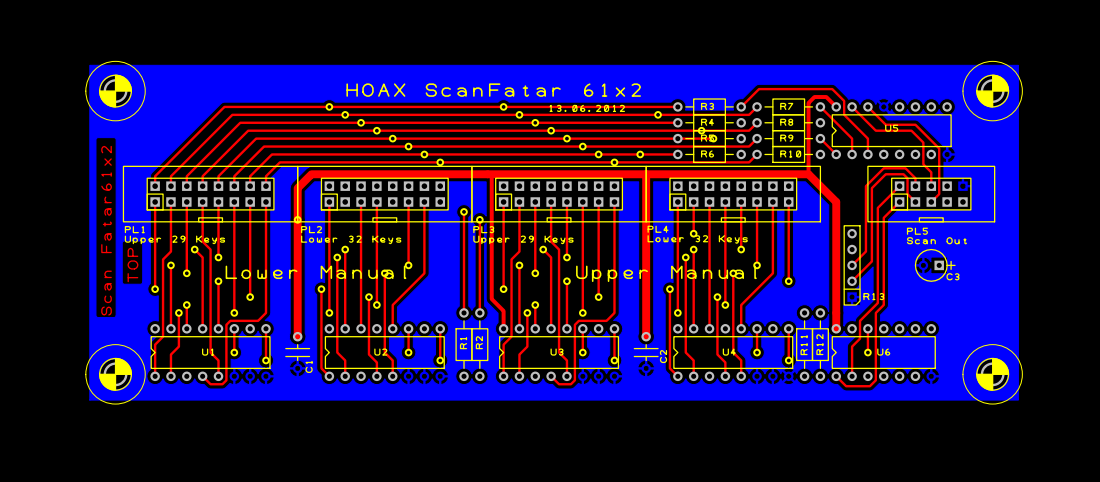
[picture p71: page 1]
