keyboardpartner/HX3/PLATINEN/FatarScan/FatarScan2 (schem).pdf

# Fatar Matrix 61 Keyboard

# To Fatar Kbd

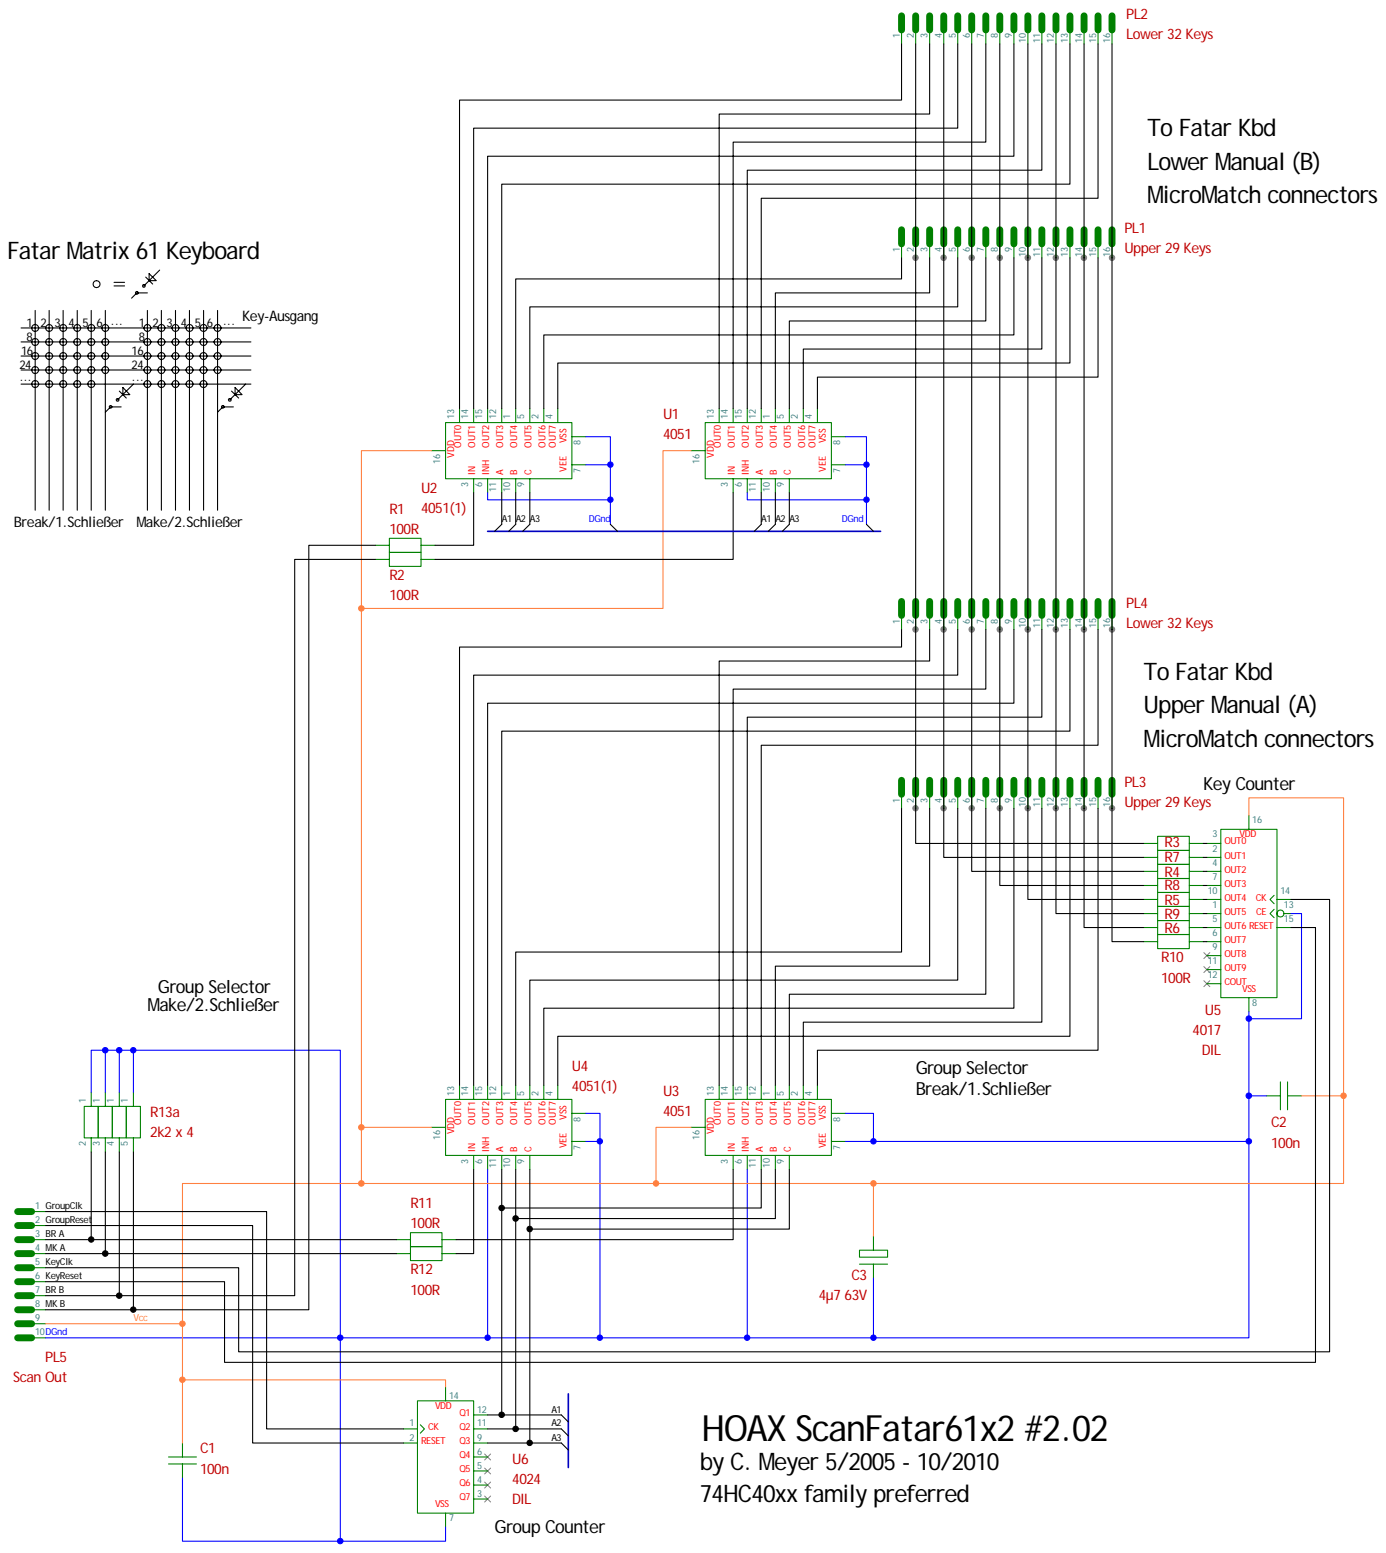
[picture p72: page 1]

Break/1.Schließer Make/2.Schließer
