keyboardpartner/HX3/PLATINEN/FatarScan/FatarScan2_dimensions.pdf

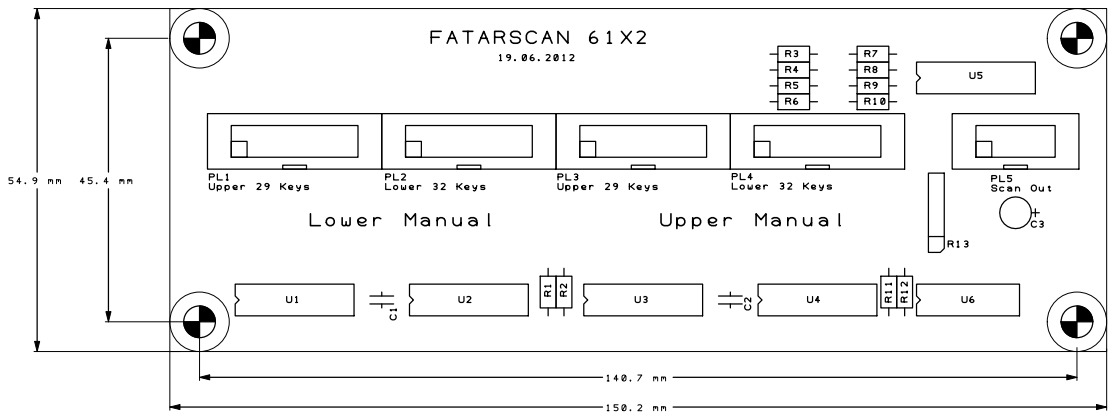
[picture p73: page 1]
