keyboardpartner/HX3/PLATINEN/Leslie_IF/bottom_LDR_Leslie_IF.pdf

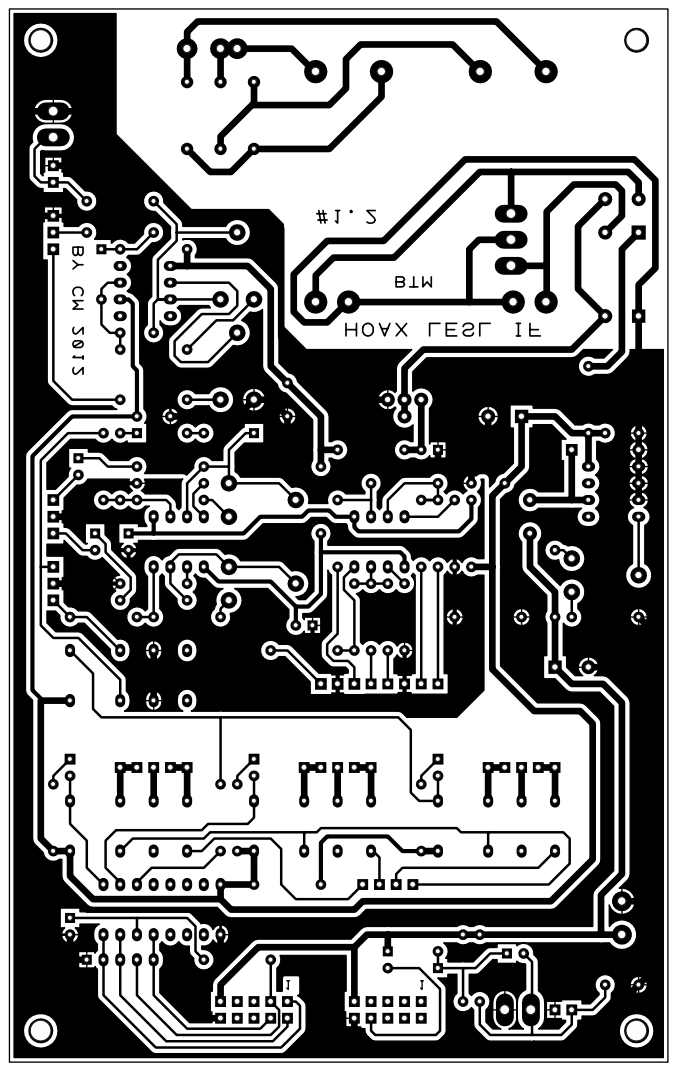
[picture p74: page 1]
