keyboardpartner/HX3/PLATINEN/Leslie_IF/silk_LDR_Leslie_IF.pdf

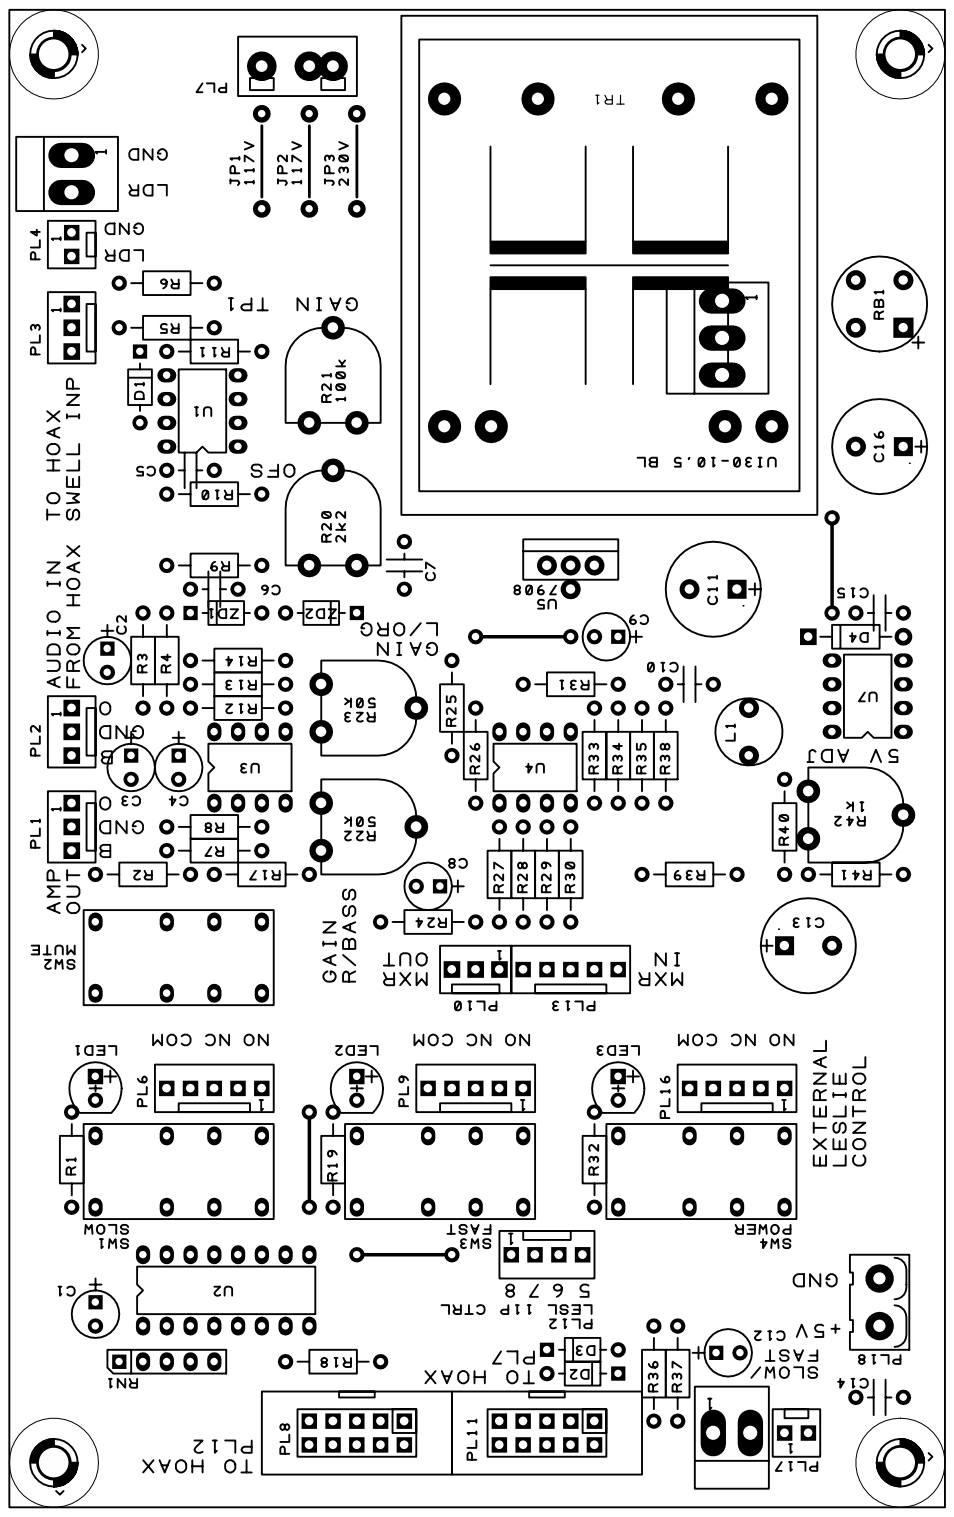
[picture p75: page 1]
