keyboardpartner/HX3/PLATINEN/MenuPanel/DisplayPanel_std - PCB_bottom_silk.pdf

C2

C5

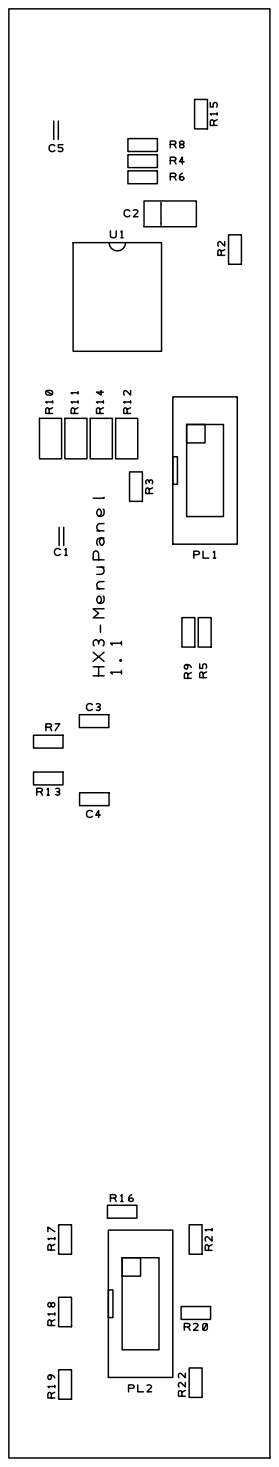
[picture p76: page 1]
