keyboardpartner/HX3/PLATINEN/MenuPanel/DisplayPanel_std_42mm_dimensions.pdf

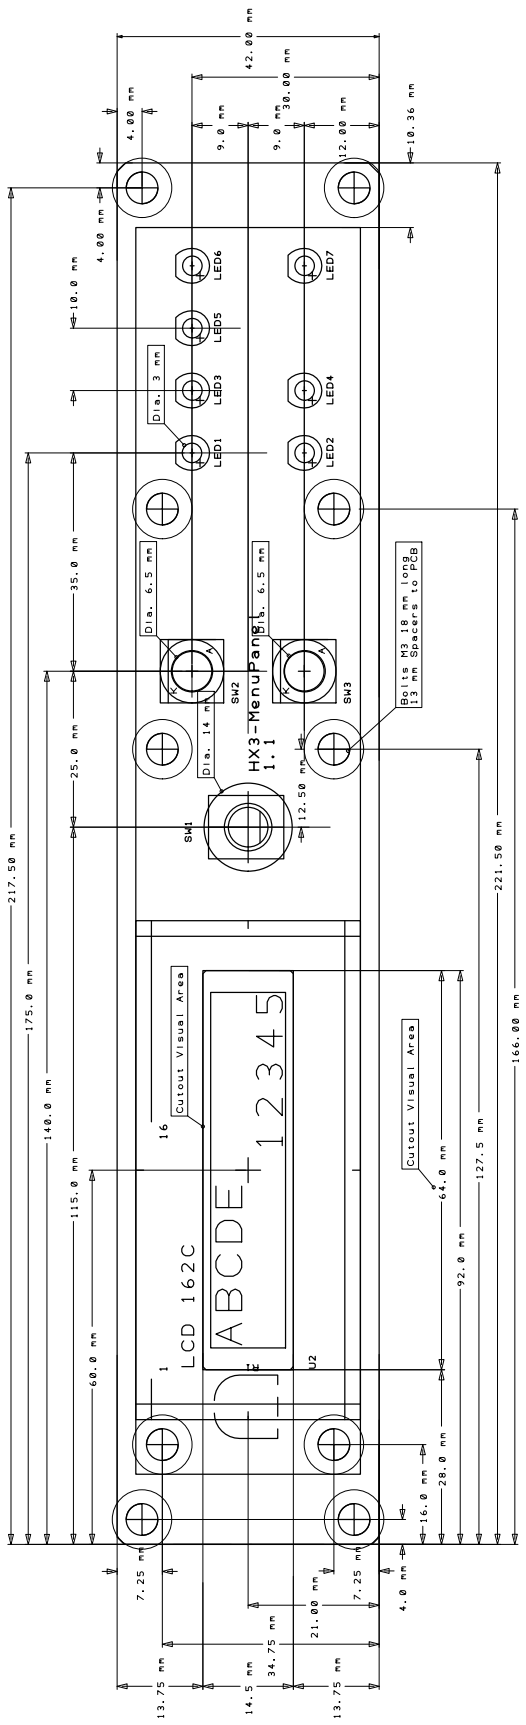
[picture p77: page 1]
