keyboardpartner/HX3/PLATINEN/MenuPanel/DisplayPanel_std_daub_dimensions.pdf

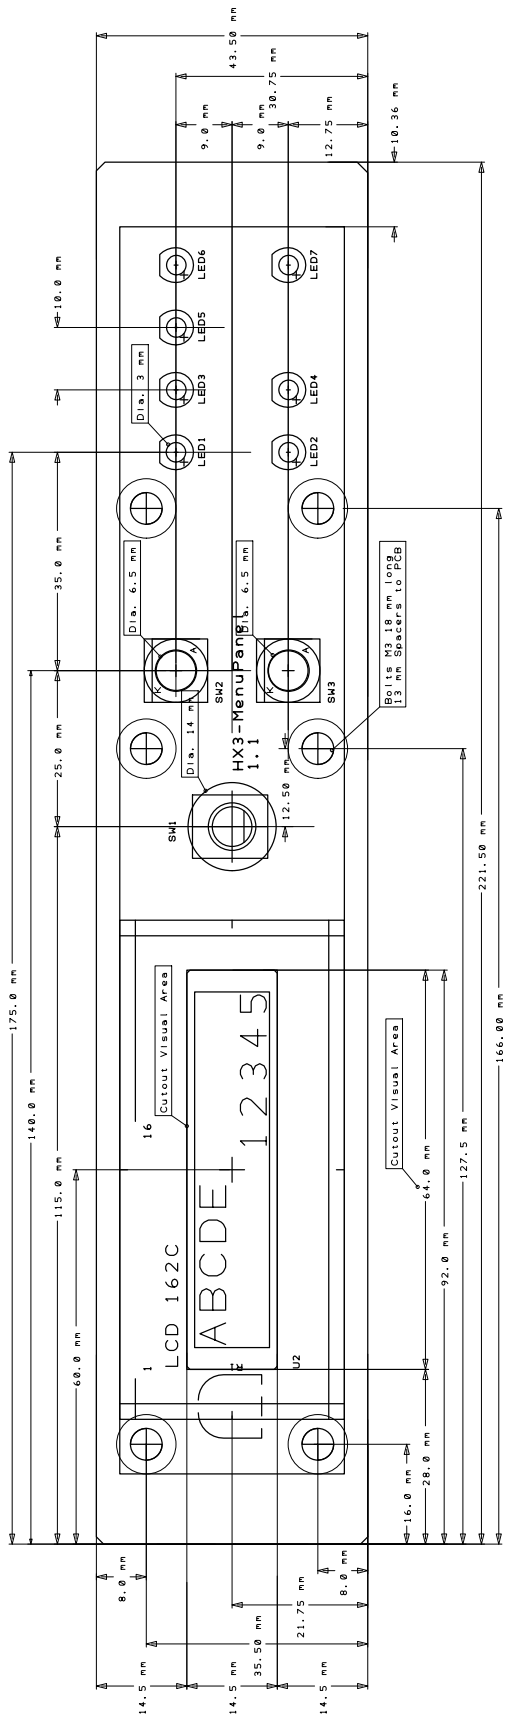
[picture p78: page 1]
