keyboardpartner/HX3/PLATINEN/MenuPanel/DisplayPanel_std_silk_bottom.pdf

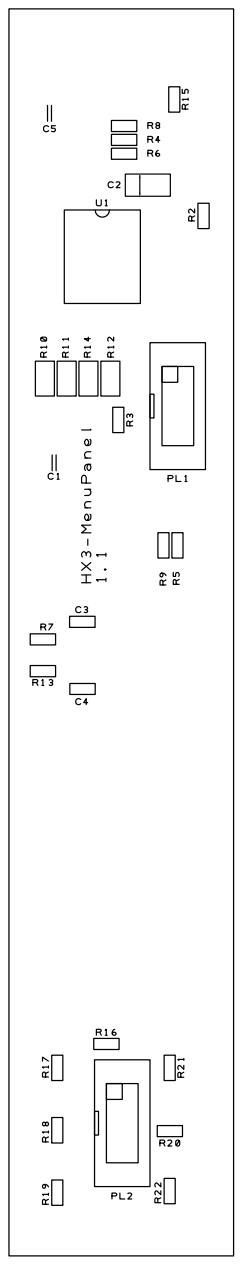
[picture p79: page 1]
