keyboardpartner/HX3/PLATINEN/MenuPanel/DisplayPanel_std_silk_top.pdf

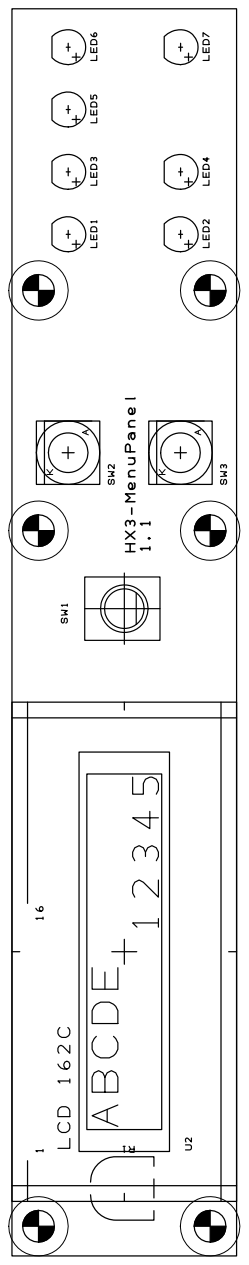
[picture p80: page 1]
