keyboardpartner/HX3/PLATINEN/OrganScan61/board_OrganScan61.pdf

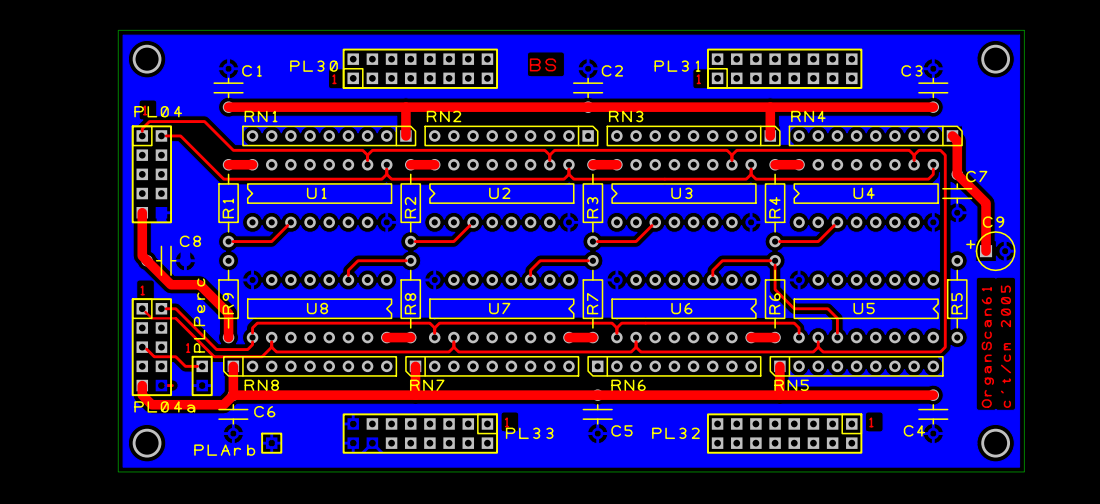
[picture p81: page 1]
