keyboardpartner/HX3/PLATINEN/Panel16/board_PANEL16.pdf

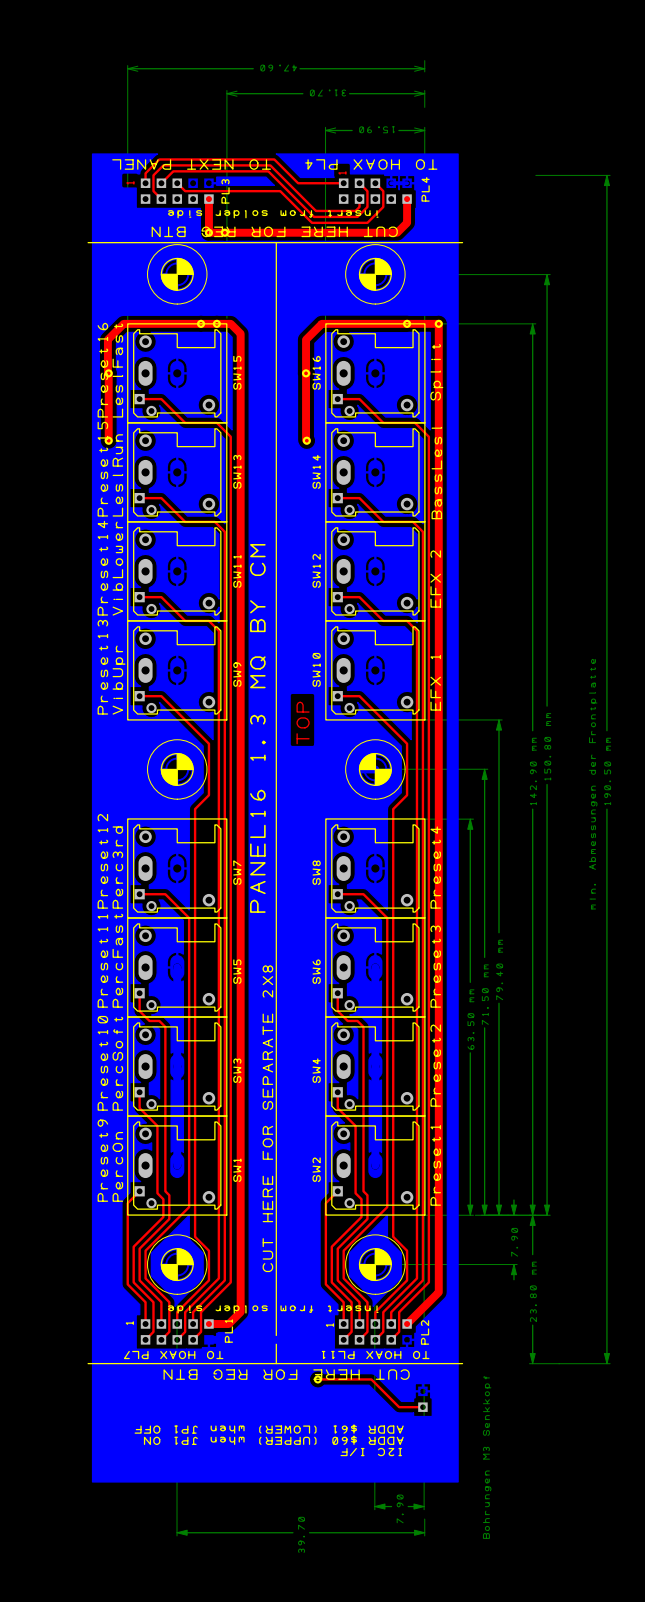
[picture p82: page 1]
