keyboardpartner/HX3/PLATINEN/Panel16/Panel16_dimensions.pdf

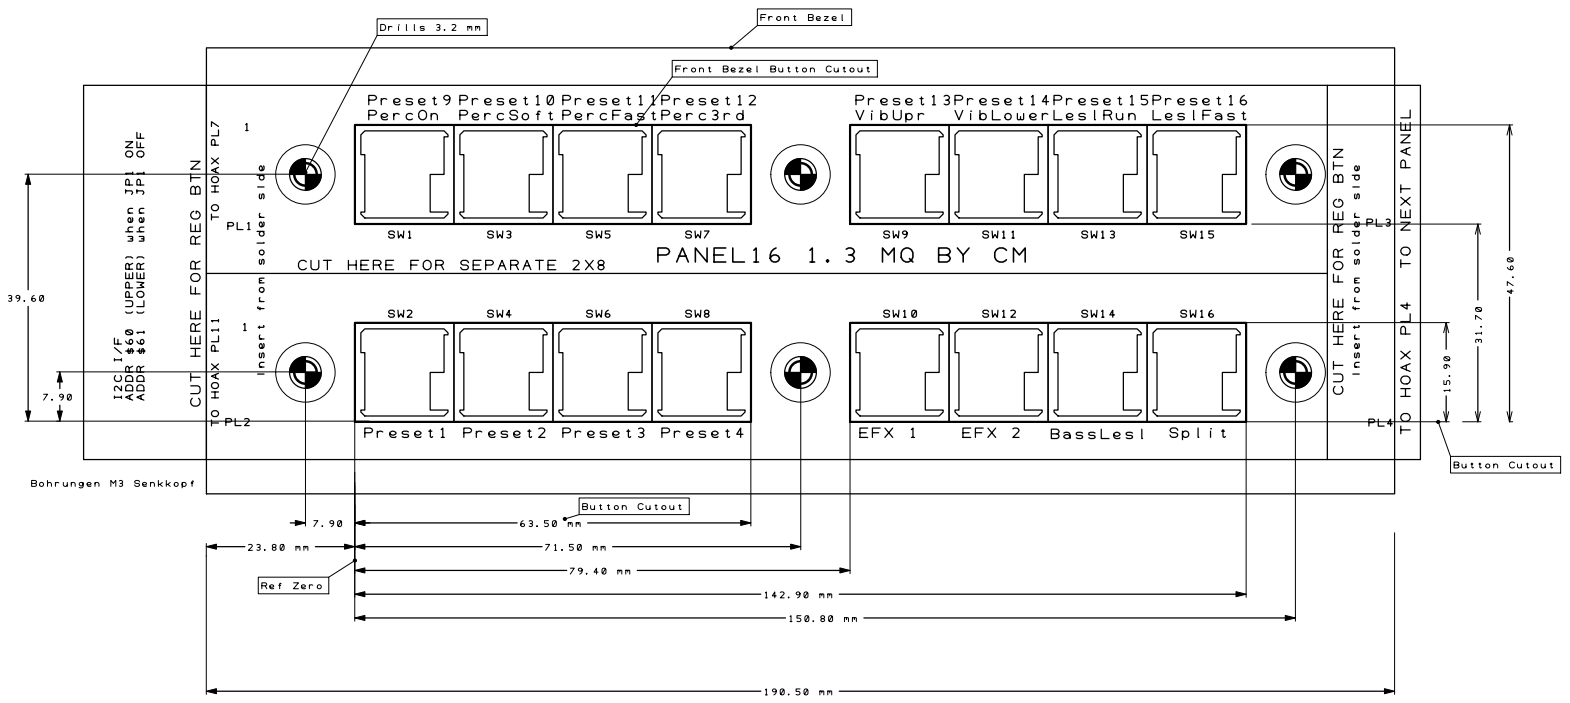
[picture p83: page 1]
