keyboardpartner/HX3/PLATINEN/Panel16/silk_bottom_PANEL16.pdf

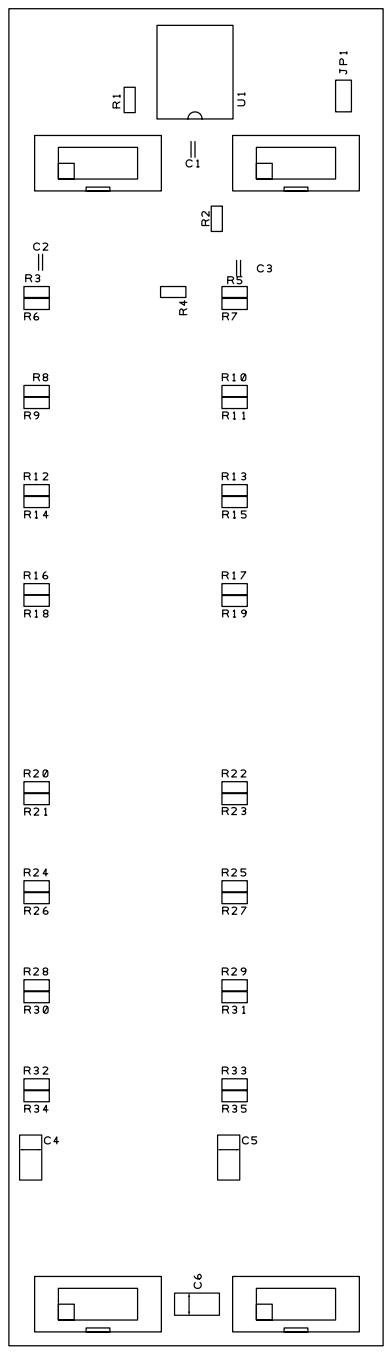
[picture p84: page 1]
