keyboardpartner/HX3/PLATINEN/Panel16/silk_top_PANEL16.pdf

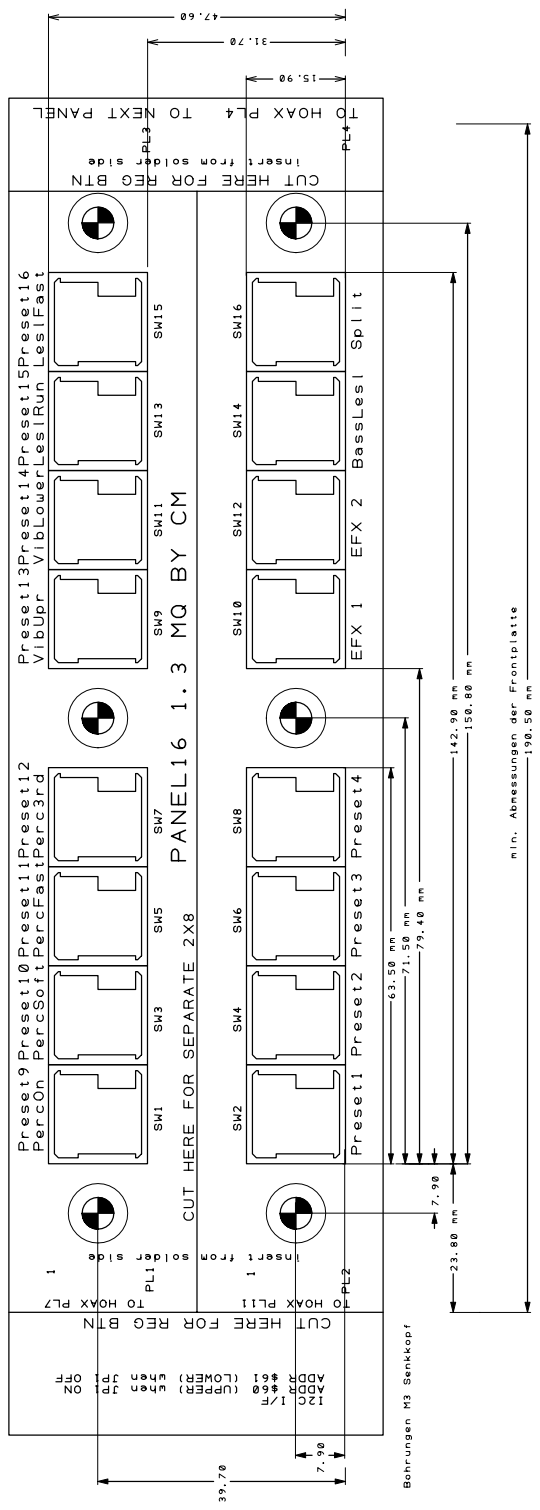
[picture p85: page 1]
