keyboardpartner/HX3/PLATINEN/Preset12/board_PRESET12_MPX.pdf

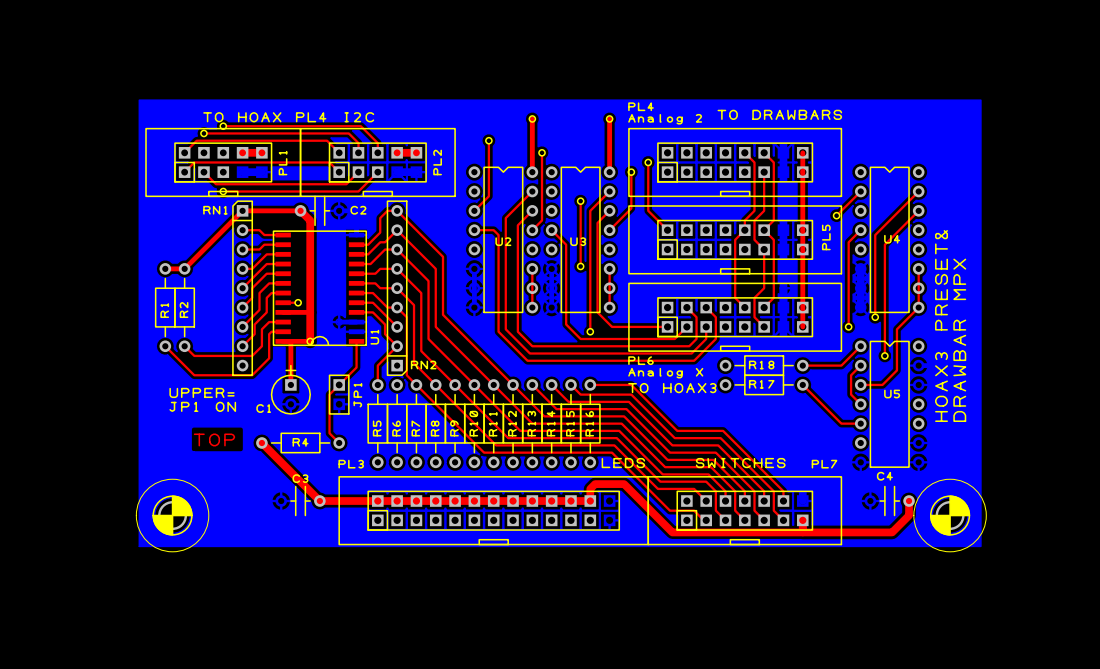
[picture p86: page 1]
