keyboardpartner/HX3/PLATINEN/Preset12/silk_PRESET12_MPX.pdf

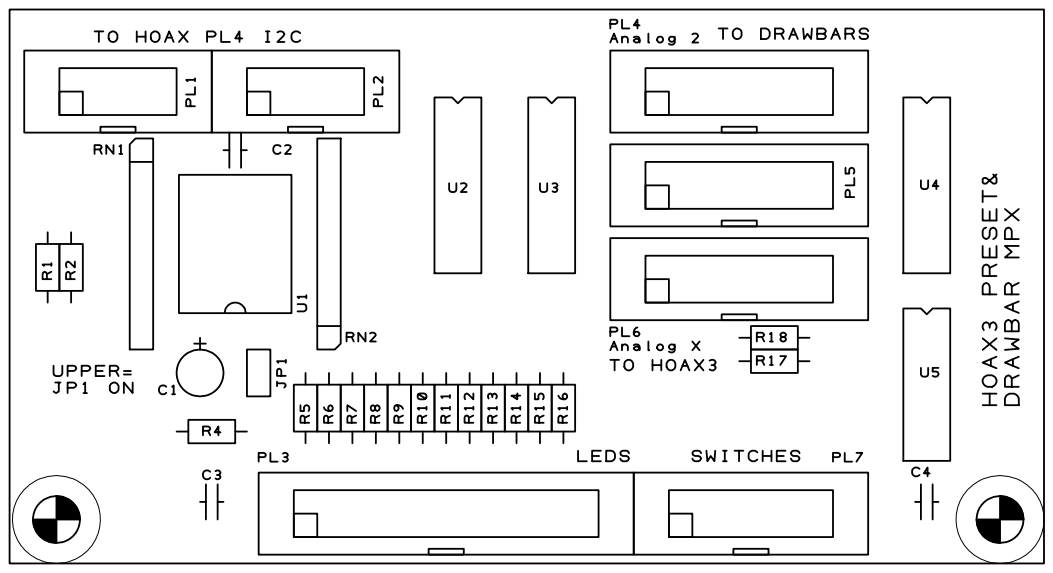
[picture p87: page 1]
