keyboardpartner/HX3/PLATINEN/Preset24/schem_PRESET24_MC.pdf

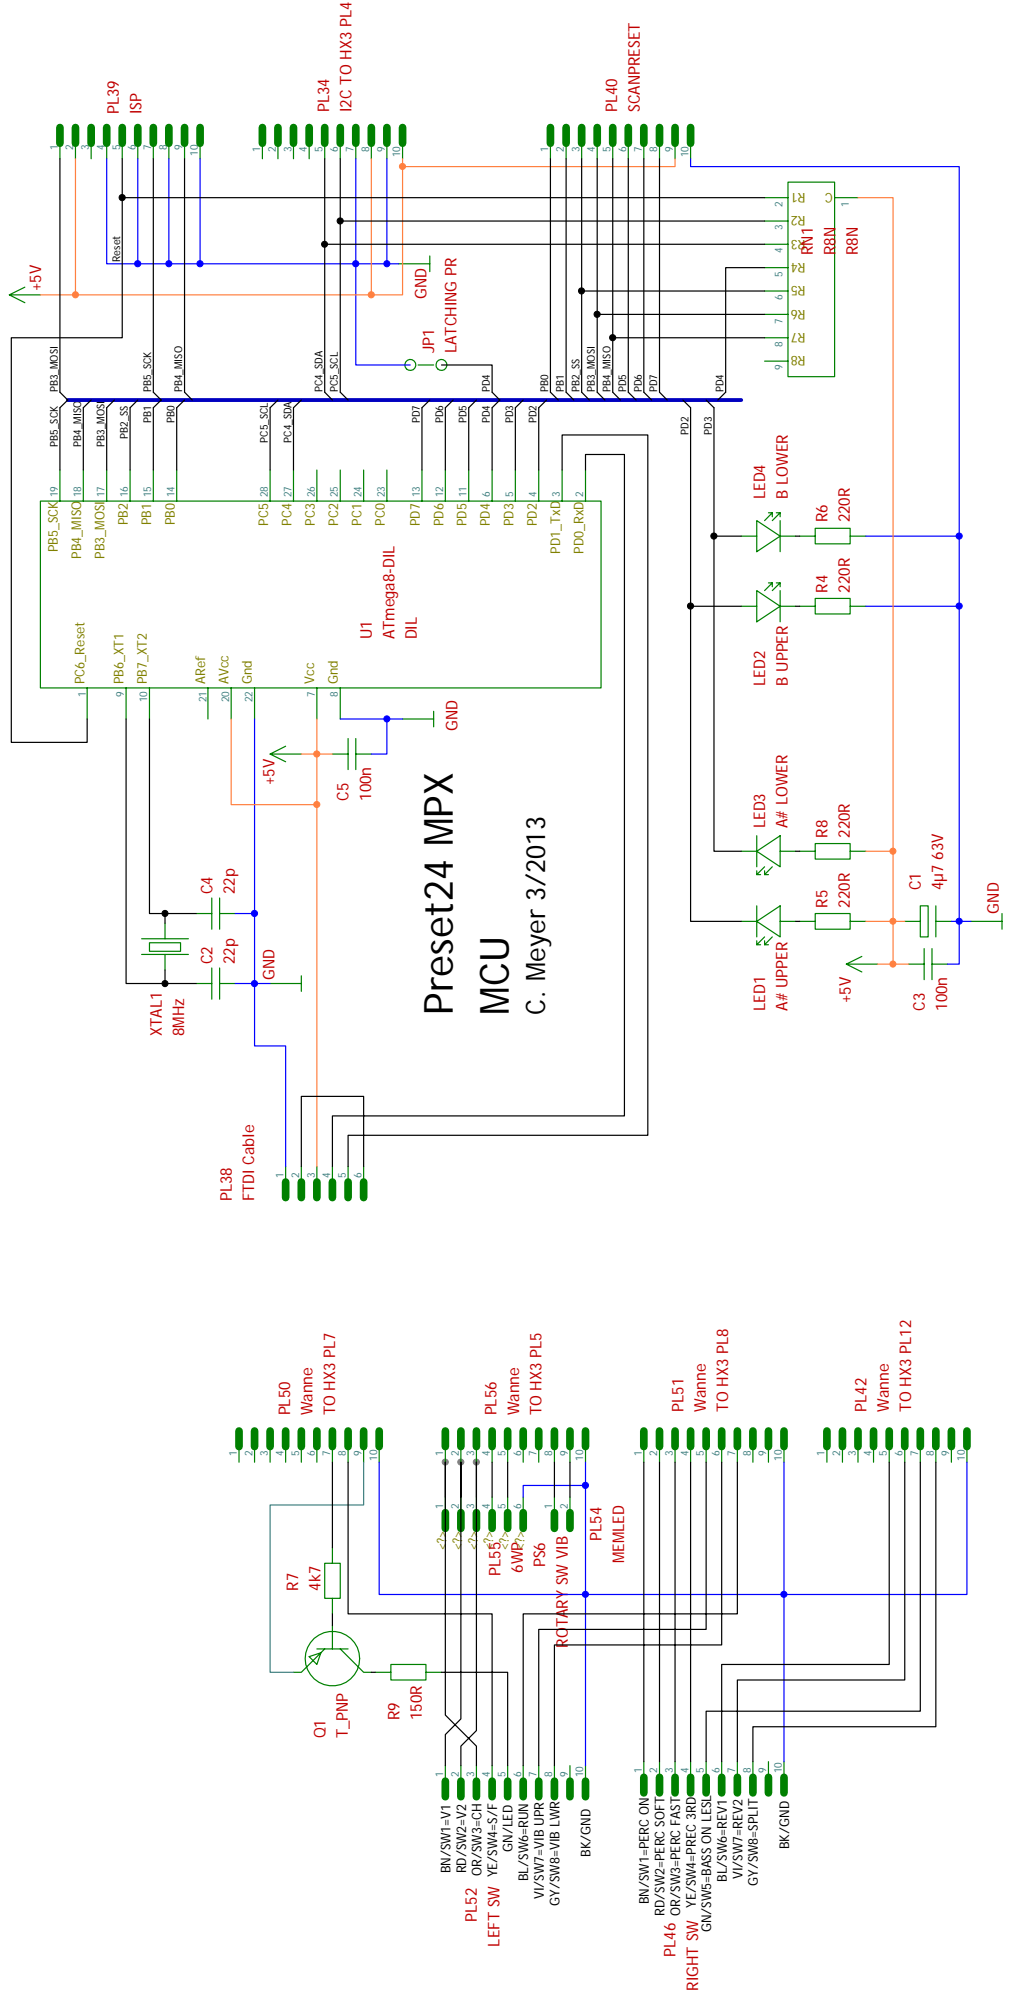
[picture p88: page 1]

GN/SW5=BASS ON LESL
