keyboardpartner/HX3/PLATINEN/Preset24/silk_PRESET24_MPX.pdf

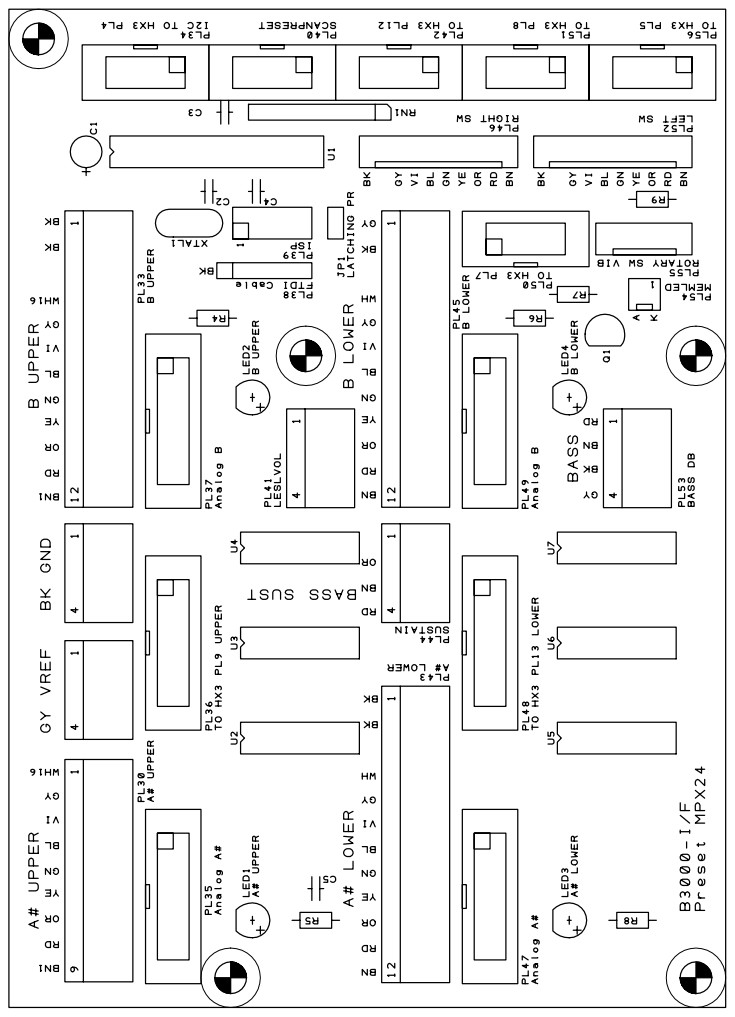
[picture p89: page 1]
