keyboardpartner/HX3/PLATINEN/Scan4014-61_Inline/board_Scan4014_inline.pdf

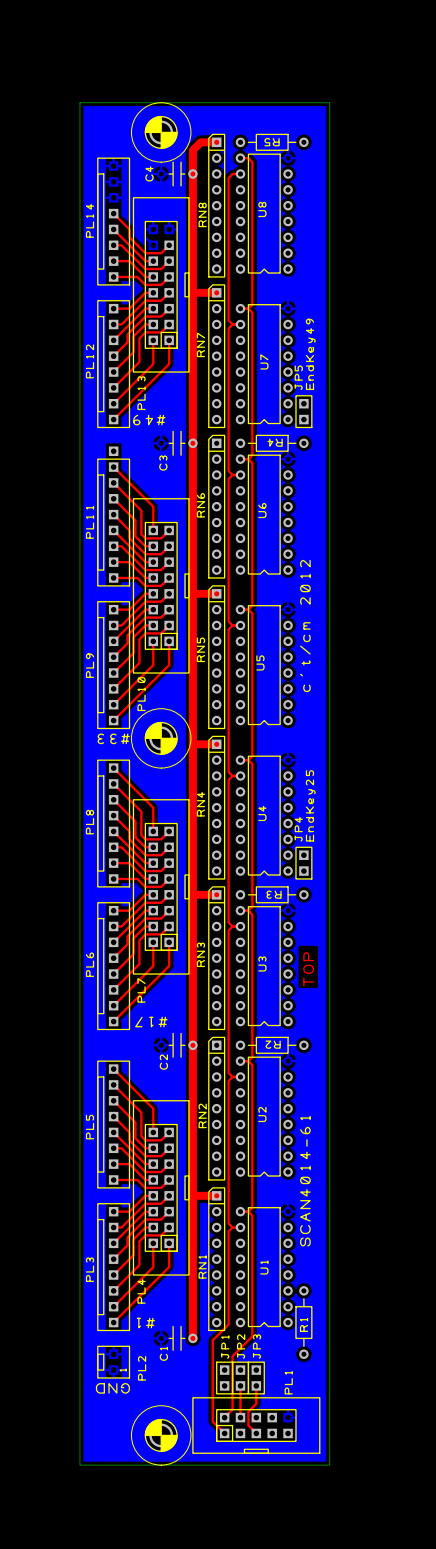
[picture p90: page 1]
