keyboardpartner/HX3/PLATINEN/Scan4014-61_Inline/silk_Scan4014_inline.pdf

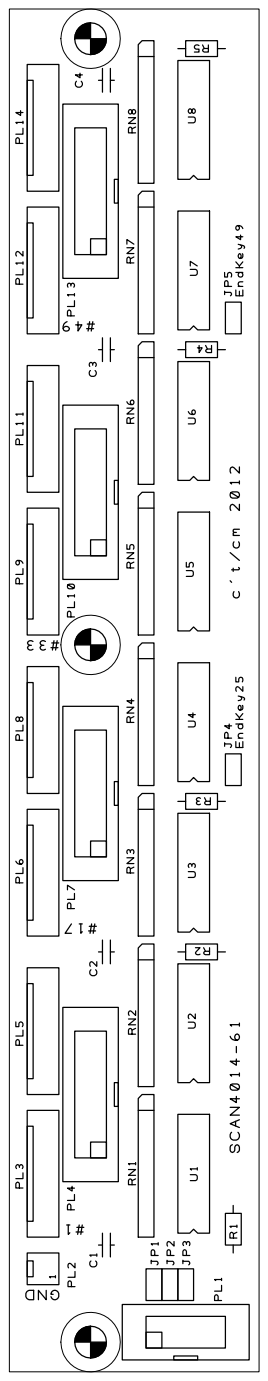
[picture p91: page 1]
