keyboardpartner/HX3/PLATINEN/XB2_mk3/schem_XB2_LCD_30.pdf

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

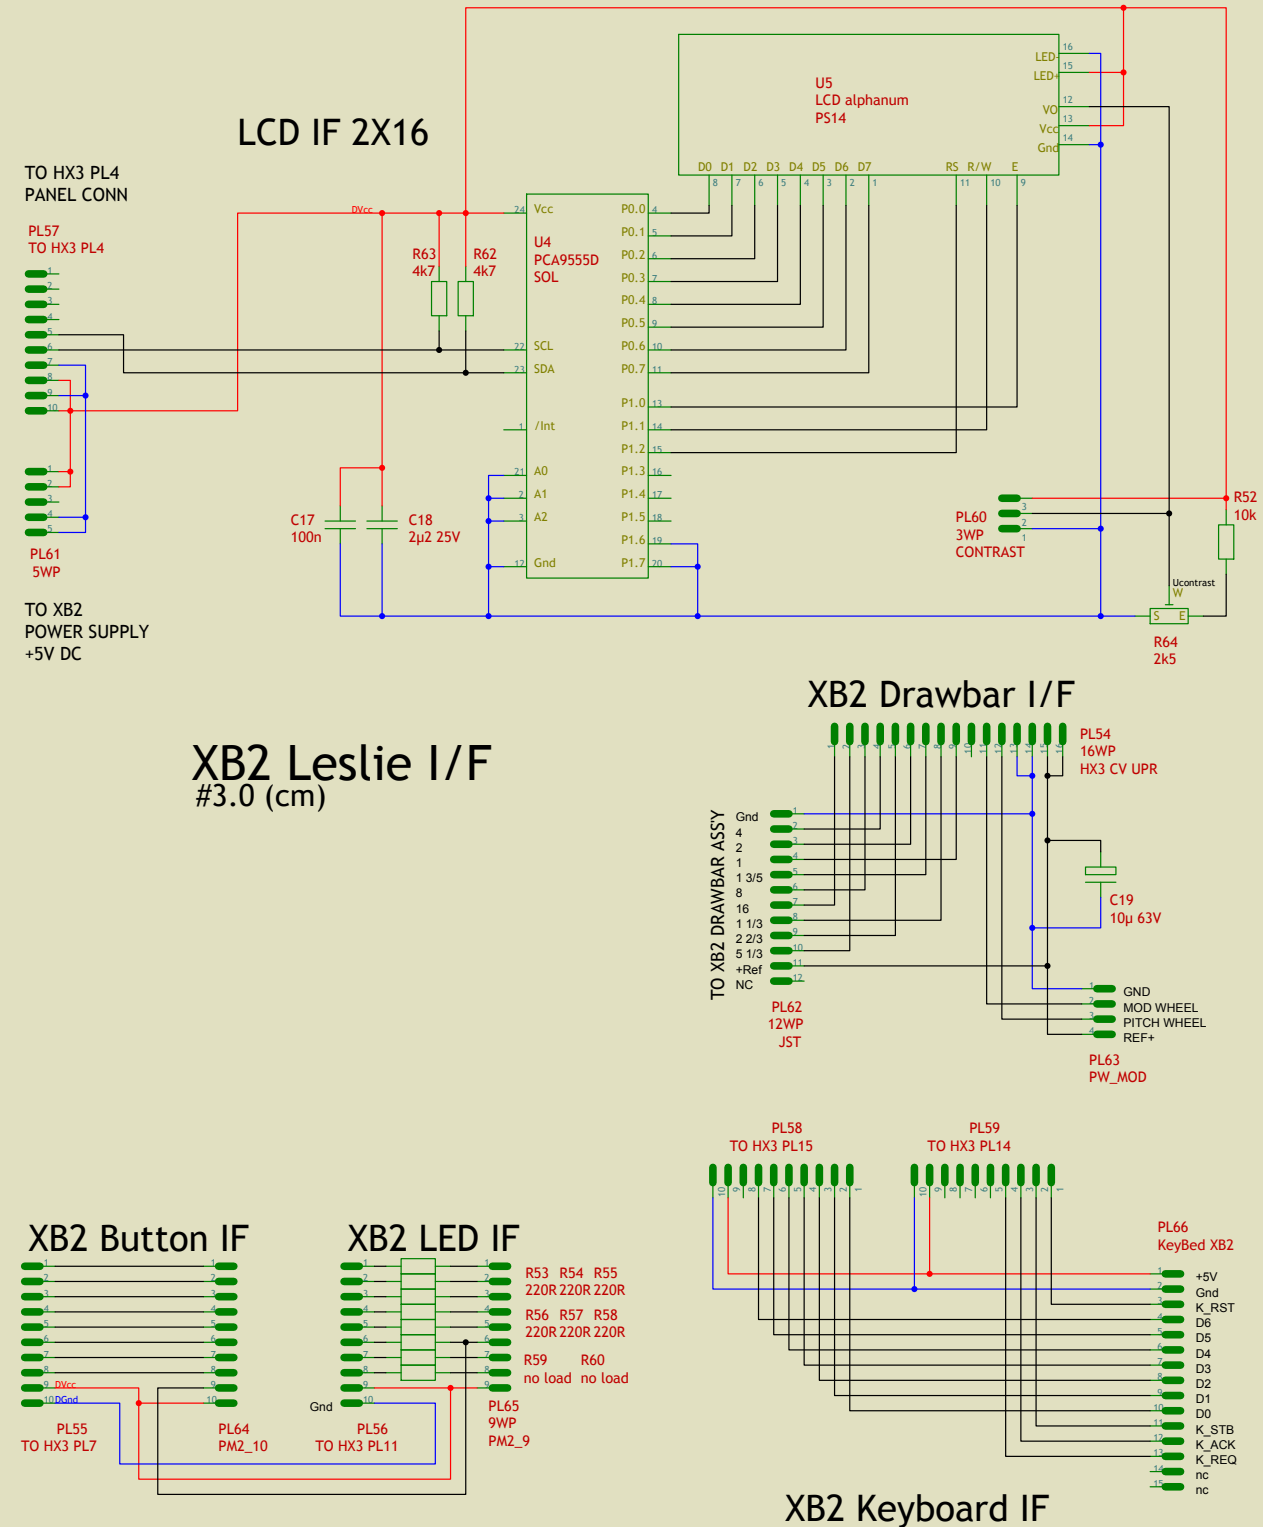
[picture p93: page 1]
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
