keyboardpartner/HX3/(commit log)

2015-03-17 moved repo
    [Drawbar_R_divider.xls, HOAX3_MIDI.xls, HOAX3_Syntax.xls, HOAX3_mk3_Syntax351.xls, HOAX3_mk3_Syntax363.xls, HOAX3_mk3_Syntax370.xls, HX_fatar.psm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]
2015-03-17 FW 3.74
    [HX_fatar.psm, HX_midi.psm]
2015-03-24 beta testers only
    [GeneratorLevels.csv, WiringData.csv]
2015-03-27 ftdi driver for HX3
2015-03-27 FTDI DRIVERS.zip
2015-03-29 new ScanCores #16
    [HX_fatar.psm, HX_midi.psm]
2015-07-24 added HX3mk4 schematics
2015-08-10 new schematics for MPX drawbars
2015-10-10 vib switch bugfix
2016-09-28 Firmware 4.1 for mk3/mk4
    [HOAX3_Syntax.xls]
2017-02-25 Manuals updated to FW #4.22
    [HOAX3_MIDI.xls]
2017-04-14 ScanCores #33
    [HX_fatar_33.psm, HX_midi_33.psm]
